the-feve/rocket-builder-web/README.md

# Rocket Builder Web

A website for designing a 3D-printable model rocket and downloading print-ready STLs. The plan is in `docs/web_platform_spec.md`.

The geometry is a Python port, on build123d (OpenCascade), of the Onshape FeatureScript generator in [OS_Rocket_Builder](https://github.com/the-feve/OS_Rocket_Builder) (`src/RocketGenerator.fs`). That generator stays the reference design.

| Folder | What |
|---|---|
| `geometry/` | `rocketgen`, the geometry engine: parameters in, one solid per part out, STL export. See `geometry/README.md` and `geometry/report.md`. |
| `server/` | The designer website: FastAPI + one page with a three.js preview. See `server/README.md`. |
| `docs/` | Platform spec and plan |

## Status

- **Phase 0 (spike):** done.
- **Phase 1 (feature parity with the FeatureScript):** done, apart from two cosmetic items listed in `geometry/report.md`.
- **Phase 2 (local web prototype):** done. Form → build → 3D preview (exploded, section) → ZIP of print-oriented STLs. Styled to match fevergeon.com / quiverdesignworks.net (same greys, accent and buttons); follows the system light/dark setting, with a header toggle to pin one. Works on iPhone and iPad: the preview fills and follows the screen through rotation, sits above the form on phones, renders only when the view changes, and uses 16 px touch-sized fields so iOS doesn't zoom.
- **Phase 3 (hosted beta):** in progress.
  - Done: stability check (Barrowman CP, CG from the parts + motor + recovery; under 1.0 cal the ZIP is withheld); standard fins auto-grow (span and sweep) until the heaviest motor of the size is stable; motor picker (flight sim of every motor in the bay, recommendation for a target altitude, per-motor stability); saved designs and share links (`/d/<id>`, SQLite, edit key per browser until sign-in exists), `Dockerfile`.
  - Ready to host: `/healthz`, per-address rate limits on new builds and saves, a 60 s wait limit for the build lock, error logging, three.js served from the app. CI (`.github/workflows/ci.yml`) runs both test suites and builds and smoke-tests the Docker image; `deploy.yml` deploys to Fly.io on every push to `main` once the `FLY_API_TOKEN` secret is set.
  - Live on Fly.io since 2026-10-09 at https://rocket-fevergeon.fly.dev.
  - Open: `rocket.quiverdesignworks.net` (after quiverdesignworks.net's DNS moves to Cloudflare; planned since 2026-10-11, formerly rocket.fevergeon.com); Cloudflare Access for the invite-only beta; checking a few designs against OpenRocket.

```
cd geometry && pip install -e ".[test]" && python -m pytest -q
python -m rocketgen.cli --fins swept --out out/m18_swept --png

cd ../server && pip install -r requirements.txt && uvicorn app:app --reload   # open http://127.0.0.1:8000
```

Or in Docker, from the repo root: `docker build -t rocket-builder . && docker run -p 8000:8000 -v rocket-data:/data rocket-builder`.

## Hosting

Fly.io, app `rocket-fevergeon` in Seattle (`fly.toml`): one 1 GB machine that sleeps when idle, and a 1 GB volume at `/data` for saved designs. Every push to `main` redeploys through GitHub Actions. Planned address `rocket.quiverdesignworks.net` (Quiver Design Works hosts everything paid; decided 2026-10-11), a CNAME in quiverdesignworks.net's Cloudflare DNS, with Cloudflare Access in front during the invite-only beta.
