the-feve/rocket-builder-web/HANDOFF.md

# Handoff

_Last updated 2026-10-18 (guide and tutorial changes; brand kit, curriculum, assembly guide and kit packaging in docs/)._ Read this first, then `TODO.md` (ordering, payment and data to-dos), `README.md` (Status) and `docs/web_platform_spec.md`._

## Where things stand

- **Owner links in the app (2026-10-18):** `/api/auth/me` carries `is_admin` (email in `ROCKETGEN_ADMIN_EMAILS`). Signed in as the owner, the account window shows *Owner: Order desk ↗* (quiverdesignworks.net/admin/orders) and *Printed-rocket orders* (`/admin`); *My orders* in the ⋯ menu and its dialog link the order desk too. Customers never see them.
- **Motor cap lip 2.5 mm (2026-10-18):** `params.CAP_LIP`; the nozzle hole is the motor diameter less 5 mm. Kit test prints regenerated (reprint the caps, E).
- **Secondary pages in the brand (2026-10-18, branch `claude/admiring-maxwell-c5difl`):** `/sources`, `/ordersupplies` (both builders), `/terms` and `/admin` now use the app's look: shared `server/static/brand.css` (tokens, self-hosted fonts, light/dark with the saved `theme`, `.rb-header`, `.rb-tag`, `.rb-step`, `.rb-tip`, `.rb-chips`, `.rb-footer`) and `server/brand.py` (`HEAD` links and `header(page, nav)` with the mark) for the server-rendered pages. The `/terms` HTML moved from `app.py` into `terms.page()`. The static pages copy the header markup by hand. Reuse `brand.css` for new pages.
- **Lug bore and kit test prints (2026-10-18, branch `claude/admiring-maxwell-c5difl`):** launch lug bore is now 4.0 mm on a 1/8 in rod (`lugs.LUG_BORE_CLEARANCE` = 0.4125 mm per side, was 0.3: the owner's lugs were a little too snug); rod standoff clip unchanged. `docs/kits/test-prints/` has print-ready STLs, `design.json`, the app ZIP, a README and a preview per kit (Starter M18 300 mm, Big M24 360 mm, Mini M13 190 mm), from `tools/make_test_prints.py` (rerun after geometry changes). All three built stable as designed; no adjustments.
- **Session of 2026-10-18 (PR #39, merged and deployed 2026-10-18):** plan in `docs/expansion_spec_2026-10.md`.
  - App (`server/static/index.html`): the quick start opens with *How it works* only; the stability explainer and a new motor letters / sizes / field table are in a collapsed *More on rocket sizing and rating systems*. Altitude ranges come from `flight.simulate` at typical printed masses and the fields from `FIELD_M`. Full guide: new *Sizing a rocket* section. Added a *Restart tutorial* button by the mode switch, an (i) help pop-up on every Advanced section, more dimming in the tutorial (inactive steps show only their heading) and shorter Beginner text. Step 3 now says body pieces *slide* together (only the motor cap is threaded). `gear.json`: the motor pack note no longer says "start with an A" (A8 fails for most printed 18 mm rockets).
  - `docs/brand/`: brand kit ("fins are fletching"), `tokens.css` using the app's token names, logos, patterns, `brand-sheet.png`. **Not applied to the app yet**: owner to decide (suggestions at the end of `brand.md`).
  - `docs/curriculum/`: a 10-day (or 5-day) home-school unit for grades 5–8, with printable `worksheets.html` (`tools/gen_ws.py`).
    - **On the site at `/learn/`** (overview for parents, `/learn/day-01` … `day-10`, `/learn/safety`, `/learn/worksheets` and `/learn/worksheets.pdf`): static pages in `server/static/learn/`, generated by `docs/curriculum/tools/build_site.py` (rebuild after editing a lesson; see the curriculum README's Files table). `learn.css` is hand-written with the brand tokens. Routes in `app.py` whitelist the page names. Linked from the app header (Free lessons), the quick start and quiverdesignworks.net.
  - `docs/assembly/`: a 7-page printable assembly guide (`assembly-guide.pdf`) with renders from rocketgen (`tools/README.md` regenerates them). **Owner questions** in its section of `TODO.md`.
  - **Second round (same day):** the brand is applied to the app (tokens, fonts, header mark, favicon in `server/static/brand/`, a ⋯ menu for less-used design actions, segmented view options, a ▾ download menu and folding sections in Advanced). `launch.html` is redrawn in the kit-art style (the launch API now returns `shape`). **Shock-cord clearances are sized for elastic** (`params.py → SHOCK_CORDS`, 3.6 mm per cord pass; M13/M18 noses got a deeper tie-bar recess; see `geometry/report.md`). The assembly guide is re-rendered from the new geometry, with medium CA glue (adult only) and elastic cord. Owner decisions: kits and motor flights are **12+**; the curriculum's under-12 track is paper rockets only; no Kevlar.
  - **Third round (2026-10-18, branch `claude/admiring-maxwell-c5difl` again):** unsafe designs now launch in the simulator, with a red *Watch it launch* / *Launch anyway* and a "Not safe to fly" panel. `flight.launch_profile` takes the motor's `margin_cal` and the rocket's length: under 1 cal a pitch model (`PITCH_K`, `PITCH_DAMP`, `TIP_OFF`) makes it wobble, under 0 it tumbles with side-on drag; `flight_dangers()` lists the reasons in plain words. Path points carry the attitude. The launch API flies the closest motor when none passes. The simulator can fly up to 3 other rockets alongside as see-through ghosts (this visit's builds and saved designs, via `sessionStorage.rbCompare`, written by the designer) with a comparison table. The quick start is laid out like the printed guides (kicker, big heading, short steps, one main button, links), and the fonts are self-hosted in `server/static/fonts/` (OFL), no Google request.
  - `docs/kits/`: kit lineup (Starter M18 $29.99, Big M24 $39.99, Mini M13 $16.99, classroom 6-pack $99), BOM and costs, packaging dielines and artwork, compliance notes, AI design tool research, and draft `products.json` entries for quiverdesignworks-site (not applied).
- Everything is on `main` and deployed (latest: PR #29, personal-use file license, 2026-10-15). No open PRs. Also live at https://rocket.quiverdesignworks.net.
- **Session of 2026-10-14/15 (PRs #23–#29), newest entries below:** heights snap to ones that build (printer step before height), build retry after a restart, big order buttons, score advice outside 1–2 cal, order names with motor + customer code, parachute size, report divider, compare two rockets, launch field size, paid print orders through Stripe (**not switched on yet: Next steps 7**), personal-use file license. Parallel sessions had duplicated work (PR #21 closed unmerged; PR #22 kept); check open PRs and `git branch -r` before starting.
- **Start here next session:** owner switches on paid orders (Next steps 7: restricted Stripe key, webhook, `ROCKETGEN_PUBLIC_URL` on Fly) and sets real prices / shipping in `server/shop.json`; one real order + refund from a normal browser. Then the open items in `TODO.md` (lawyer look at `server/terms.py`; beta print-and-fly checks).
- **Live since 2026-10-09: https://rocket-fevergeon.fly.dev** (Fly app `rocket-fevergeon`, region `sjc`, volume `rocket_data` mounted at `/data`). PR #1 is merged; pushes to `main` deploy automatically. Checked after the first deploy: `/healthz`, an M24 build (24.7 s cold, stable 1.13 cal, recommends C11), preview GLB, the STL ZIP, saving a design and its `/d/<id>` share link (test design `WNePTzVr`). The machine auto-suspends after about 7 idle minutes; a cold boot takes about 17 s before uvicorn answers.

- **Ordering switch (2026-10-15, owner: "not ready to start selling"):** printed-rocket ordering is **closed to the public by default**. Customers see a grey *Printed rockets: coming soon* panel instead of the order button, and `POST /api/orders` answers 403. Admin accounts (`ROCKETGEN_ADMIN_EMAILS`) still get the button and can place coupon or paid orders, so the whole flow (Stripe, webhook, `/admin`, PC sync, the QDW order desk) can be tested. **To open it:** `fly secrets set ROCKETGEN_ORDERING=open -a rocket-fevergeon` (unset it to close again). `/api/options` has `ordering_open`; users carry `can_order`.
- **Builder switcher (2026-10-15):** the header (and `/ordersupplies`) has a *Rocket Builder | Trebuchet Builder* control (`nav.apps`), the same one Trebuchet Builder shows.
- **Advanced additions (2026-10-17, owner's requests; branch `claude/inspiring-mayer-m1ipwo`, PR):** (1) a **Fits and joints** fieldset: joint clearance (radial; default `fit_slip` 0.02), body and nose joint lengths, thread clearance (0.25), pitch (2.5 / 3) and turns (3). Blank = the computed value, shown as the placeholder; `DesignParams.joint_clearance / shoulder_len / nose_shoulder_len / thread_clearance / thread_pitch / thread_turns` (None = as before) feed `compute_derived` and `thread_geometry`. Beginner mode sends nulls. Test: `test_critical_fit_overrides`. (2) **Download STEP (ZIP)**: `/api/builds/<id>/rocket_step.zip`, one STEP per part in print orientation, licence as a `/* */` comment after the first line, same notes / LICENSE / design.json. (3) **Generate test fit parts** link under the downloads (Advanced only) to `https://fit.quiverdesignworks.net/?motor=..&wall=..&offset=..#rocket`, which opens Fit Test Builder's Rocket tab with this rocket's inputs (owner asked for this link; the fit site is otherwise still unlisted).
- **Fit Test Builder hosted here (2026-10-17, PR #37; live and unlisted at https://fit.quiverdesignworks.net, CNAME DNS-only to `rocket-fevergeon.fly.dev`, Fly cert issued):** `server/fit_mount.py` loads the-feve/3D_print_test_fitter's `server/app.py` from `fittest/` (`FIT_DIR` overrides) and mounts it at `/fit/`; `HostRouter` now takes a host → prefix map and sends `fit.*` hosts there. Unlisted (owner, 2026-10-16): every response carries `X-Robots-Tag: noindex` and nothing links to it until the owner says; `ROCKETGEN_FIT=admin` makes it admin-only (404 to others). It shares this app's build lock. `deploy.yml` checks out that repo's `main` with `FIT_REPO_TOKEN`, or `TREBUCHET_REPO_TOKEN` if that token also lists the repo, and checks `/fit/` answers; also redeploys on a `fit-updated` dispatch. Tests: `server/tests/test_fit_mount.py` (the integration tests skip without the checkout; run locally with `FIT_DIR=../3D_print_test_fitter`). **Owner steps:** that repo's `HANDOFF.md` → Hosting setup (step 1, the `FIT_REPO_TOKEN` secret, comes first). Claude has no Fly or Cloudflare tokens (owner's choice).
- **Trebuchet Builder shares this Fly app (2026-10-15, owner's choice: no second app to pay for):** `server/trebuchet_mount.py` loads the-feve/trebuchet_builder from `trebuchet/` (repo root; `/app/trebuchet` in the image; `TREBUCHET_DIR` overrides) and mounts it at `/trebuchet/`; `HostRouter` sends `trebuchet.*` hosts there too, so trebuchet.quiverdesignworks.net/ is its page once DNS is set up. No checkout = the rocket app runs alone and `/trebuchet/` is a 404. `deploy.yml` checks out its `main` with `TREBUCHET_REPO_TOKEN` (skipped with a warning if the token or branch is missing), also runs on a `repository_dispatch` `trebuchet-updated` from that repo, and checks `/trebuchet/` answers. CI's Docker job builds with an empty `trebuchet/`. Tests: `server/tests/test_trebuchet_mount.py` (the integration test skips without the checkout; run locally with `TREBUCHET_DIR=../trebuchet_builder`). **Owner setup: Next steps 8.**

### What the designer does now (`server/`, FastAPI + one page with a three.js preview)
- Form → build → 3D preview (exploded, section) → ZIP of print-oriented STLs + `build_notes.txt` + `design.json`.
- Dark theme by default, light toggle (remembered in localStorage).
- **Stability check** (`geometry/rocketgen/stability.py`): Barrowman CP, CG from part centroids + loaded motor + recovery allowance. CG (blue) and CP (red) balls on the model. Under 1.0 cal with the chosen motor the ZIP is withheld (409).
- **Auto-sized fins** (`build_stable`): standard fins grow in span and sweep (not root: a longer root moves the CP forward) until the heaviest motor of the size is stable. M24 1.48x, M24L 1.52x, M29 1.91x; M18/M13 unchanged. Rectangular on M29 hits the 2.5x cap at 0.76 cal and is reported unstable. Custom fins are left as typed.
- **Motor picker** (`geometry/rocketgen/flight.py`, ported from OS_Rocket_Builder `tools/motor-picker.html`; data `geometry/rocketgen/data/web_motors.csv`): every Estes motor for the bay flown in a 1-D sim; checks 5x thrust-to-weight, 15 m/s off the rod, 30 m apogee, and stability with that motor's mass. Recommends the closest safe motor to the target altitude, with its delay. Clicking a row re-checks stability with that motor.
- **Saved designs + share links** (`server/designs.py`): SQLite at `ROCKETGEN_DB`; `/d/<id>` links; an edit key per browser stands in for sign-in. "My rockets" list in localStorage.
- **Site look and iOS/iPad (2026-10-14):** the designer uses fevergeon.com / quiverdesignworks.net's palette (their shared stylesheet: neutral greys, `#0a58ca`/`#6ea8fe` accent, ink-on-paper primary button), follows the system light/dark setting (header toggle pins one) and links back to both sites. iOS: the canvas is absolutely positioned and sized from `#view` (it used to prop the layout open, so the preview didn't follow rotation), `dvh` heights, safe-area insets, pixel ratio capped at 2, render on demand, 16 px fields (no focus zoom), decimal keypad. Phones (≤ 800 px) show the preview above the form with a pinned Build bar and the guide as a full-screen sheet; iPad portrait gets a 320 px form column.
- **Advanced: wall thickness and Body OD offset (2026-10-09):** *Wall thickness* (0.8-3 mm, default 1.5 from the settings CSV) sets the body tubes, nose cone and motor mount (`DesignParams.wall`); the stock tube is the motor bay + 2 walls. *Body OD offset* replaces the absolute Body OD: radial mm over the stock tube (5 = +10 mm diameter), shown live as "Body OD … (stock … + 2 × …)" under the field. The server turns it into `body_od_override`; designs saved with the old override still build and open as the matching offset.
- **Nose insert and cord strap (2026-10-09, after the owner's first prints/preview):** nose shoulder 30% shorter than body joints; the anchor strap is now a straight bar across the bore (wall to wall) with the cord gap behind it and a 45-degree pointed arch underneath (prints without supports). Details in `geometry/report.md` (Deliberate differences).
- **Printer first, tutorial buttons, save names (2026-10-14):** Beginner step 3 is now the printer height and step 4 the rocket height (the report's "try" hints point at the right steps). Saved names (and downloaded design files) get `_<motor>_<fin>_<height>`, e.g. `Zoomer_M18_Trapezoid_340`; the name box shows only the name, and the suffix is stripped and rebuilt on each save. Height snapping and the step-7 buttons: next entry. PR #21 (`claude/height-steps`) was a parallel attempt at the same snapping, superseded by this one.
- **Print orders (2026-10-14):** *Order a printed rocket* under the stability score (stable designs only; must be signed in, so a grown-up account). Form: quantity 1–5, colour, US shipping address, notes, coupon code. `POST /api/orders` rebuilds (or reuses the cached build), then `server/orders.py` saves the order (`orders` table) and its folder `ROCKETGEN_ORDERS_DIR/<batch>/<order id>/` (on Fly `/data/orders`): STLs, `ORDER.txt` batch sheet (customer, address, parts checklist, stability, motor), `order.json`, `design.json`, `build_notes.txt`. Ids `RB-YYYYMMDD-NNN`, batch `BYYYYMMDD` (UTC day). **No payment yet:** a valid coupon (`ROCKETGEN_COUPON_CODES`, comma-separated, case-insensitive) is required and the order is $0; otherwise 402. Limit `ROCKETGEN_ORDERS_PER_DAY` (10) per address. The owner is emailed through Resend (`server/notify.py`: `RESEND_API_KEY`, `ROCKETGEN_NOTIFY_TO`, `ROCKETGEN_MAIL_FROM`; skipped if unset). *My orders* shows the customer's orders and status. **Owner side:** `/admin` (signed in with an email in `ROCKETGEN_ADMIN_EMAILS`) lists orders, sets status (new / printing / shipped / cancelled) and downloads each order's files; `tools/sync_orders.py` (+ `.bat`, `tools/README.md`) copies new/changed order folders to `C:\RocketOrders\<batch>\<order>\` using `ROCKETGEN_SYNC_TOKEN` as a Bearer token. Not yet: payment (Stripe), customer confirmation emails (needs a verified sending domain in Resend), shipping cost, address validation, non-US addresses.
- **Order Rocket Supplies page (2026-10-14):** `/ordersupplies` on this app (rocket.quiverdesignworks.net), rendered by `server/supplies.py` from `server/gear.json` (moved here from fevergeon-site; fevergeon.com/cad/rocket-builder/gear/ now redirects here). 12 categories, 43 Amazon links with Store ID `quiverdesig09-20`, the disclosure "As an Amazon Associate, I earn from qualifying purchases." at the top and bottom, no prices. **Pictures:** each item shows a drawing of its category (`supplies.ICONS`), because Amazon only allows its product images when fetched live through its Creators API (which replaced PA-API; needs 10 qualifying sales in 30 days); an item can instead carry `"photo": "/static/gear/<file>.jpg"`, the owner's own photo. A **First launch starter kit** box sits at the top (`gear.json → starterKit`: five list items, each with a one-line reason). Motor items carry `"motors": ["B4-4", …]`; `/api/options → motor_links` maps each motor to its Amazon packs, and the report's recommended motor gets a *Get B4-4 motors on Amazon* button (single packs first, the variety pack as a second link; if only another delay is listed, it links that and says which delay suits the rocket), with the disclosure next to it. The app links to it as *Order Rocket Supplies* in the header, an *Order rocket supplies* button under the score, and a "Need to get your own supplies…? Order through my link here to support me!" note at the top of the welcome and the full guide. `ROCKETGEN_SUPPLIES_URL` overrides the address.
- **Accounts (2026-10-14, owner chose email + password):** `server/accounts.py`: `users` and `sessions` tables in the designs SQLite file; scrypt password hashes (stdlib); a 30-day session token in the `rb_session` cookie (HttpOnly, SameSite=Lax, Secure over https), stored as its SHA-256. Endpoints: `POST /api/auth/signup` (needs `age_ok`: 13+ or a parent/guardian, because the site is used by children; COPPA), `/api/auth/login`, `/api/auth/logout`, `GET /api/auth/me`, `GET /api/my/designs`, `POST /api/my/claim` (moves this browser's designs, proved by edit keys, into the account; runs on every sign-in). Designs saved signed in get `owner`; the owner can edit from any browser (`_owned` accepts owner or edit key). Page: *Sign in* in the header (two clicks to sign out), a sign-in / create-account dialog, *My rockets* lists the account's designs when signed in. Sign-up/sign-in share a rate limit (`ROCKETGEN_AUTH_PER_10_MIN`, 20). Not yet: password reset (needs the email service), deleting an account, a privacy policy page (needed now that emails are stored).
- **Printer before height, heights that build (2026-10-14):** Beginner step 3 is now the printer max height and step 4 the rocket height (the printer decides which heights work). `GET /api/heights?motor&print_max_height&fin_shape&nose_shape` returns the overall heights that build as `[first, last]` ranges plus `printer_min`, the lowest printer height that builds any rocket of that motor size (`rocketgen.build.height_ranges` / `min_printer_height`, built on `plan_rocket`, which runs all of `build_rocket`'s checks without solids; a 5 mm scan refined to 1 mm at each edge, under 1 s, `lru_cache`d). A height counts only if it works with plain fins **and** fins auto-sized to the 2.5x limit: grown fins trail further below the tail, so the body is shorter for the same height; checking only plain fins let an M29 at 276 mm through, whose corrective rebuild failed and came out 311 mm. The page snaps the height to the closest one that builds (in the direction it was moved) and a too-short printer up to `printer_min`, with a note under the height field and the allowed range. Sweeps found no gaps in the middle: real builds at every segment-count transition (5 motors × printers 150/200/250) all succeed; what fails is a height too short for the motor bay and fins in the aft segment (Beginner minimums at a 200 mm printer: M13 148–174 mm, M18 201–236, M24 235–281, M24L 260–306, M29 309–364, by fin shape) or a printer too short (M24 < 101 mm, M29 < 133). `_build_to_length` now repeats the corrective rebuild (up to 4 rounds) until the height is within 0.5 mm: a shorter body needs bigger fins, which trail further, so one round left M18 swept at 236 mm coming out 242.7 mm (pre-existing). Checked exact at the new minimums, 16–20 s each. If a corrective rebuild fails (a height typed below the range), it keeps the last build instead of erroring. The step-7 Build bar is no longer sticky during the tutorial, so Back / Finish without building sit in their own row under it (Finish styled as the secondary button).
- **Build retry on a server hiccup (2026-10-14):** a build that was running while a deploy replaced the machine got an empty reply, and the page showed "JSON.parse: unexpected end of data". `postBuild` in `index.html` now retries once after 4 s on an empty, non-JSON or failed reply, then says the server didn't answer (it may have restarted for an update) and to press Build again, instead of telling the user to change their settings.
- **Launch in the 3D view, printer picker, sources, combined supplies (2026-10-15, owner's requests):** (1) *▶ Watch it launch* (`#launchbtn`, styled like Trebuchet Builder's *▶ Throw*) sits in the 3D view's bar once a build has a safe motor; it opens `#launchpane` over the canvas with `launch?build=<id>&embed=1` in an iframe (embed hides the simulator's header/intro and puts the flight first), and becomes *◀ Back to 3D model* (Esc too). The scene and report are untouched, so no rebuild; the report's launch links (`a[data-launch]`) open the same panel; a new build or the guide closes it. (2) *Your printer* select above *Printer max height* (both modes): Bambu A1 mini 180, A1/P1S/X1C 256, Prusa MINI+ 180, MK4S 220, CORE One 270, Ender-3 V3 SE/K1 250, Neptune 4 Pro 265 mm (makers' build heights, checked 2026-10-15); picking fills the height (snap rules unchanged), typing another height shows *Other*. (3) `/sources` (`static/sources.html`): where each calculation comes from (Barrowman report, NASA Glenn beginner's guide pages, ThrustCurve.org, NAR Safety Code field table and 20 mph, OpenRocket), with our own assumptions tagged *Our choice*; linked from the guide, the full report's build notes and the launch simulator. Keep it in step when a constant in `flight.py`/`stability.py`/`params.py` changes. (4) `/ordersupplies` is now *Order supplies* with a Rocket Builder section and, when Trebuchet Builder is mounted, a Trebuchet Builder section read from its `treb_supplies` (ids `t-…`), with jump buttons. **No prices or cost tiers:** Amazon's Associates policy (Participation Requirements §2(b)) only allows prices from its API, and a $/$$/$$$ tier is still a price claim.
- **Launch simulator (2026-10-15, owner's request):** `/launch?build=<id>` (`server/static/launch.html`, linked as *▶ Watch it launch* in the Beginner field card and *Launch simulator* in the full report's build notes). Side view animates the flight (real time going up, 4× under the chute): rod, boost with flame, coast, chute opens at burnout + delay, drift, landing spot; then stat tiles and a top-down field (NAR square dashed, pad, landing). Wind slider 0–25 mph (warns over 20), motor and delay pickers. Server: `GET /api/builds/{id}/launch?wind_mph&motor&delay` → `flight.launch_profile` (2-D point mass, wind along +x; off the rod the thrust points along the airflow, so the rocket weathercocks upwind; drag of body + flat chute, opening over 0.5 s, on the air-relative speed; lands with the empty casing) and `flight.launch_field` (length = upwind margin (¼ NAR side, or 1.25 × upwind travel) + 1.25 × downwind drift, at least the NAR side; width = NAR side). Default B6-4 at 10 mph: 131 m up, lands 81 m downwind, 170 × 60 m field. The report's existing *How big a launch field?* card (fixed 10 mph, drift from apogee) is unchanged. Builds live in memory, so after a restart the page says to build again.
- **File license: personal use only (2026-10-15, owner's request):** `server/terms.py` holds the wording (Quiver Design Works LLC copyright; print, fly and modify for yourself; no sharing, uploading or remixing on MakerWorld, Printables, Thingiverse, Thangs, Cults3D, MyMiniFactory, file links, Discord or social media; no selling files or prints without permission; as-is, safety and liability lines). Used in `LICENSE.txt` in every ZIP and order folder, the top of `build_notes.txt`, `design.json → license`, each STL's 80-byte header (`(c)2026 QDW. Personal use only. No sharing. rocket.quiverdesignworks.net/terms`; the STLs still load), the `/terms` page, a note under the download button, step 1 of the Beginner "What's next?", the order dialog and a *Your files* section in the full guide. Not reviewed by a lawyer: worth a look before paid launch.
- **Paid print orders (2026-10-15, owner chose: own Stripe checkout, base + per gram, weight-and-box shipping):** `server/shop.py` + `server/shop.json`. Price per rocket = `baseCents` + `perGramCents` × printed grams, rounded up to 50¢ (now $12 + 15¢/g: the default 45 g rocket is $19). Shipping: the parts are packed lying down into the smallest box in `shop.json` that fits the longest part, the widest (aft with fins) and 1.3× their bounding volume; packed weight = parts × quantity + box + padding; USPS Ground Advantage estimate from the `rates` table (dimensional weight over 1728 in³); US only. `GET /api/orders/quote?build_id&quantity` feeds a price table in the order dialog. Without a coupon, `POST /api/orders` saves the order as `awaiting_payment` and returns a Stripe Checkout URL (hosted page on the shared account, `metadata.store = rocket-builder` on the session and PaymentIntent, automatic WA tax, Stripe collects the US address, statement `* ROCKET`, expires after an hour). `POST /api/stripe-webhook` (signature checked with `STRIPE_WEBHOOK_SECRET`; other stores' events ignored) marks it paid (`new`, Stripe's address, amounts) and emails the owner, or `expired`. Waiting/expired orders stay off `/admin` and the PC sync. A coupon still makes a free order with the address typed in the form. Paid orders ship through the store's Pirate Ship CSV (quiverdesignworks-site `store.json → alsoShip`). Checked: a real sandbox Checkout Session (2 rockets: $38.00 + $7.25 shipping, tax on, tag set), expired straight away. **Owner setup before it takes money:** see Next steps 7.
- **Compare rockets, launch field (2026-10-15):** *Compare with another rocket* (button in both reports) opens `#cmpdlg`: the rocket on screen vs one built earlier this visit (kept in memory, newest 10: instant) or one from My rockets (built on request through `/api/build`). A table (motor, height, body width, fins, nose, score, best motor, altitude, liftoff weight, plastic, parts, parachute, field) ticks the better value per row (closer to 1–2 cal, higher, less plastic, fewer parts, smaller field), then "How they differ" in words (what changed, which is closer to the sweet spot, flies higher, uses less plastic, has fewer parts) and each rocket's summary with its first improvement tip. All client-side. **Launch field** (`flight.field_size`): the NAR minimum side for the recommended motor's class, or longer when the rocket drifts further than that under its suggested parachute from apogee in a 10 mph breeze (drift = apogee / descent rate × 4.5 m/s); a "How big a launch field?" card (m, ft, football fields, where to put the pad), a line in the full report and `build_notes.txt`. Replaces the old "Launch site" line.
- **Order names, parachute, report divider (2026-10-14):** orders get a name `RB-20261014-001_M18_C7KQ2MX` (motor size + a customer code: `orders.customer_code`, C + 6 base32 characters of a hash of the account id, the same on every order from one account, no email in file names); it names the order folder, the admin page heading, the files ZIP and the PC sync's folder (older orders keep their id). Every build suggests a parachute (`flight.parachute`): the smallest standard size (12/15/18/24/30/36 in) that lands the rocket after burnout (printed + recovery + empty motor casing of the recommended motor) at ≤ 4.5 m/s, flat chute Cd 0.75; a streamer is mentioned under 40 g; linked to the supplies list's chute of that size (`supplies.parachute_links`, sizes read from the item names); a "Which parachute?" card in the Beginner report, a line in the full report and `build_notes.txt`. A drag handle between the 3D view and the report (`#vsplit`) sets the report's height (remembered in `localStorage.reportHeight`; arrow keys nudge, double-click resets; hidden on phones and before the first build).
- **Power and launch-speed bars (2026-10-15, owner: "why doesn't it fly safely?"):** the Beginner *How high will it go?* card shows two meters styled like the stability one (`barHtml` / `powerHtml` in `index.html`): **power** = thrust ÷ liftoff weight on a 0–15× scale (red under 5×, the `MIN_THRUST_TO_WEIGHT` limit) and **speed off the rod** on 0–30 m/s (red under 15, `MIN_ROD_SPEED`), for the recommended motor. When no motor passes (`noMotorHtml`) it shows the closest motor's bars (fewest problems, then most power), the liftoff weight that would give 5× with it (thrust is fixed, so `liftoff_g × T/W ÷ 5`), each failing reason in plain words with the motors it hits (`WHY_NOT`, keyed on the problem strings from `flight.simulate`; keep them in step), and what to try. Front end only; no API change.
- **Score advice (2026-10-14):** outside the 1–2 cal sweet spot, the build response carries `stability.advice` (`rocketgen.stability.advice`): an intro and the changes that help, best first, each with a predicted score where it can be worked out without rebuilding: rocket height (`Balance.predict_length`: the `Seg_*` middle of the body grows or shrinks at its measured g/mm, the anchor section, nose and parachute slide with the top; within about 0.1 cal of real rebuilds for 150–600 mm changes), fin shape / count / custom size (`Balance.predict`, fin blades swapped as in the auto-size), a lighter or heavier motor of the same size, nose weight in grams (unstable only), and a skinnier body (Advanced, body OD offset). Beginner advice uses step numbers and only Beginner levers. Shown as a "How to make it stable" / "How to get into the 1–2 sweet spot" box in the Beginner score card and under the margin in the full report.
- **Order buttons after a build (2026-10-14):** *Order it printed for you* (blue) and *Order rocket supplies* (amber) are big side-by-side cards with an icon and a one-line subtitle (`.orderrow` in `index.html`), in the Beginner and full reports; they stack on phones.
- **Opening and tutorial, v2 (2026-10-14):** the form opens locked (greyed, `inert`) with the welcome guide showing and a bar on top (*Start the tutorial* / *Skip tutorial* / *Go to Advanced*); share links and accounts with the *skip tutorial* setting open unlocked. The tutorial now has 7 steps: step 1 is *Make an account* (grown-ups; optional, shows "Signed in as…" once done). Account settings: the header button (signed in) opens an account panel with *Skip the tutorial when I sign in* (`users.prefs`, `POST /api/my/prefs`; also a checkbox on the welcome screen), *My orders* and *Sign out*. The design panel is resizable: drag the handle between it and the 3D view (260 px to 60% of the window, remembered in `localStorage.formWidth`; arrow keys nudge; double-click resets); hidden on phones.
- **Guided tutorial (2026-10-14):** every launch starts in Beginner (the mode is no longer remembered; a saved Advanced design still opens in Advanced). The quick start's *Start designing* runs a tutorial: one step at a time (elements tagged `data-tstep="1".."6"`), everything else greyed out and `inert` (save bar and mode switch too), Back/Next under the step, a sticky progress bar with *Skip tutorial* and *Go to Advanced*. Building on step 6 (or *Finish without building*) ends it and unlocks the whole form; `localStorage.tutorialDone` remembers it, and the quick start then offers *Replay it*. The quick start also has *Skip tutorial* and *Go to Advanced*.
- **Kid-friendly Beginner mode (2026-10-14, owner: aimed at grades 3–7):** Beginner is numbered steps (now: account, motor size, printer height, height, fins, nose, build) with a plain-language "what this does" under each and "More about…" links into the full guide (`#guide-motors`, `#guide-stab`, `#guide-parts`). Motor text lists the real motors for the size from `flight_motors`; height has a slider (150–900 mm) plus the box, with cm / inches / 12-inch-ruler conversions; fins and nose are picture buttons (SVGs drawn in JS; the hidden selects, class `advshow`, are still sent). First visit shows a quick start (`#kidguide`: 4-step process, the cal score explained with a diagram, safety-code note, *Read the full guide*); the Guide button opens it in Beginner and the full guide in Advanced. The Beginner report is a stability-score meter (0–4 cal zones matching `stability.py`: <1 unstable, 1–3 stable, >3 over-stable) with what it means and what to try, the recommended motor with height in m/ft and as a building, its delay and field size, and next steps; the full report is under *Grown-up details*. On phones the report sits right under the 3D view. Save as new / Download file / Open file are Advanced-only. Server unchanged.
- **Beginner / Advanced modes (2026-10-09):** Beginner is the default (remembered in localStorage). It shows motor size, printer max height, **overall height** (nose tip to fin tips / motor cap), nose shape (no fineness) and three fin shapes (swept, delta, trapezoid; default trapezoid; no custom fins). Every other field is sent as the default. The server turns `overall_length` into `body_length` with `rocketgen.build.body_length_for` (exact, using `overall_length()`, which matches `Balance.length`); if auto-sized fins change how far they trail below the tail, `_build_to_length` rebuilds once. Switching modes carries the design over (body length ↔ overall height from the last build); Beginner resets the advanced fields. A saved design with `overall_length` opens in Beginner, any other in Advanced.
- **Build prompts (2026-10-09):** any change shows "Settings changed. Press Build…" above Build (and greys out the ZIP until rebuilt); a progress bar on the 3D view eases toward 95% while building (builds report no progress) with elapsed seconds.
- **User guide (2026-10-10):** before the first build the 3D view shows a guide (`#guide` in `index.html`): how to use the app, Beginner vs Advanced, each report section (stability margin, motor picker columns and pass criteria, parts, build notes, key dimensions), and what OpenRocket is and what to check in it. A **Key terms** glossary (2026-10-10, owner wants it educational) explains stability (CG, CP, calibers, margin, with a diagram, Barrowman), motors (size, the C6-5 code, thrust/impulse, thrust-to-weight), flight (rod speed, apogee, ejection delay, Cd, field size) and recovery/parts. It hides after a build; the **Guide** button reopens it, and the report's "OpenRocket" link jumps to that section. Keep it in step when the UI, the pass criteria (`flight.py`, `stability.py`) or the report change.
- **Design files (2026-10-09):** *Download file* saves `<name>.rocket.json` (`format`, `schemaVersion`, `name`, `mode`, `params`); *Open file* loads it, or the `design.json` from an STL ZIP, as an unsaved design and builds it.
- **Save flow (2026-10-09):** *New rocket* resets to defaults, asks for a name and saves. *Save* overwrites your own design silently. On an unsaved design, a shared one, or *Save as new*, it asks for a name first (copies suggest "<name> (copy)"). A status label shows *Not saved yet* / *Saved · yours to edit* / *Shared design*, and save messages are coloured, with errors caught. The owner found the old flow unclear: saving kept the shared design's name and showed only a small grey line.
- **Hosting guards:** `/healthz`; per-address limits (30 new builds / 10 min, 60 saves / hour); 60 s max wait for the build lock (then 503); failed builds logged with parameters; three.js r160 vendored in `server/static/vendor/` (no CDN).
- **Deploy plumbing:** `Dockerfile` (python:3.12-slim-bookworm), `fly.toml` (app `rocket-fevergeon`, region `sjc` (Fly no longer offers `sea`), shared-cpu-1x 1 GB, suspends when idle, volume `rocket_data` at `/data`), `.github/workflows/ci.yml`, `.github/workflows/deploy.yml` (deploys on push to `main`; skips with a notice until `FLY_API_TOKEN` is set).

## Next steps (in order)

0. ~~Pending merge: the Key terms glossary~~: merged to `main` (PR #6).
1. **Owner: Fly.io setup** (Windows PowerShell):
   1. Sign up at https://fly.io/app/sign-up and add a card under Billing.
   2. Install: `powershell -Command "iwr https://fly.io/install.ps1 -useb | iex"`, reopen PowerShell, `fly auth login`.
   3. `fly apps create rocket-fevergeon` (if the name is taken, pick another and change `app` in `fly.toml`).
   4. `fly volumes create rocket_data --region sjc --size 1 -a rocket-fevergeon` (answer `y` to the single-volume warning). `sea` returned "region sea not found"; use `fly platform regions` for the current list. The app's `primary_region` in `fly.toml` must match the volume's region.
   Steps 1–4 done 2026-10-09 (Google sign-in; no Fly password needed: `fly auth login` uses the browser).
   5. `fly tokens create deploy -a rocket-fevergeon -x 999999h`; copy the whole output including `FlyV1 `. Don't paste it in chat.
   6. GitHub → repo Settings → Secrets and variables → Actions → New repository secret: `FLY_API_TOKEN` = that token.
2. ~~Merge PR #1~~ and ~~check the first deploy~~: done 2026-10-09. The first deploy run skipped itself (green, 8 s) because `FLY_API_TOKEN` had been added to the fevergeon-site repo by mistake; once it was on this repo, a manual run of `deploy.yml` deployed.
3. **Still to confirm:** a saved design surviving a full restart (`fly apps restart rocket-fevergeon`, then open `/d/WNePTzVr`). Suspend/resume doesn't prove it; the volume mount in the boot log is good evidence.
4. **After quiverdesignworks.net's DNS moves to Cloudflare** (fevergeon-site `docs/squarespace-cutover.md`, nameserver switch due 2026-10-13 evening; quiverdesignworks-site `TODO.md` P2): `fly certs add rocket.quiverdesignworks.net -a rocket-fevergeon`, a CNAME `rocket` → `rocket-fevergeon.fly.dev` in Cloudflare, then Cloudflare Access (Zero Trust, free ≤ 50 users, email one-time PIN) in front for the invite-only beta. Note: with the Cloudflare proxy on, Fly's certificate check may need the record DNS-only until the cert issues.
5. **Beta checks:** print and fly one or two rockets; compare 2–3 designs against OpenRocket (stability and apogee). Results go in `geometry/report.md`.
6. **Phase 4:** paid downloads via the shared Stripe account, every Checkout Session tagged `metadata.store = "rocket-builder"` (rules in the-feve/quiverdesignworks-site `docs/stripe-shared-account.md`); check Washington sales tax on digital goods.
7. **Owner: switch on paid print orders** (code merged 2026-10-15; until then orders still need a coupon). Ordering stays closed to customers until `ROCKETGEN_ORDERING=open` (see *Ordering switch*), so these steps can be done and tested first:
   1. Stripe (live mode) → Developers → API keys → *Create restricted key* "Rocket Builder": Checkout Sessions **Write** (everything else None). In PowerShell: `fly secrets set STRIPE_SECRET_KEY=rk_live_… -a rocket-fevergeon` (don't paste it in chat).
   2. Stripe → Developers → Webhooks → *Add endpoint*: `https://rocket.quiverdesignworks.net/api/stripe-webhook`, events `checkout.session.completed`, `checkout.session.async_payment_succeeded`, `checkout.session.async_payment_failed`, `checkout.session.expired`. Copy its signing secret: `fly secrets set STRIPE_WEBHOOK_SECRET=whsec_… -a rocket-fevergeon`.
   3. `fly secrets set ROCKETGEN_PUBLIC_URL=https://rocket.quiverdesignworks.net -a rocket-fevergeon` (so Stripe sends customers back to the right address).
   4. Check the prices and shipping table in `server/shop.json` (a commit there redeploys). Then place one real order from a normal browser (never inside a Claude cloud session), check it on `/admin` and in quiverdesignworks.net/admin/orders, and refund it in Stripe.

8. ~~**Owner: switch on Trebuchet Builder hosting**~~ Done 2026-10-15 (PR #31 merged; live at https://trebuchet.quiverdesignworks.net, A/AAAA DNS-only `66.241.125.123` / `2a09:8280:1::1ae:4f69:0`, Fly cert issued). The steps, for reference:
   1. the-feve/trebuchet_builder needs a `main` branch: its only branch is `claude/vigilant-ramanujan-2e94u8`; rename it to `main` (GitHub → that repo → Settings → Branches / the branch list → rename), or create `main` from it.
   2. Read token: github.com/settings/personal-access-tokens → *Generate new token* (fine-grained), *Only select repositories* = trebuchet_builder, Repository permissions → Contents: **Read-only**. Save it in **rocket-builder-web** → Settings → Secrets and variables → Actions as `TREBUCHET_REPO_TOKEN`. Don't paste it in chat.
   3. Optional, redeploy when the trebuchet repo changes: a second fine-grained token for rocket-builder-web with Contents: **Read and write** (GitHub requires that for `repository_dispatch`), saved in **trebuchet_builder**'s secrets as `ROCKET_DEPLOY_TOKEN`. Without it, run this repo's *Deploy to Fly.io* workflow by hand after trebuchet changes.
   4. Merge the PR here; the deploy checks https://rocket-fevergeon.fly.dev/trebuchet/ answers. It is also at https://rocket.quiverdesignworks.net/trebuchet/.
   5. Own address: Cloudflare DNS → CNAME `trebuchet` → `rocket-fevergeon.fly.dev` (DNS only, grey cloud, until the certificate issues), then `fly certs add trebuchet.quiverdesignworks.net -a rocket-fevergeon`.

## Decisions log

- 2026-10-08: Phase 2 server moved here from OS_Rocket_Builder (`claude/phase2-web-prototype`). OS_Rocket_Builder's `web/` folder on that branch is redundant and can be deleted.
- 2026-10-08: Dark theme default.
- 2026-10-08: Unstable designs: option (c) chosen: keep the download block, and auto-size standard fins so every motor size's default design is stable. Keep the CG/CP preview and info.
- 2026-10-08: Motor picker built into the designer; motor masses come from its ThrustCurve table (`web_motors.csv`), replacing the earlier rough `web_motor_masses.csv`.
- 2026-10-09: Hosting: Fly.io for the app (persistent volume keeps SQLite simple), Cloudflare for DNS and Access. Cloudflare Containers rejected for now (no persistent disk; would need D1).
- 2026-10-09: Region `sjc` (San Jose): `sea` isn't available on Fly any more.
- 2026-10-09: The deploy workflow passes (green) when the token is missing; check that the run actually ran `flyctl deploy`, not just a green tick.
- 2026-10-09: Saving stays server-side (SQLite on the Fly volume) with per-browser edit keys until accounts arrive; a download/open design-file option is a possible extra (design.json is already in the ZIP).
- 2026-10-11: Address `rocket.quiverdesignworks.net` instead of `rocket.fevergeon.com`: Quiver Design Works hosts everything paid. The fevergeon-site repo was renamed `the-feve/quiverdesignworks-site`.
- 2026-10-15: Trebuchet Builder is hosted inside this Fly app (mounted ASGI app + host routing) rather than a second Fly app, to keep running costs at one machine. Its code stays in its own repo and is checked out at deploy time.
- 2026-10-14: Beginner mode is for young builders (about grades 3–7); the site look matches fevergeon.com / quiverdesignworks.net.
- 2026-10-09: Invite-only beta via Cloudflare Access rather than building sign-in; real accounts wait for public/paid launch.

## Open items / known limits

- Stability and flight numbers are estimates (Barrowman, 1-D sim, trapezoid fin planform, solid-PLA masses); not yet checked against OpenRocket.
- Motor masses are Estes ThrustCurve values; two are flagged (1/2A6 mass estimated; E9/E12 out of production).
- In-memory caches (last 40 geometries, builds, rate-limit counters) reset on every restart or Fly suspend; only saved designs persist.
- Saved designs have no owner yet (edit key in the browser). Sign-in replaces it when accounts arrive (`owner` column already exists).
- Two cosmetic geometry gaps from Phase 1 remain (leading-edge root fillet, some lug rounds); see `geometry/report.md`.

## Other repos

- **the-feve/fevergeon-site** (Astro on Cloudflare Pages, Quiver Design Works store with Stripe + Pirate Ship export). Live on a Cloudflare preview; DNS not moved; its `TODO.md` has the go-live list. Its Rocket Builder status lines were updated on 2026-10-09 to point at the live Fly app. Its default branch is still a `claude/…` branch; merging to `main` is on its P1 list.
- **the-feve/OS_Rocket_Builder**: the FeatureScript reference (`src/RocketGenerator.fs`, latest on `anchor-section`).

## How to run locally

```powershell
cd rocket-builder-web
python -m venv .venv; .venv\Scripts\Activate.ps1
cd server; pip install -r requirements.txt
uvicorn app:app --reload        # http://127.0.0.1:8000
```
Tests: `python -m pytest -q` in `geometry/` (~1.5 min) and in `server/` (~45 s).
