the-feve/rocket-builder-web/docs/curriculum/elementary/lesson-04.md

# Lesson 4: Fins and balance: why rockets fly straight

**Time:** about 45 minutes. **Worksheet:** E4 Swing test. **Rocket Builder:** on the projector. **Optional instructor demo:** a 3D-printed rocket (no motor).

## Standards

| Code | In plain words |
|---|---|
| **3-5-ETS1-3** | Run fair tests to find where a model fails and what to improve. |
| **3-PS2-1** | Test how balanced and unbalanced pushes change the way something moves. |

**Practice:** planning and carrying out investigations. **Crosscutting concept:** structure and function (the shape of the fins does a job).

## I can…

- I can find a rocket's balance point.
- I can test a rocket with no fins, with fins, and with weight in the nose, and say which flies straight.
- I can explain the rule: the balance point goes in front of the push point.

## Words to know

- **Fins**: the flat wings at the back of a rocket. They work like the feathers on an arrow.
- **Balance point**: where the rocket balances on your finger. Rocket Builder shows it as a **blue dot**.
- **Push point**: where the air pushes on the rocket. Rocket Builder shows it as a **red dot**.
- **Stable**: flies straight, nose first.

## Materials

For each group:

- A paper-towel tube, a cardstock cone for a nose, cardstock for 3 fins (about 6 cm × 5 cm), tape
- A walnut-sized lump of modeling clay
- About 1.5 m of string
- Worksheet E4

For the class: Rocket Builder on the projector. **Optional:** a printed Rocket Builder rocket (no motor) for the instructor to show.

## Steps

### 1. Hook (5 minutes)

Show an arrow, a dart or a badminton shuttle (or a picture). Ask: *Why does it fly point-first? What would happen without the feathers?*

### 2. Learn (10 minutes)

> **Fins are a rocket's feathers.** They keep the nose pointing forward.
>
> Every rocket has a **balance point**, where it balances on your finger. And it has a **push point**, where the air pushes on it. Here's the rule: **the balance point must be in front of the push point.** Then if the rocket tips, the air pushes the tail back in line, like a weathervane.
>
> Fins at the back move the push point back. Clay in the nose moves the balance point forward. Both help.

**On the projector:** build a rocket in Rocket Builder. Find the **blue dot** (balance point) and the **red dot** (push point). Change the fin shape and build again. Watch the red dot move. If the score is green, it's stable.

### 3. Do: the swing test (20 minutes)

Go outside or to a big open room. Nobody stands within 3 m of the swinger.

1. Build the rocket with **no fins**. Balance it on a finger to find the balance point. Tie the string there and tape it.
2. Swing it in a circle beside you. Does the nose lead? Tick **straight**, **wobbly** or **tumbles** on E4.
3. Tape on **3 fins**. Find the new balance point, move the string there, and swing again.
4. Press **clay inside the nose**. Find the balance point again and swing.
5. **Bonus:** move the clay to the **tail**. What happens?

### 4. Wrap up (10 minutes)

- Which version flew straight? Which one failed?
- Why did clay in the tail make it worse? (It pulled the balance point back, behind the push point.)

## Check for understanding

1. What do fins do for a rocket?
2. Which dot must be in front: the blue balance point or the red push point?
3. Your rocket tumbles. Name one thing you could change.

**Answer key**

1. They keep it flying straight, nose first (like the feathers on an arrow).
2. The blue balance point.
3. Add fins or make them bigger; add a little clay to the nose.

## Teacher notes

- **What to expect:** no fins usually tumbles; fins help; fins plus nose clay flies straight; tail clay wobbles or tumbles.
- **Grade 3:** test only "no fins" and "fins plus nose clay". **Grade 5:** measure the balance point from the nose tip each time and write it down.
- **Swing safety:** a short string (about 1 m), a clear space, one swinger at a time.
- **Optional instructor demo, a 3D-printed rocket:** show a printed Rocket Builder rocket with **no motor in it**. Balance it on one finger to find its balance point, point at the fins, and compare it with the blue and red dots on the screen. Students can hold and look at it. Motors are rated 12+ and only adults handle them, so the demo never includes a motor or igniter.
- **Further resources:** Apogee Components' free *Rocketry Reservoir* (apogeerockets.com/downloads/PDFs/Rocketry_Education_Pack.pdf) has printable pages on the parts of a rocket and on centre of gravity and centre of pressure that you can project or hand out.
