the-feve/rocket-builder-web/docs/brand/brand-sheet.pdf

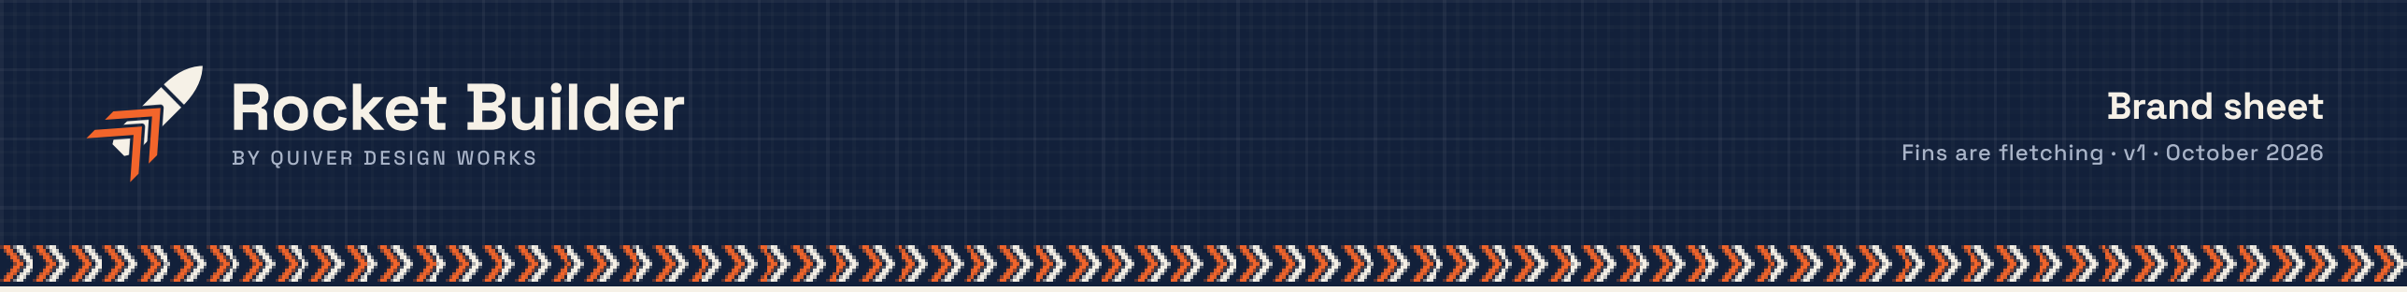
[picture p7: figure]
Brand sheet; Fins are fletching · v1 · October 2026

01 LOGO

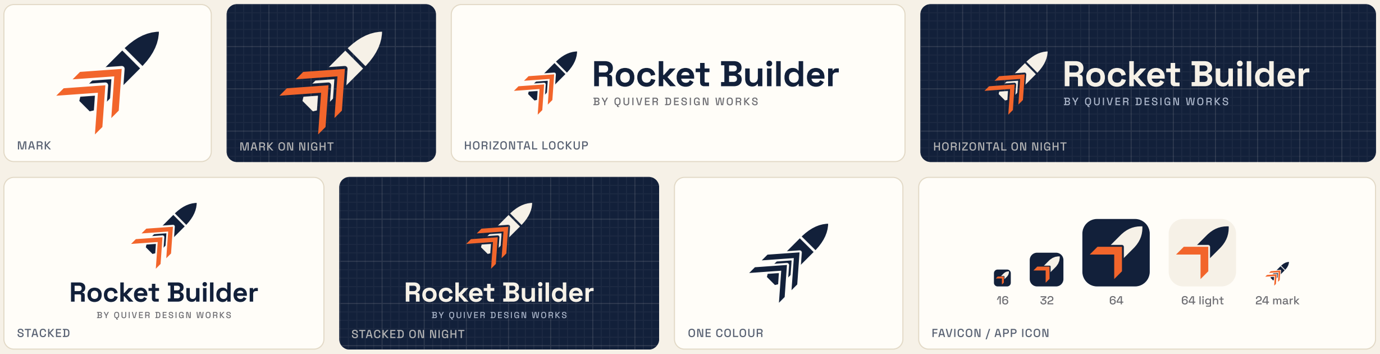
[picture p8: figure]
MARK; MARK ON NIGHT; HORIZONTAL LOCKUP; HORIZONTAL ON NIGHT; STACKED; STACKED ON NIGHT; ONE COLOUR; 64 light; 24 mark; FAVICON / APP ICON

02 COLOUR

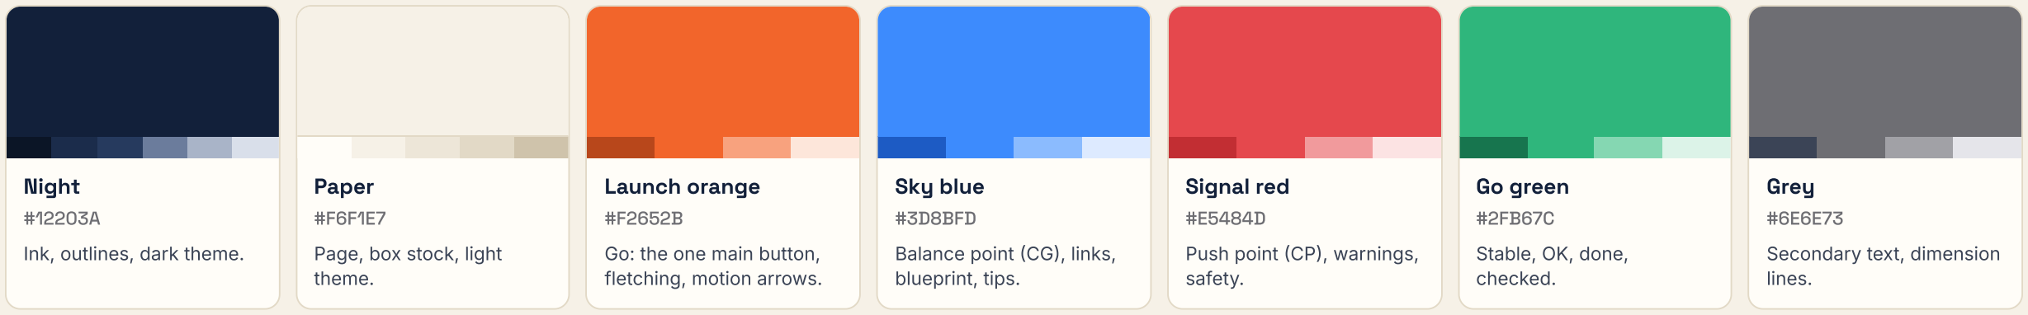
[picture p9: figure]
Night; Ink, outlines, dark theme.; Paper; Page, box stock, light theme.; Launch orange; Go: the one main button, fletching, motion arrows.; Sky blue; #3D8BFD; Balance point (CG), links, blueprint, tips.; Signal red; Push point (CP), warnings, safety.; Go green; Stable, OK, done, checked.; Grey; Secondary text, dimension lines.

03 TYPE
Fins are fletching.

SPACE GROTESK 700 · HEADINGS, LABELS, NUMBERS
39 / 3xl | Build it. Fly it.
25 / xl | Step 3 · Fin can
20 / lg | Where is the balance point?

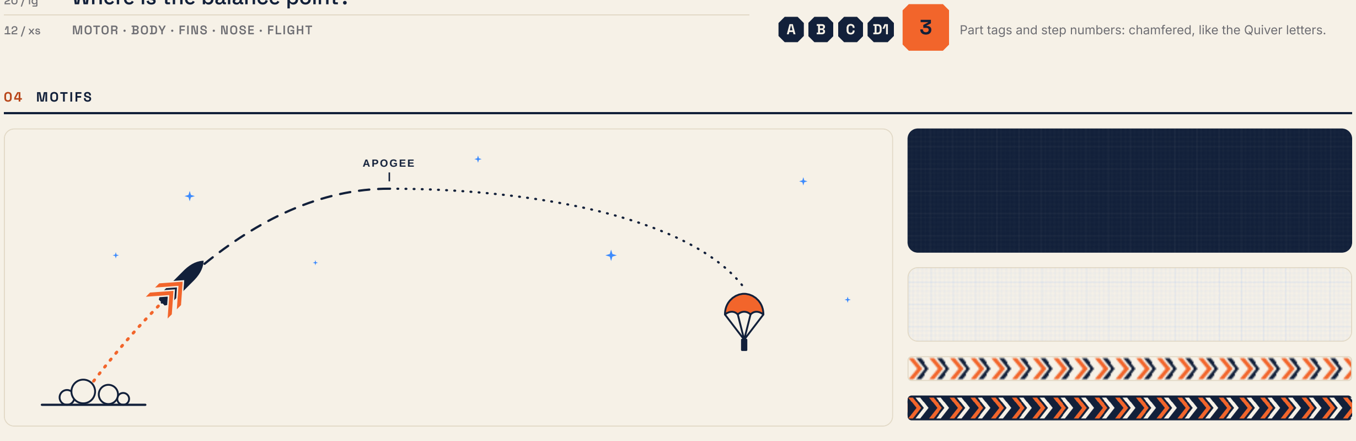
[picture p10: figure]
04 MOTIFS; APOGEE

12 / xs | MOTOR · BODY · FINS · NOSE · FLIGHT

INTER 400 / 600 · BODY TEXT
A rocket is stable when its balance point sits in front of its push point.

## The fins pull the push point back, the way feathers keep an arrow

straight.

14 px in the app, 11–12 pt in print. Short sentences. One idea per sentence.

TABULAR FIGURES · SPACE GROTESK

# C6-5 · 24 mm · 1.8 cal · 312 m

Part tags and step numbers: chamfered, like the Quiver letters.

05 IN THE APP (SAMPLE, LIGHT AND DARK)

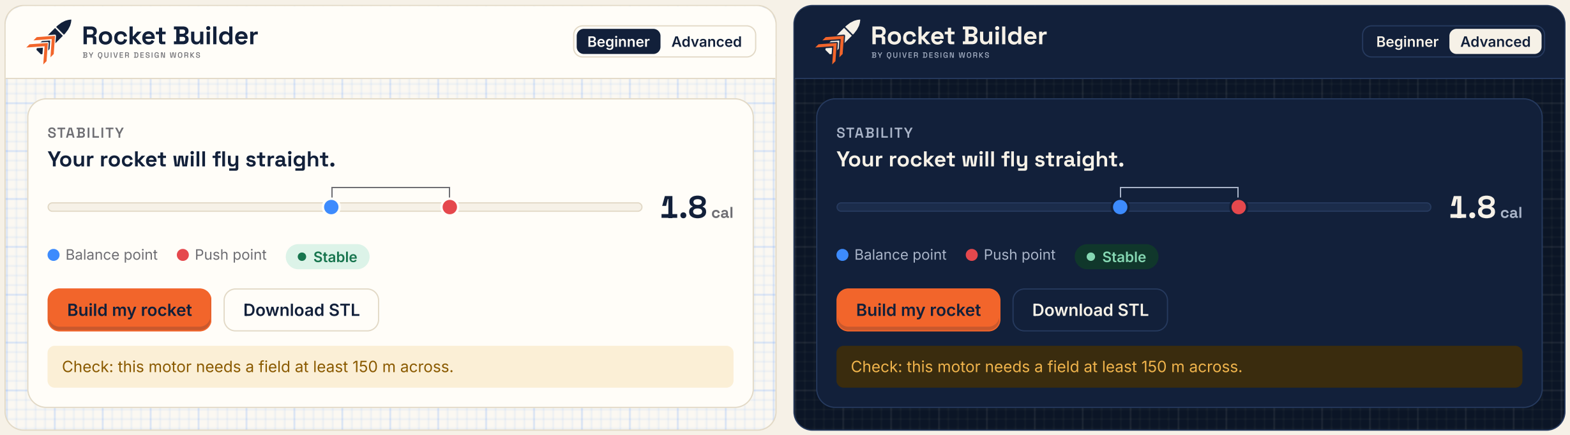
[picture p11: figure]
Beginner; Advanced; STABILITY Your rocket will fly straight.; 1.8cal; Balance point; Push point; Stable; Build my rocket; Download STL

Check: this motor needs a field at least 150 m across.

Check: this motor needs a field at least 150 m across.

06 GUIDE DRAWING STYLE

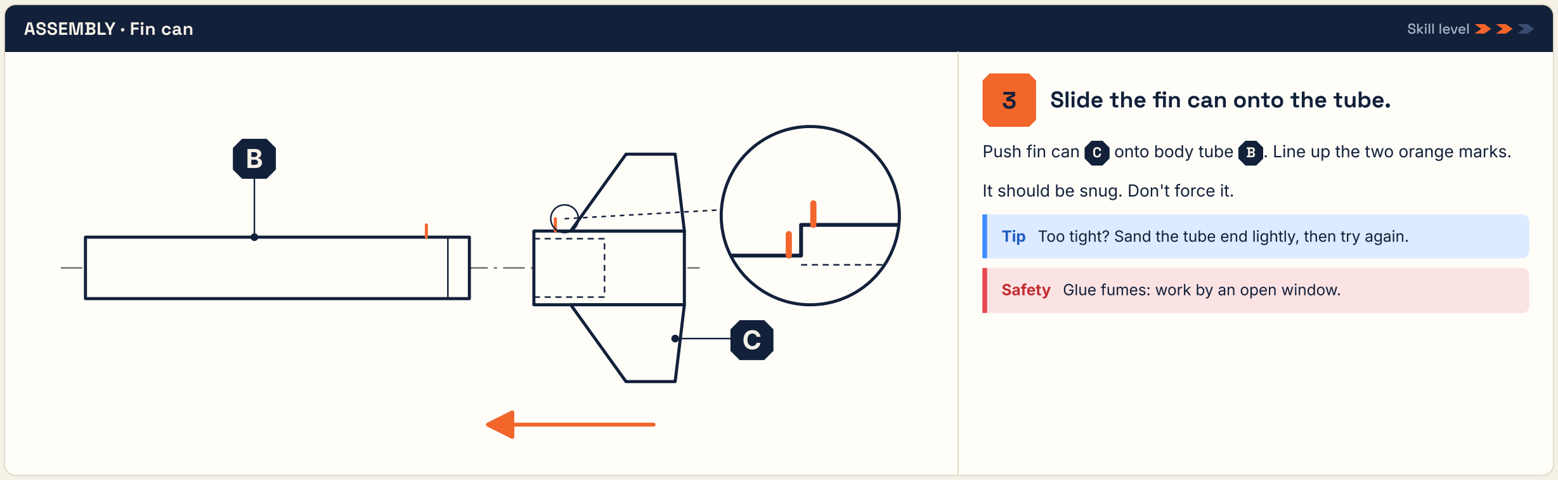
[picture p12: figure]
ASSEMBLY · Fin can; Skill level; Slide the fin can onto the tube.; It should be snug. Don't force it.

Push fin can | onto body tube | . Line up the two orange marks.

Tip Too tight? Sand the tube end lightly, then try again.

Safety Glue fumes: work by an open window.

07 VOICE

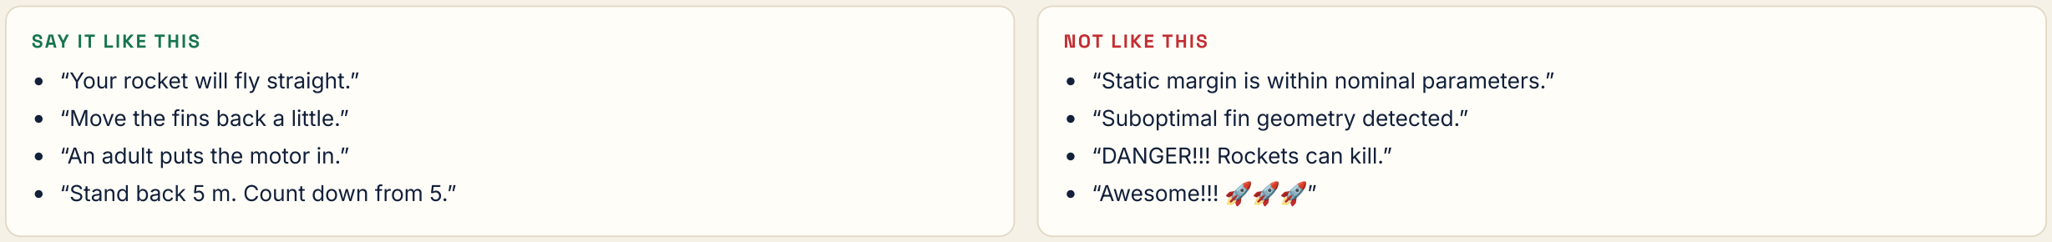
[picture p13: figure]
SAY IT LIKE THIS; “Your rocket will fly straight.”; “Move the fins back a little.”; “An adult puts the motor in.”; “Stand back 5 m. Count down from 5.”; NOT LIKE THIS; “Suboptimal fin geometry detected.”; “DANGER!!! Rockets can kill.”; “Awesome!!! 🚀🚀🚀”

“Static margin is within nominal parameters.”

Rocket Builder · by Quiver Design Works · rocket.quiverdesignworks.net | Tokens: docs/brand/tokens.css · Guide: docs/brand/brand.md
