the-feve/rocket-builder-web/docs/kits/packaging/header-card-dieline.pdf

Upper half: BACK, printed upside down. Lower half: FRONT. Fold on the dashed line.

## Rocket Builder Mini kit · fold-over header card 2-up)

Two cards per US Letter sheet, 6580 lb cover (ivory if you can). Cut, score and fold, punch the slot through both layers, staple over a 4 12 in bag. No bleed: the art stays 1/8 in inside the cut, so home printers and a hand trimmer are fine. Dashed grey marks: staple positions.

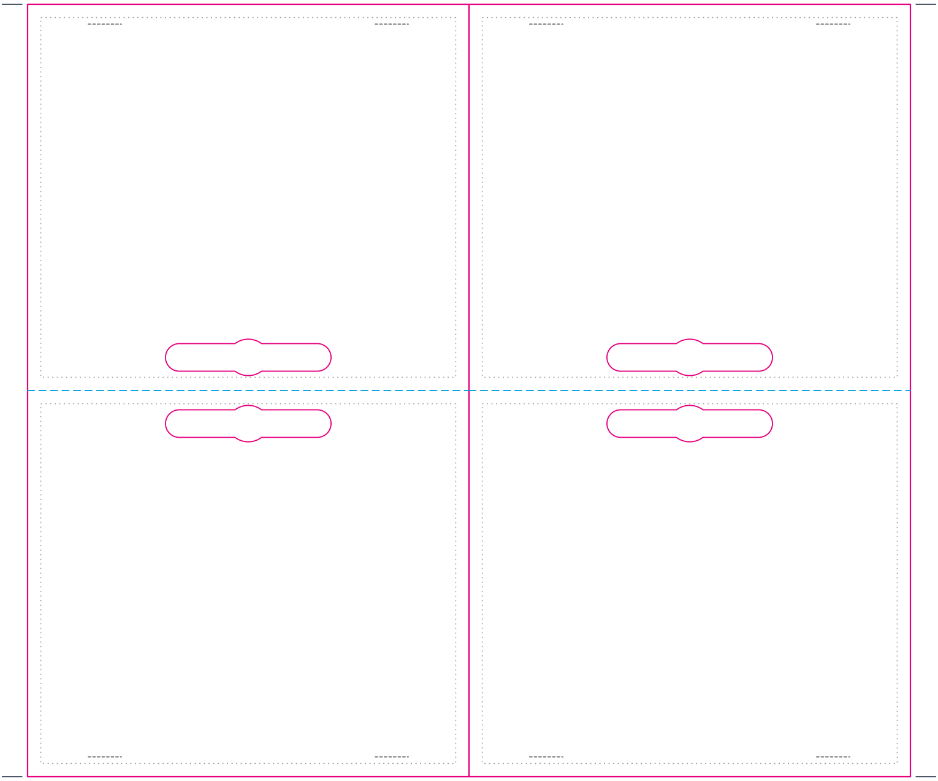
[picture p14: figure]

Cut | Fold | Bleed 1/8 in | Safe area
