the-feve/rocket-builder-web/docs/kits/packaging/header-card-back.png

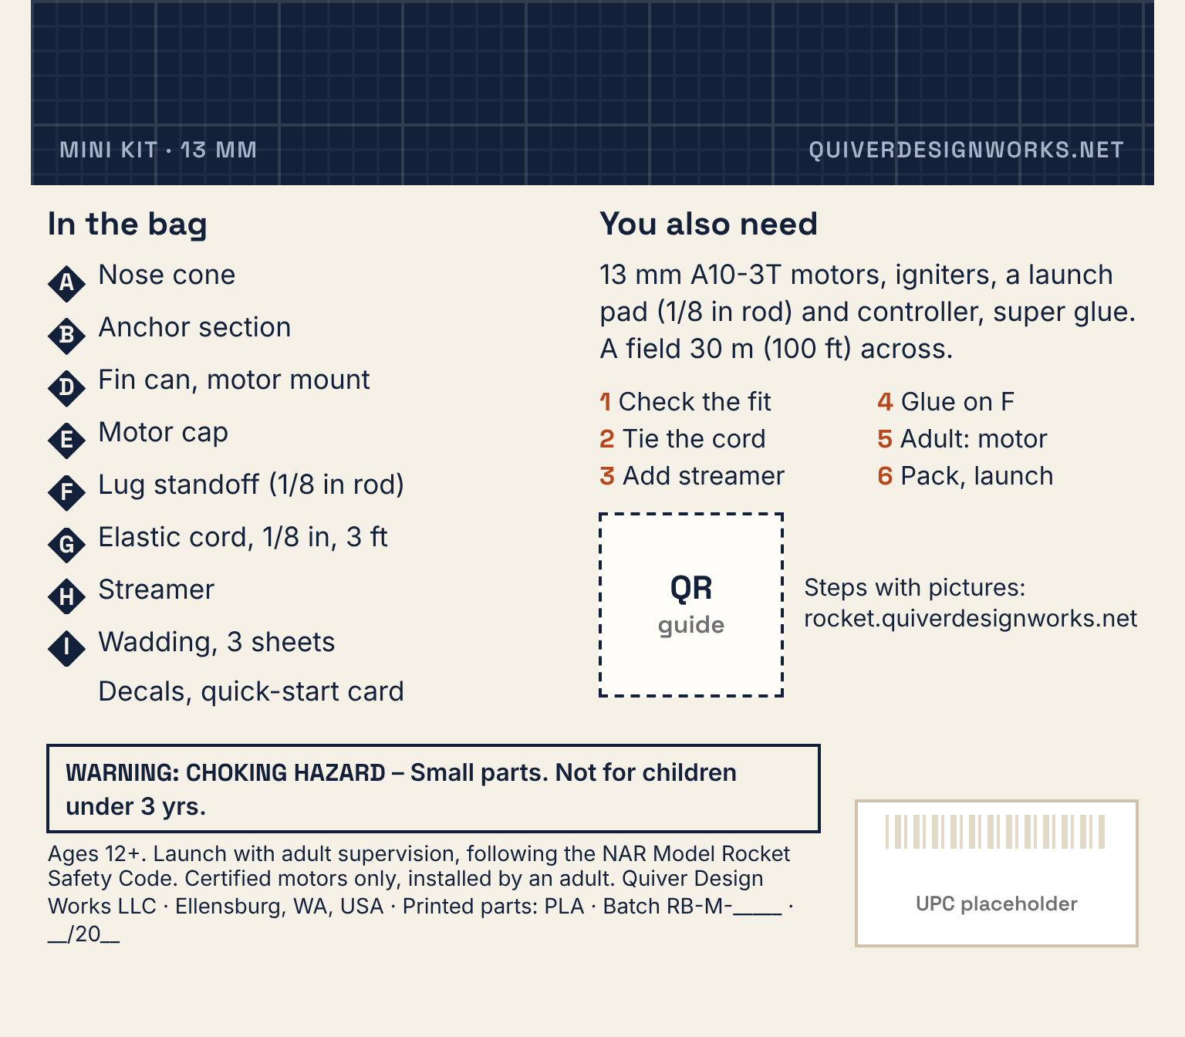
docs/kits/packaging/header-card-back.png
