the-feve/rocket-builder-web/docs/kits/packaging/header-card-sheet.png

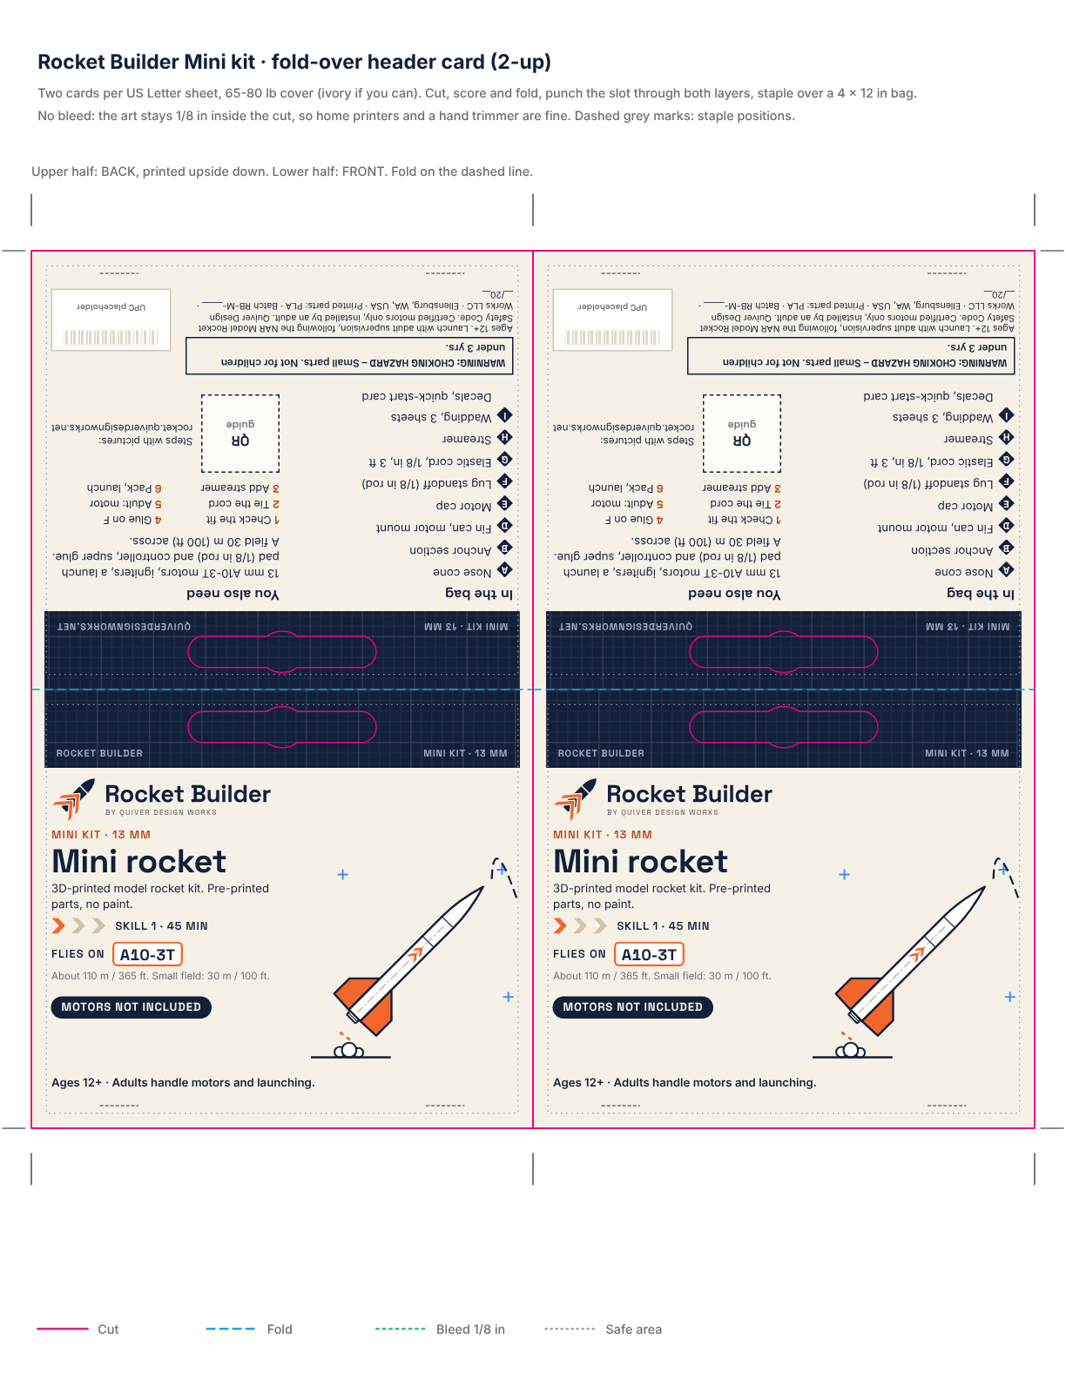
docs/kits/packaging/header-card-sheet.png
