the-feve/rocket-builder-web/docs/kits/packaging/tube-wrap-big-dieline.png

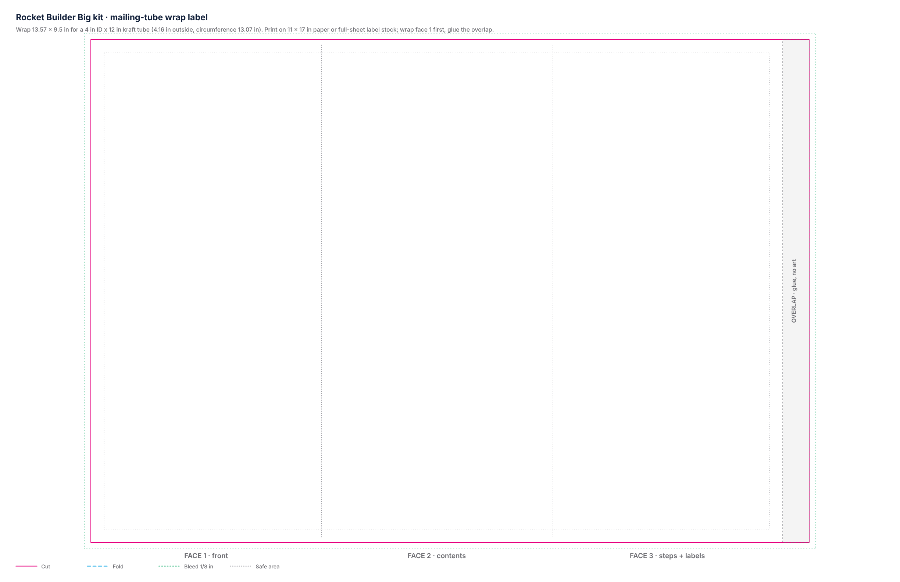
docs/kits/packaging/tube-wrap-big-dieline.png
