the-feve/rocket-builder-web/docs/kits/packaging/tube-wrap-big-front.png

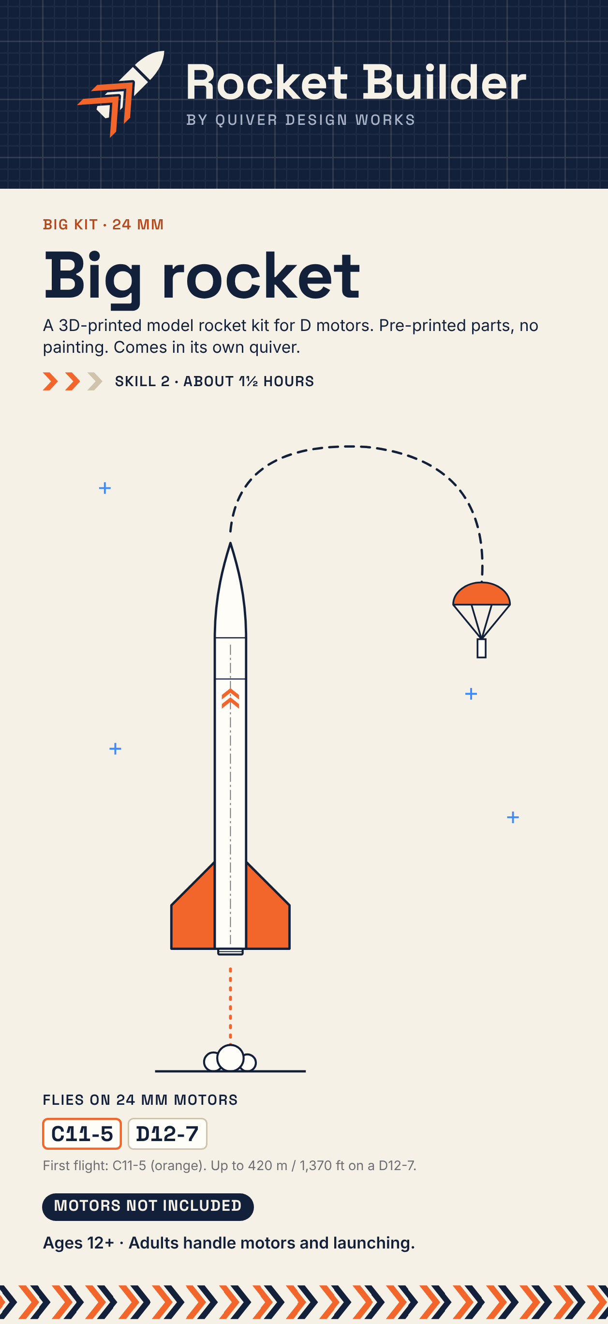
docs/kits/packaging/tube-wrap-big-front.png
