the-feve/rocket-builder-web/docs/kits/packaging/tuck-box-starter-back.png

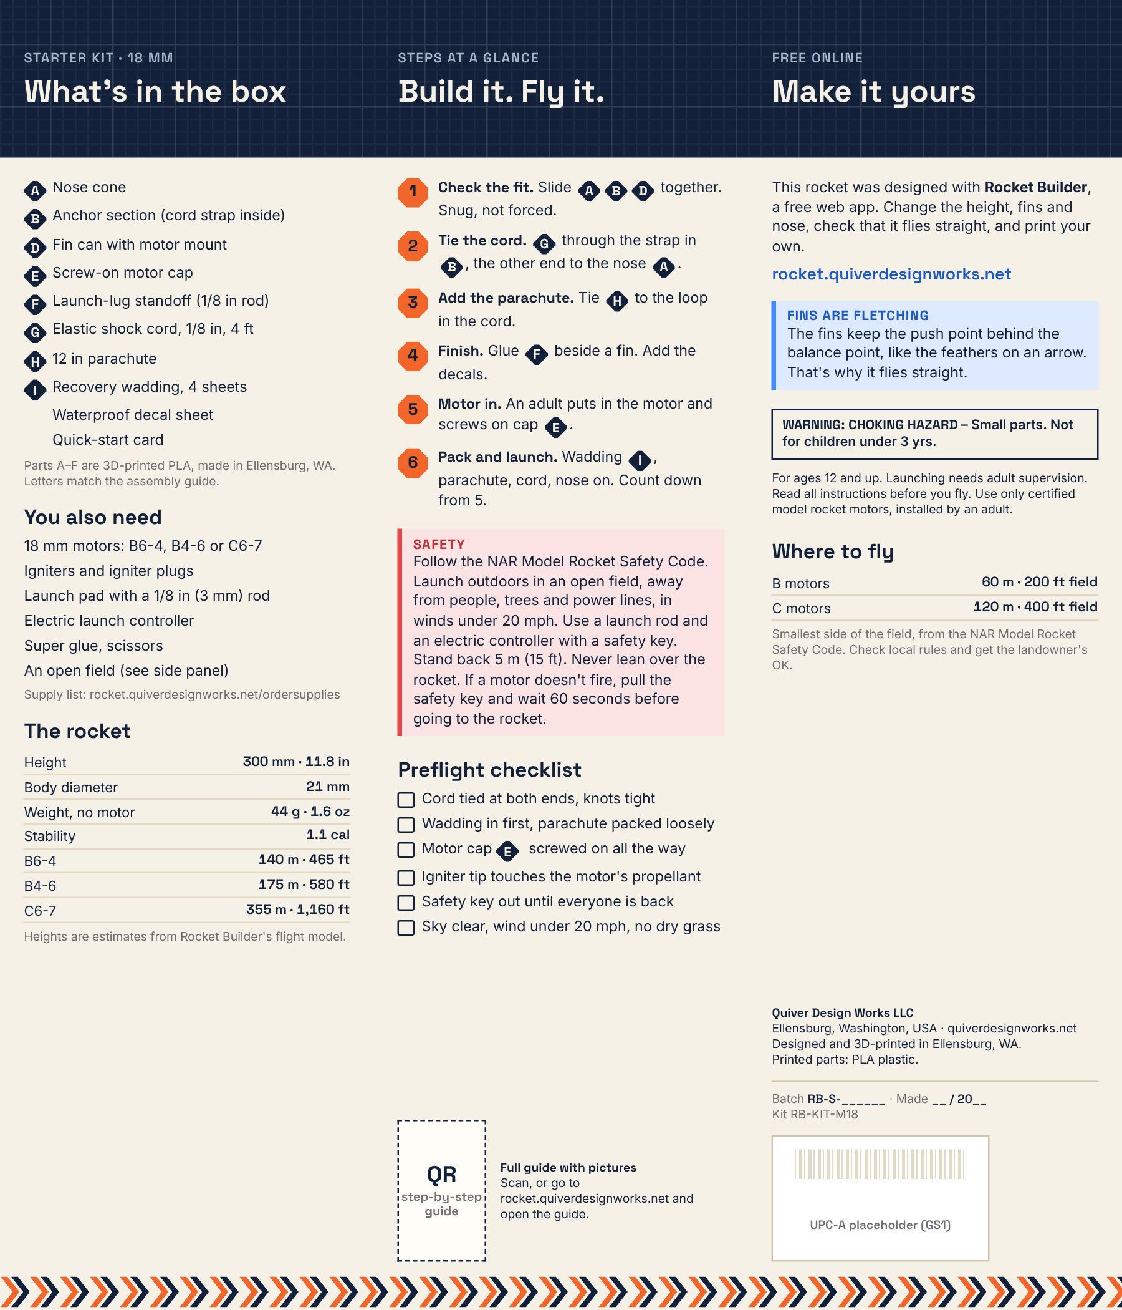
docs/kits/packaging/tuck-box-starter-back.png
