the-feve/rocket-builder-web/geometry/report/anchor.png

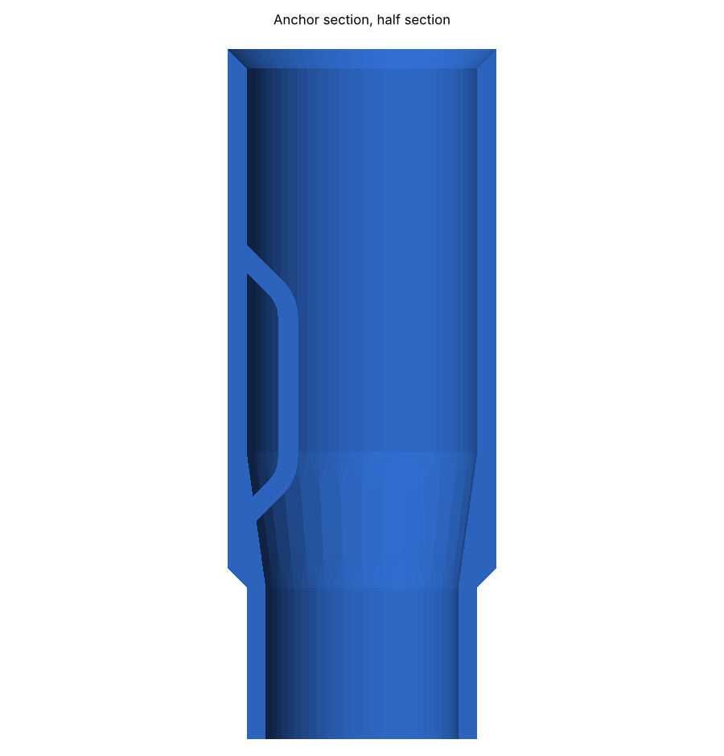
geometry/report/anchor.png
