the-feve/rocket-builder-web/geometry/report/lug_aft.png

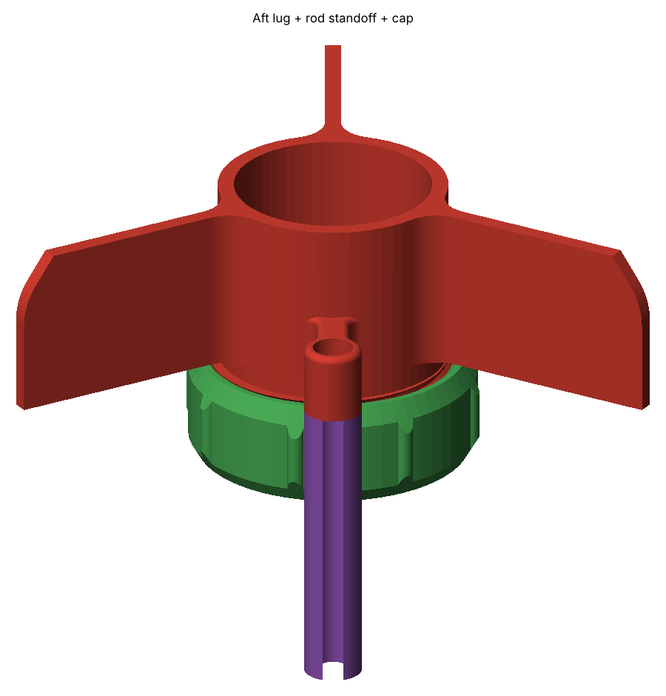
geometry/report/lug_aft.png
