the-feve/rocket-builder-web/geometry/report/lug_fwd.png

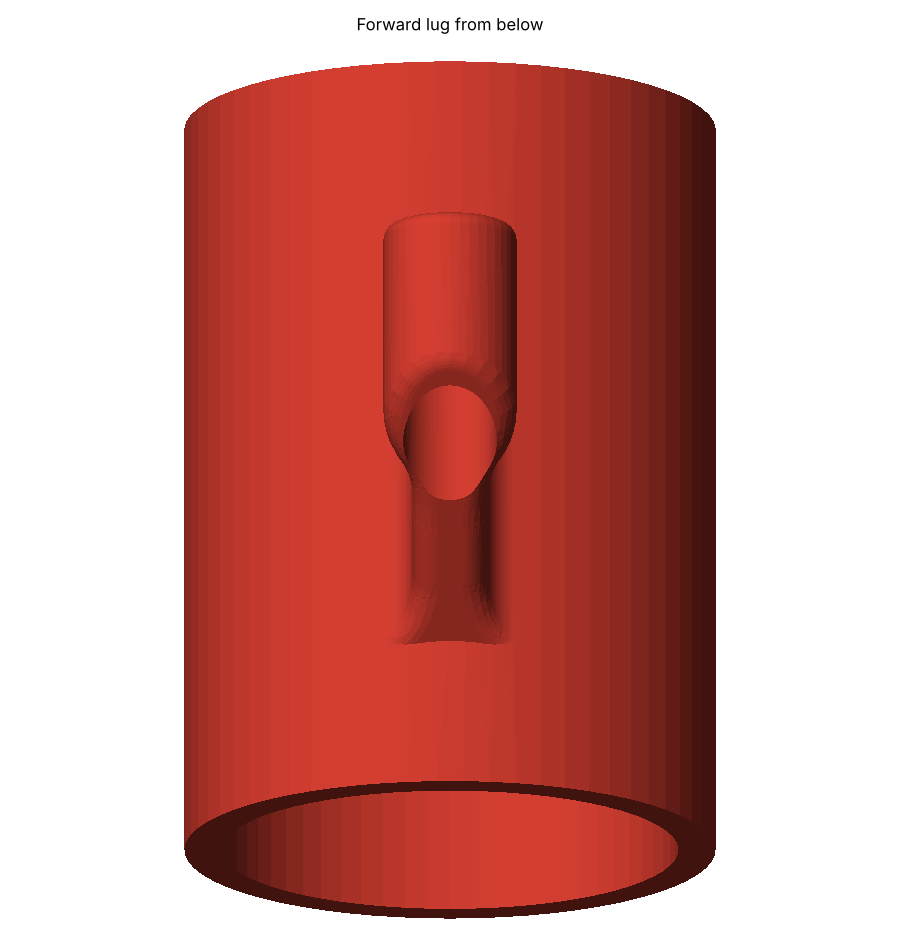
geometry/report/lug_fwd.png
