the-feve/rocket-builder-web/geometry/report/m18_clipped_delta/aft_closeup.png

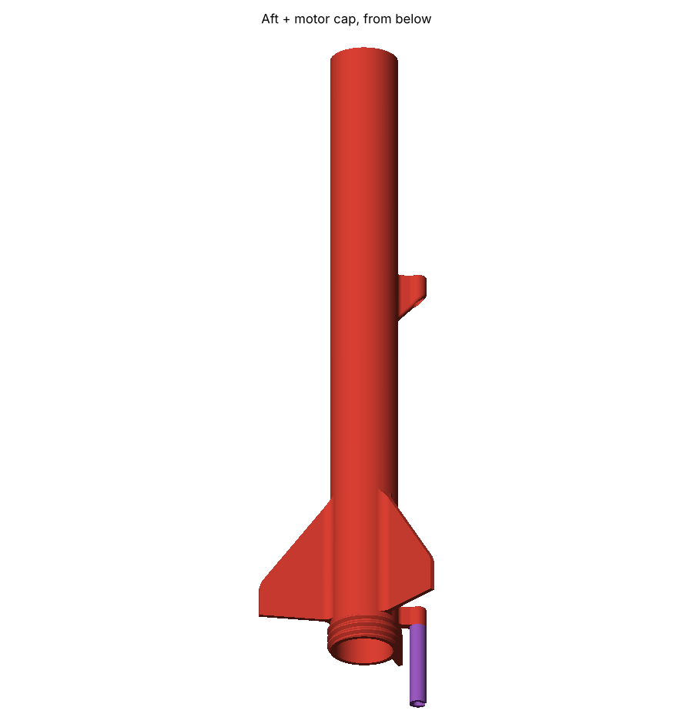
geometry/report/m18_clipped_delta/aft_closeup.png
