the-feve/rocket-builder-web/geometry/report/m18_swept/aft_section.png

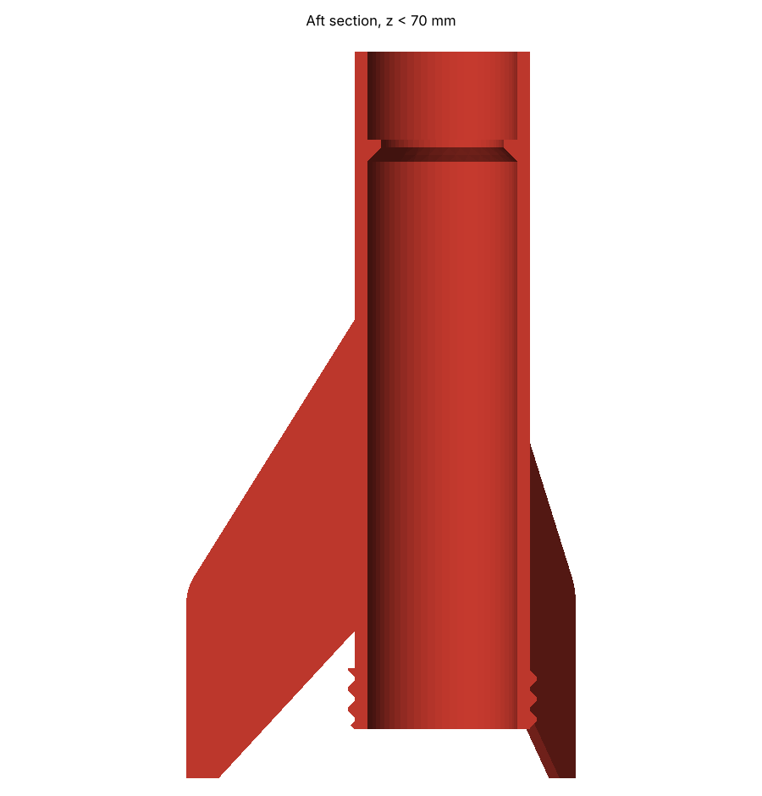
geometry/report/m18_swept/aft_section.png
