the-feve/rocket-builder-web/geometry/report/m18_swept/section.png

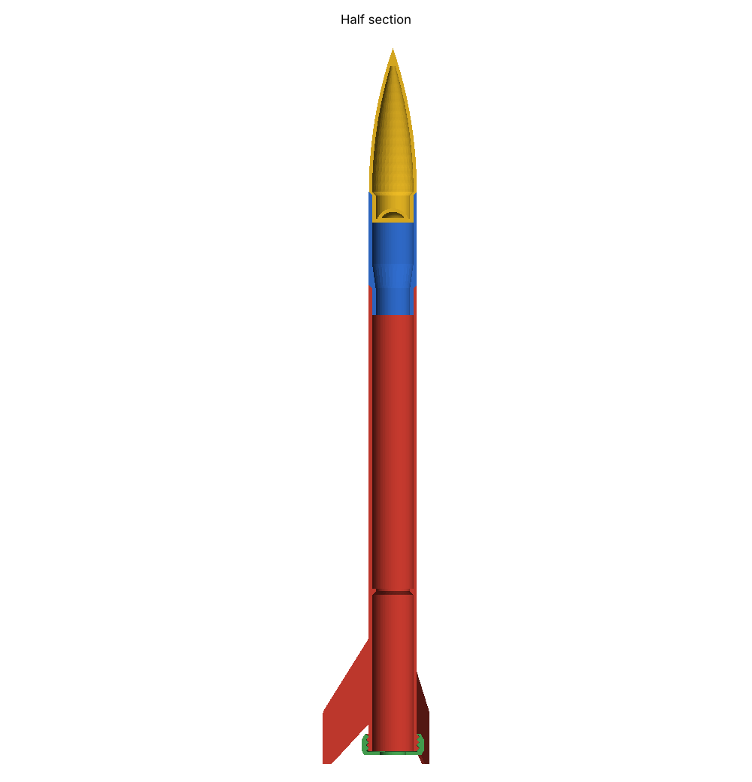
geometry/report/m18_swept/section.png
