the-feve/rocket-builder-web/geometry/report/m18_trapezoid_od33.7/aft_closeup.png

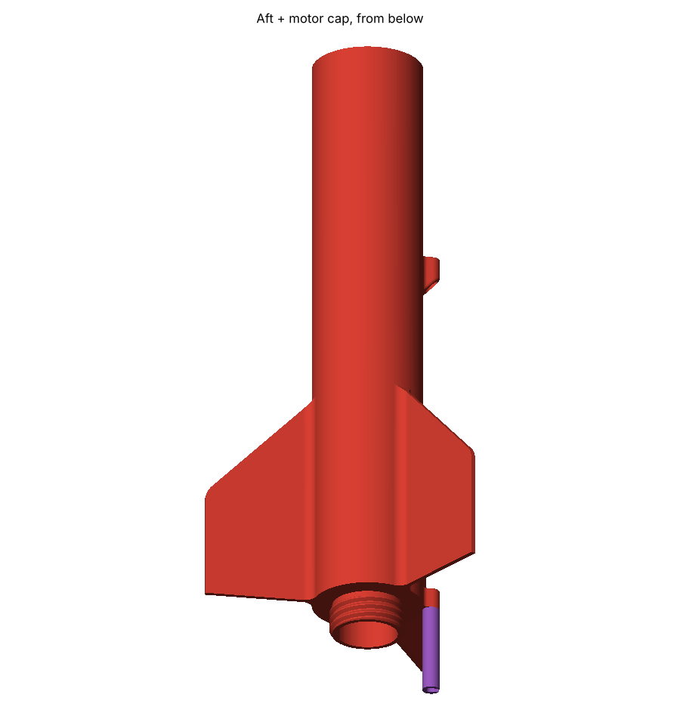
geometry/report/m18_trapezoid_od33.7/aft_closeup.png
