the-feve/rocket-builder-web/geometry/report/m18_trapezoid_od33.7/aft_section.png

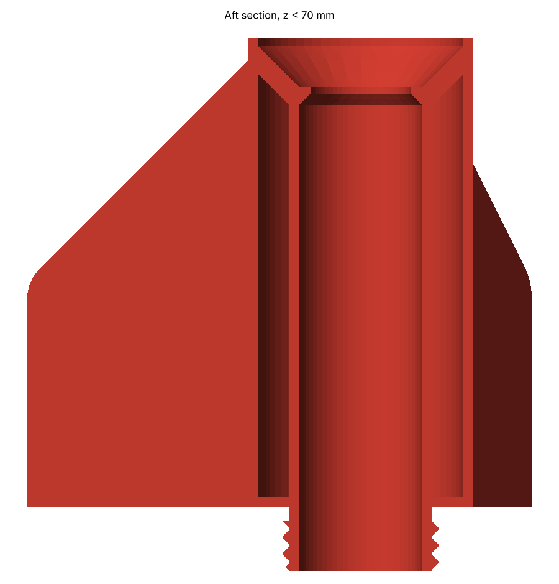
geometry/report/m18_trapezoid_od33.7/aft_section.png
