the-feve/rocket-builder-web/server/screenshots/designer_dark.png

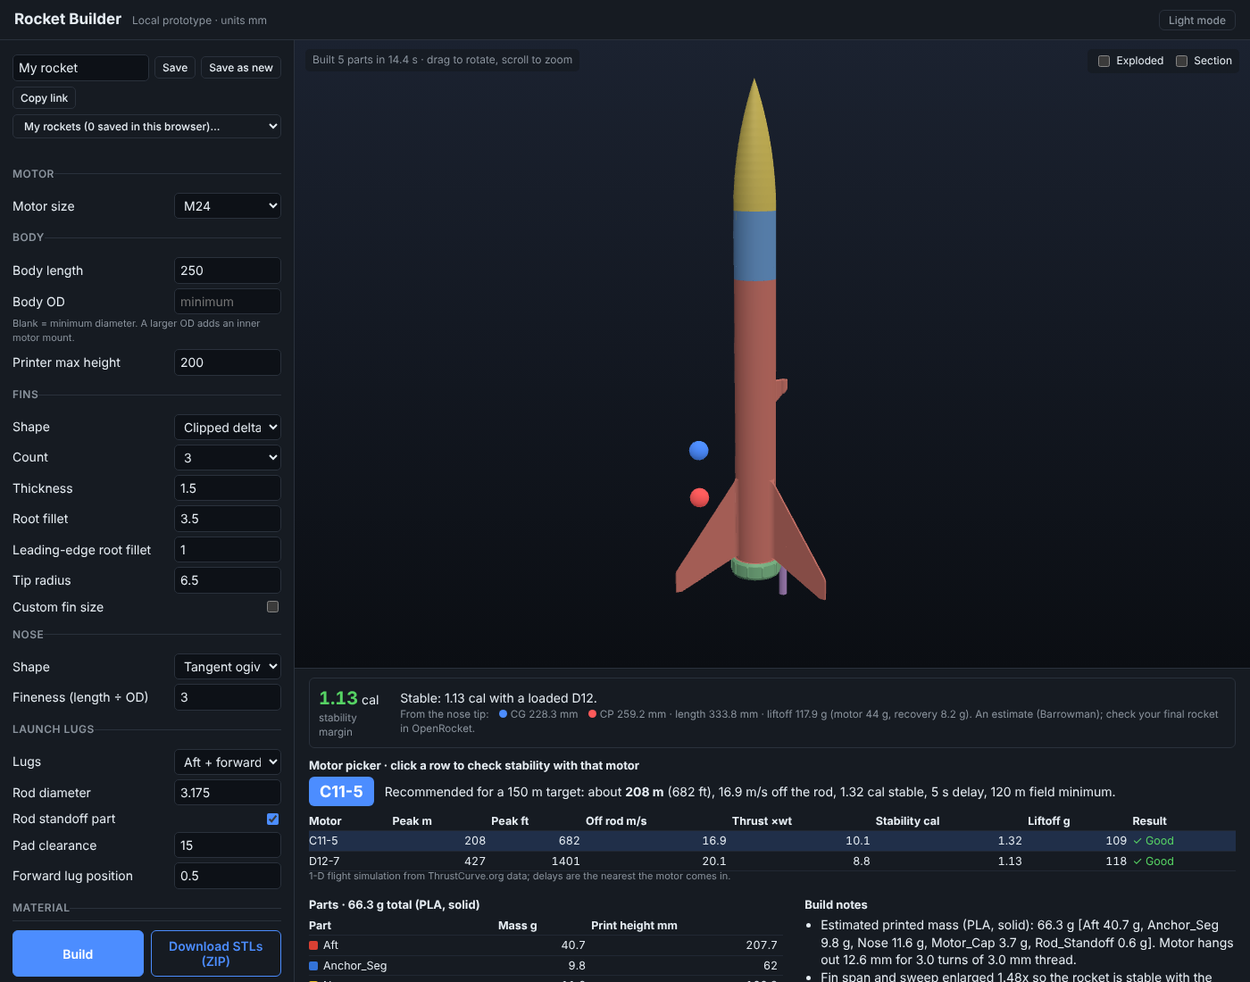
server/screenshots/designer_dark.png
