the-feve/rocket-builder-web/server/screenshots/designer_light.png

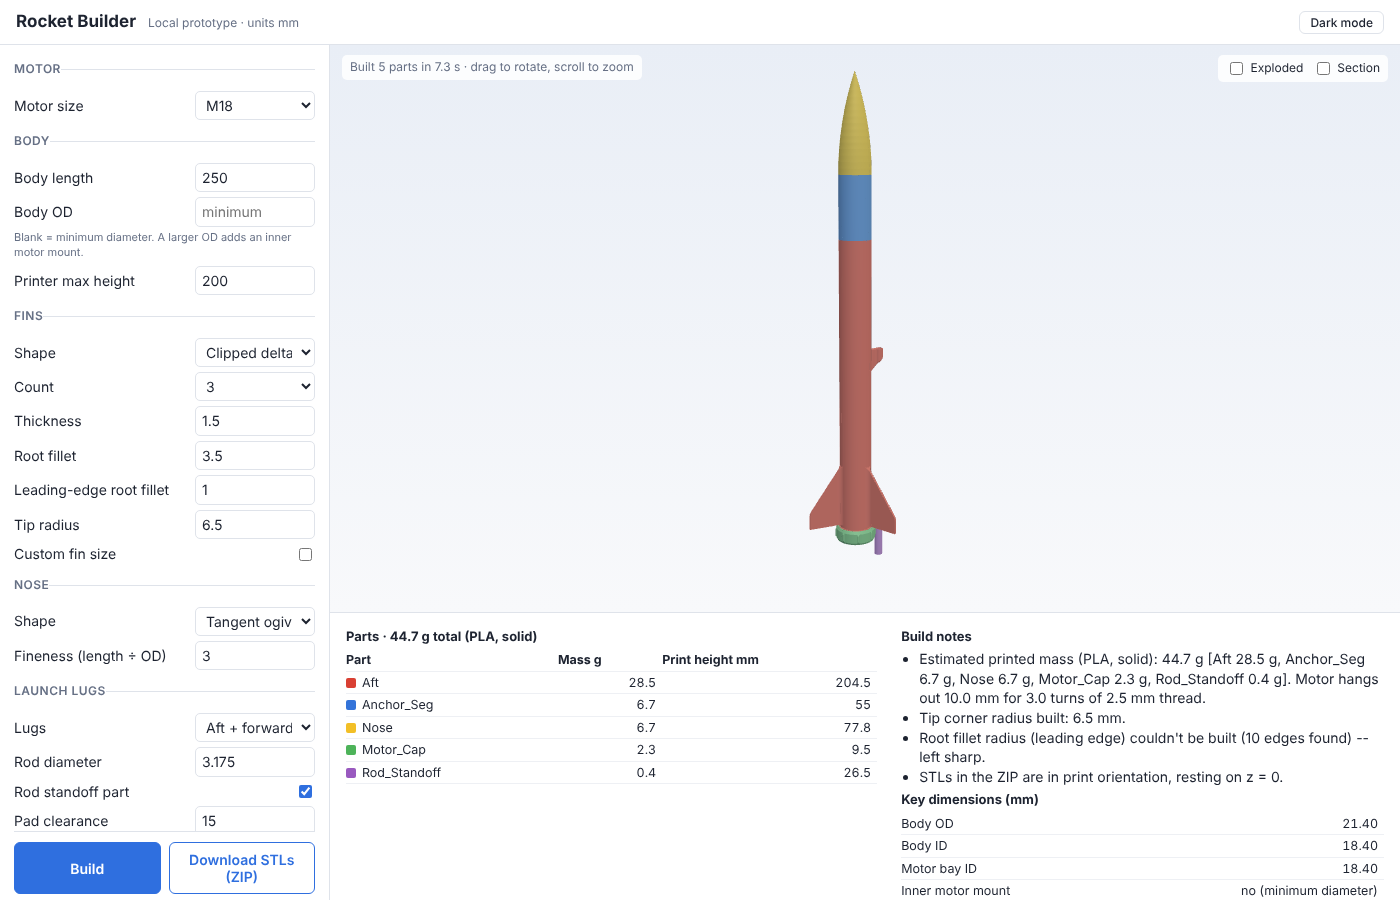
server/screenshots/designer_light.png
