the-feve/rocket-builder-web/geometry/examples/m18_clipped_delta/assembled.stl

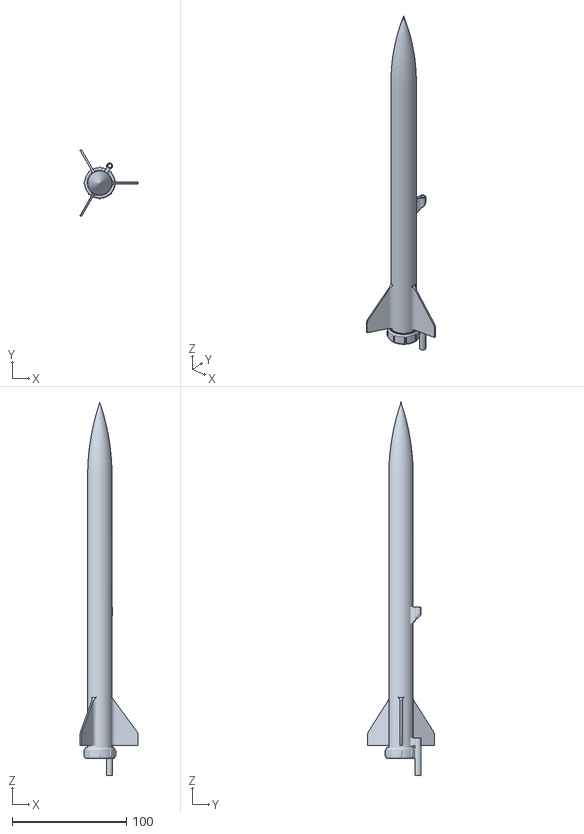
[picture p31: CAD file, 2026-10-08]
geometry/examples/m18_clipped_delta/assembled.stl
50.9 x 58.8 x 327.1
