the-feve/rocket-builder-web/docs/kits/test-prints/big-m24/E_motor_cap.stl

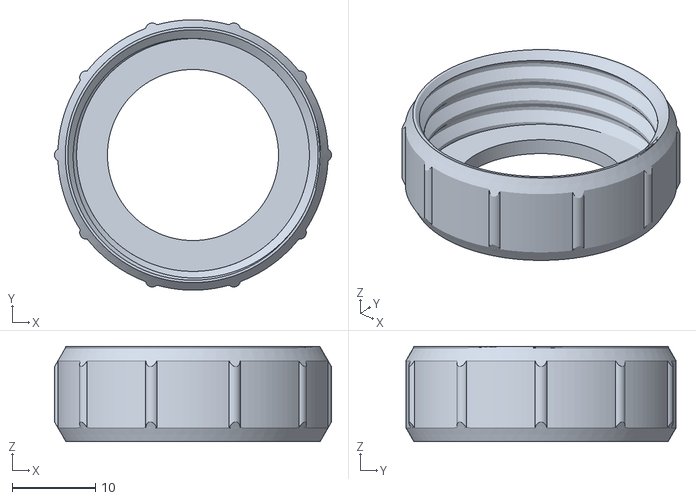
[picture p32: CAD file, 2026-10-19]
docs/kits/test-prints/big-m24/E_motor_cap.stl
33.2 x 32.4 x 11.4
