the-feve/rocket-builder-web/docs/kits/test-prints/mini-m13/E_motor_cap.stl

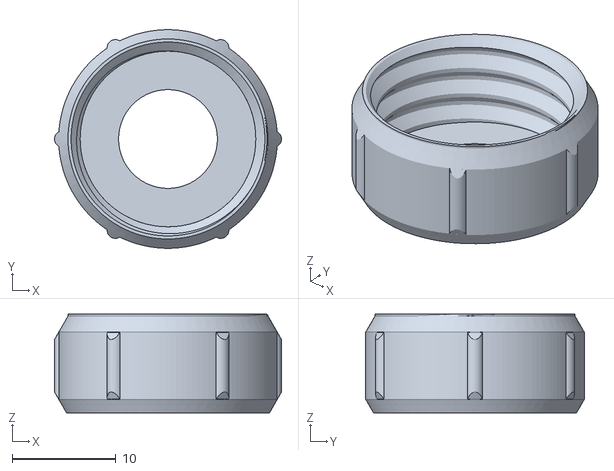
[picture p33: CAD file, 2026-10-19]
docs/kits/test-prints/mini-m13/E_motor_cap.stl
21.8 x 21.0 x 9.50
