the-feve/rocket-builder-web/docs/kits/test-prints/starter-m18/E_motor_cap.stl

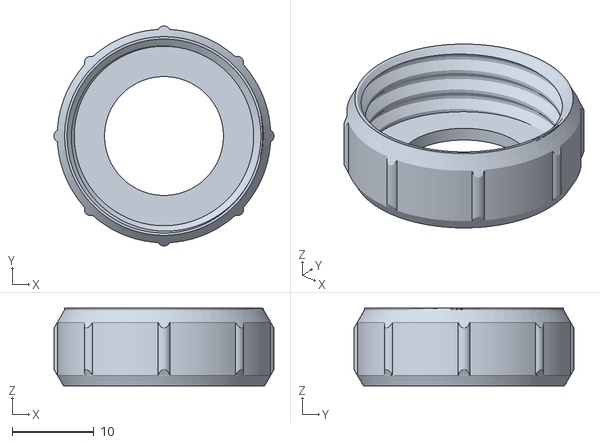
[picture p34: CAD file, 2026-10-19]
docs/kits/test-prints/starter-m18/E_motor_cap.stl
26.8 x 26.8 x 9.50
