the-feve/rocket-builder-web/geometry/examples/m18_clipped_delta/Aft.stl

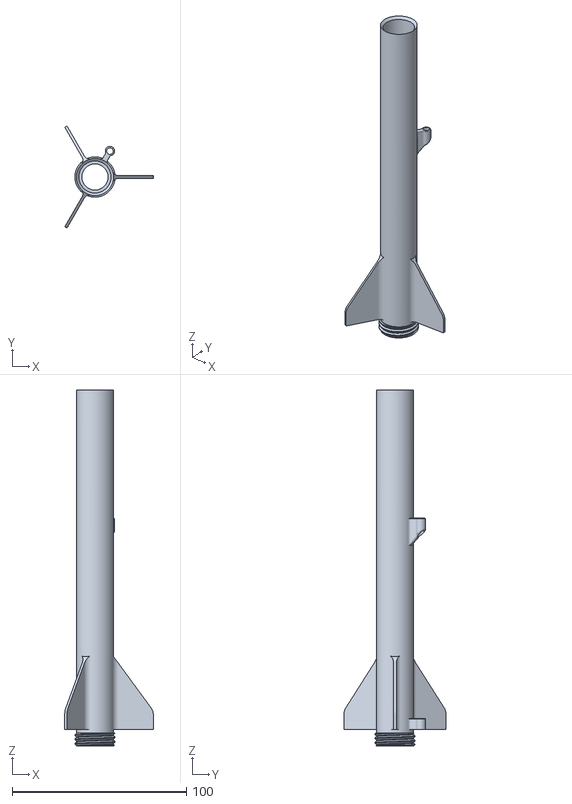
[picture p35: CAD file, 2026-10-08]
geometry/examples/m18_clipped_delta/Aft.stl
50.9 x 58.8 x 204.5
