the-feve/rocket-builder-web/docs/kits/test-prints/big-m24/D_fin_can.stl

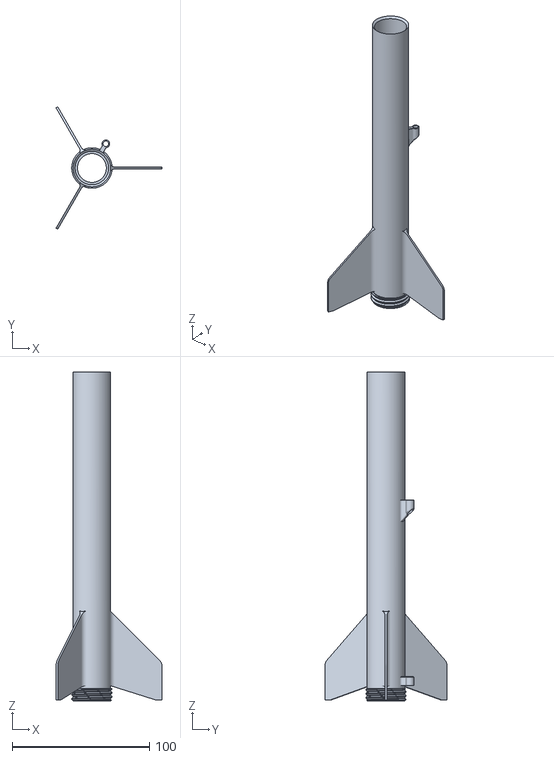
[picture p36: CAD file, 2026-10-19]
docs/kits/test-prints/big-m24/D_fin_can.stl
77.3 x 89.3 x 239.9
