the-feve/rocket-builder-web/docs/kits/test-prints/mini-m13/F_rod_standoff.stl

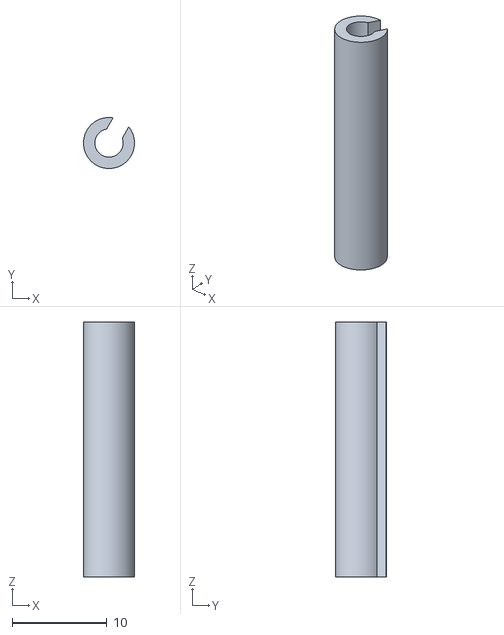
[picture p37: CAD file, 2026-10-19]
docs/kits/test-prints/mini-m13/F_rod_standoff.stl
5.37 x 5.37 x 26.9
