the-feve/rocket-builder-web/docs/kits/test-prints/starter-m18/D_fin_can.stl

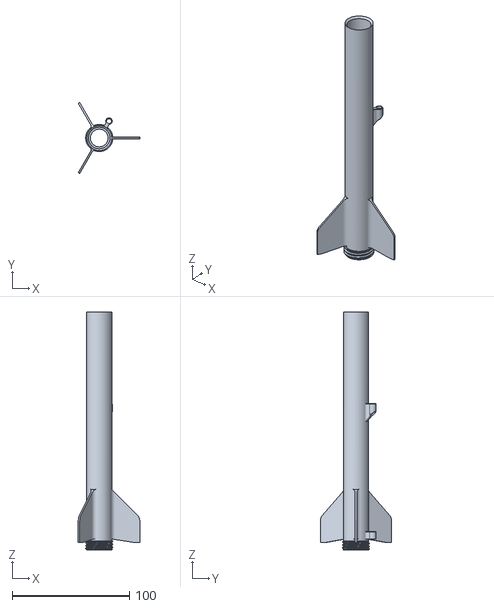
[picture p38: CAD file, 2026-10-19]
docs/kits/test-prints/starter-m18/D_fin_can.stl
52.5 x 60.6 x 202.9
