the-feve/rocket-builder-web/geometry/examples/m18_clipped_delta/Rod_Standoff.stl

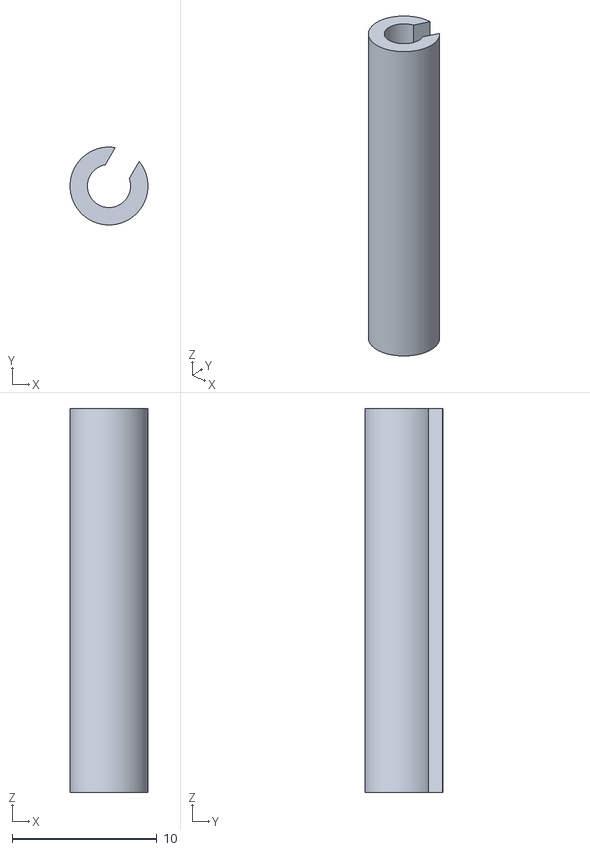
[picture p39: CAD file, 2026-10-08]
geometry/examples/m18_clipped_delta/Rod_Standoff.stl
5.37 x 5.37 x 26.5
