the-feve/rocket-builder-web/docs/kits/test-prints/big-m24/A_nose.stl

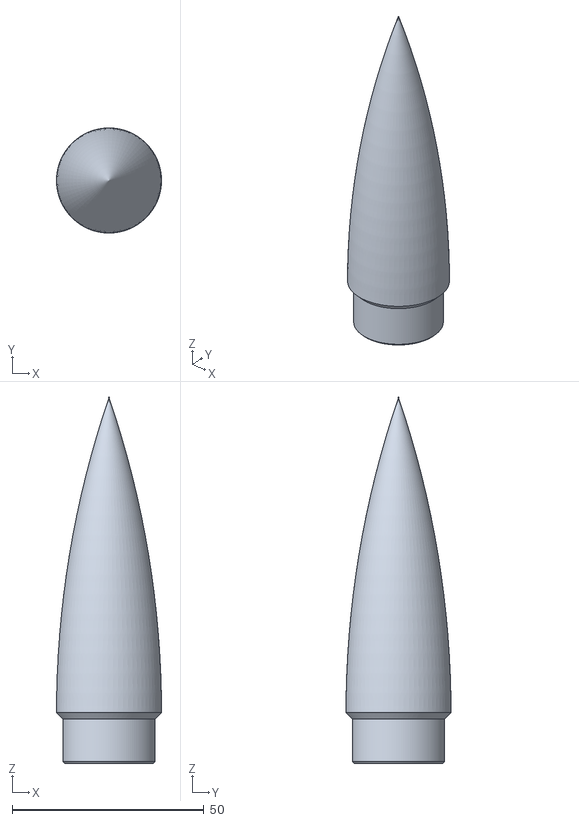
[picture p40: CAD file, 2026-10-19]
docs/kits/test-prints/big-m24/A_nose.stl
27.4 x 27.4 x 95.4
