the-feve/rocket-builder-web/docs/kits/test-prints/mini-m13/D_fin_can.stl

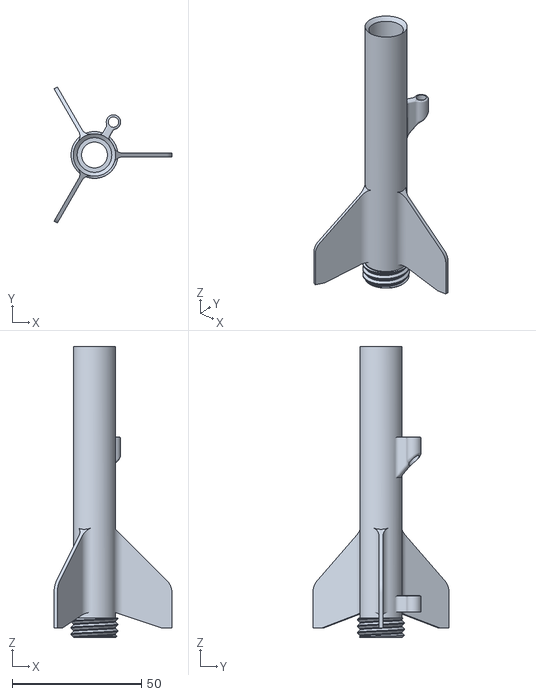
[picture p41: CAD file, 2026-10-18]
docs/kits/test-prints/mini-m13/D_fin_can.stl
45.7 x 52.7 x 112.7
