the-feve/rocket-builder-web/docs/kits/test-prints/starter-m18/B_anchor_section.stl

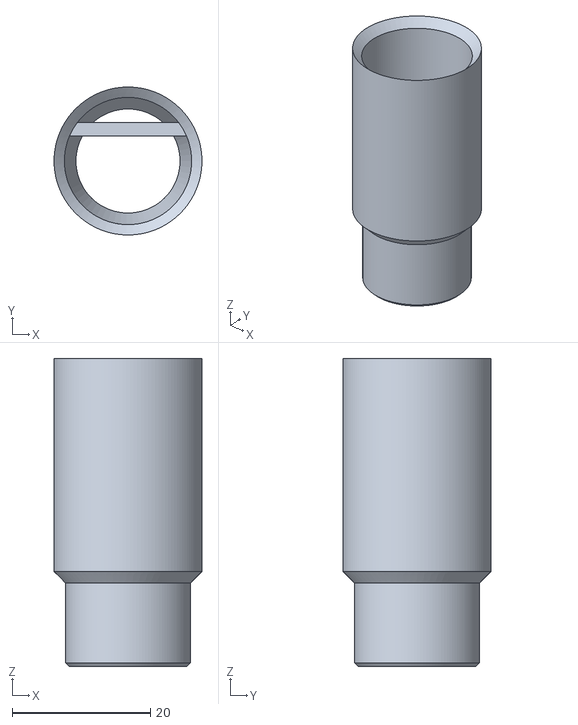
[picture p42: CAD file, 2026-10-19]
docs/kits/test-prints/starter-m18/B_anchor_section.stl
21.4 x 21.4 x 44.6
