the-feve/rocket-builder-web/docs/kits/test-prints/big-m24/F_rod_standoff.stl

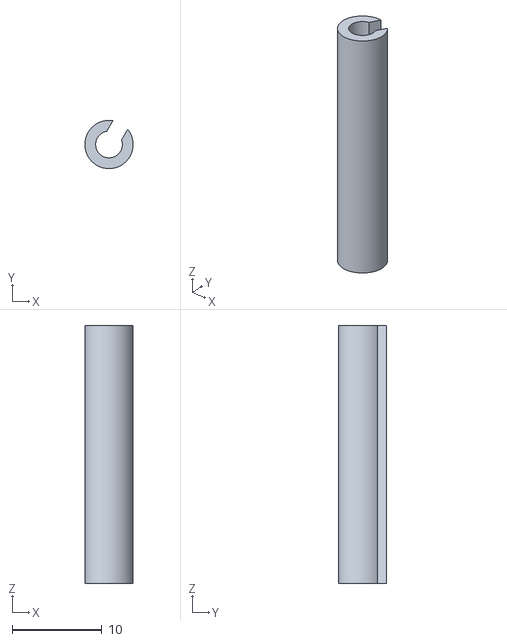
[picture p43: CAD file, 2026-10-18]
docs/kits/test-prints/big-m24/F_rod_standoff.stl
5.37 x 5.37 x 28.8
