the-feve/rocket-builder-web/docs/kits/test-prints/starter-m18/A_nose.stl

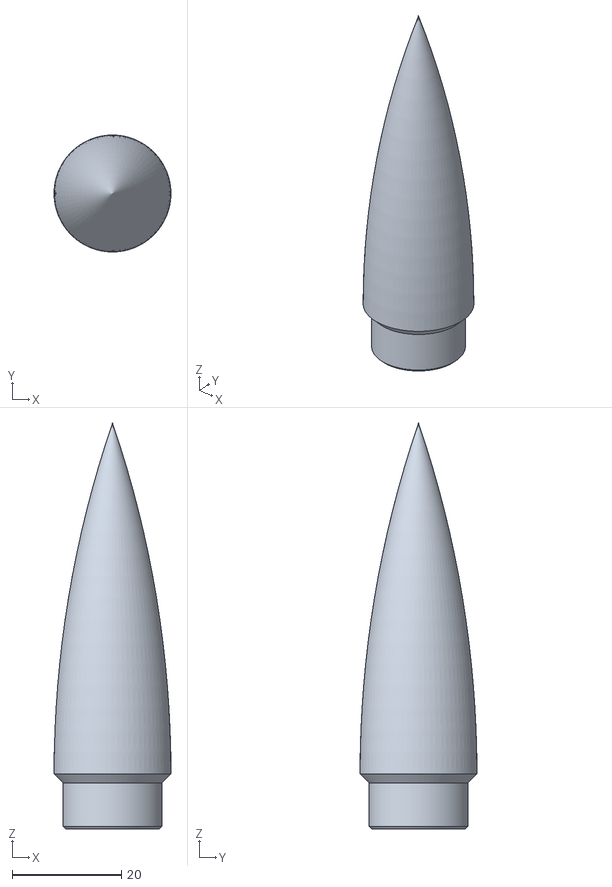
[picture p44: CAD file, 2026-10-19]
docs/kits/test-prints/starter-m18/A_nose.stl
21.4 x 21.4 x 74.3
