the-feve/rocket-builder-web/geometry/examples/m18_clipped_delta/Nose.stl

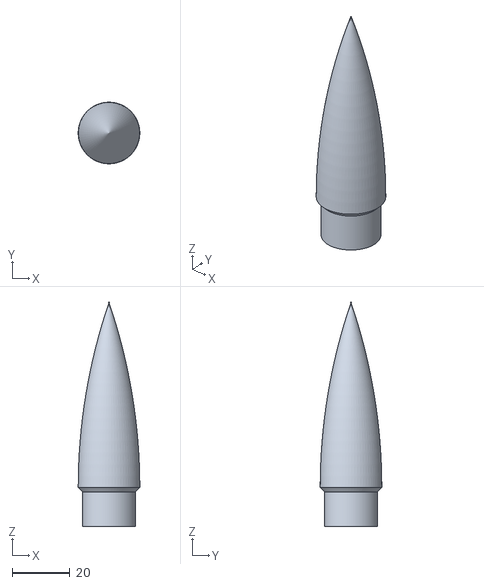
[picture p45: CAD file, 2026-10-08]
geometry/examples/m18_clipped_delta/Nose.stl
21.4 x 21.4 x 77.8
