the-feve/rocket-builder-web/docs/kits/test-prints/big-m24/B_anchor_section.stl

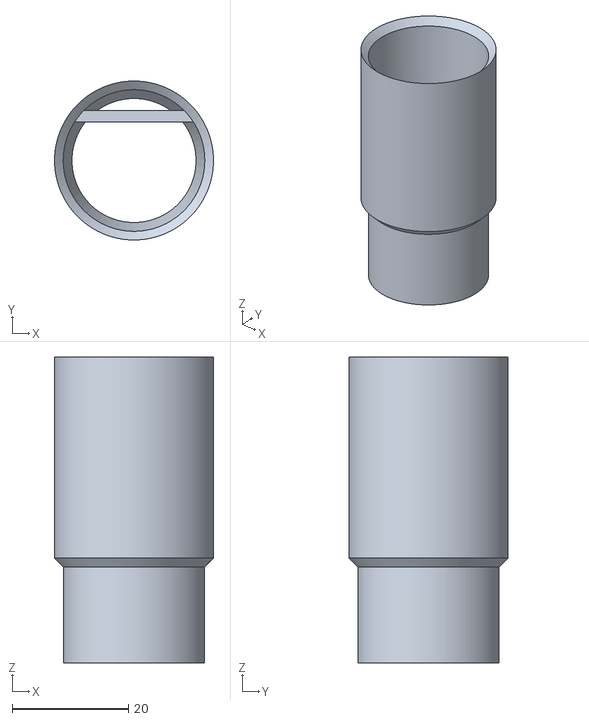
[picture p46: CAD file, 2026-10-18]
docs/kits/test-prints/big-m24/B_anchor_section.stl
27.4 x 27.4 x 52.7
