the-feve/rocket-builder-web/geometry/examples/m18_clipped_delta/Anchor_Seg.stl

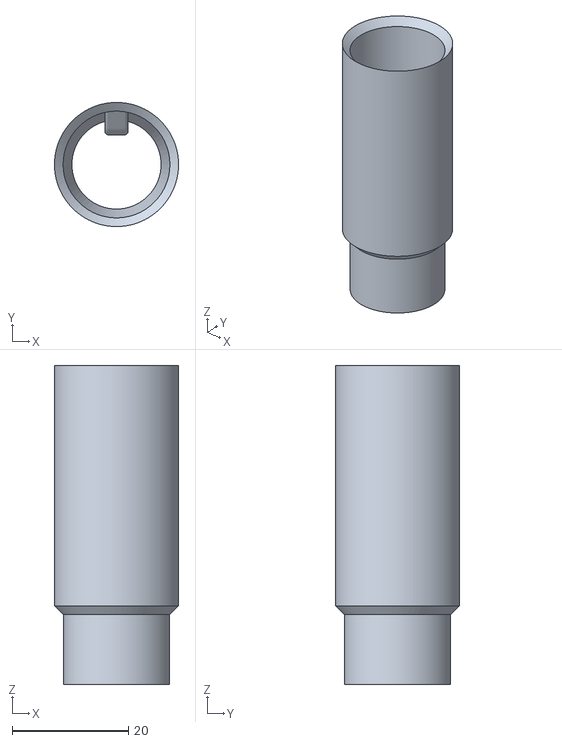
[picture p47: CAD file, 2026-10-08]
geometry/examples/m18_clipped_delta/Anchor_Seg.stl
21.4 x 21.4 x 55.0
