the-feve/rocket-builder-web/geometry/examples/m18_clipped_delta/Motor_Cap.stl

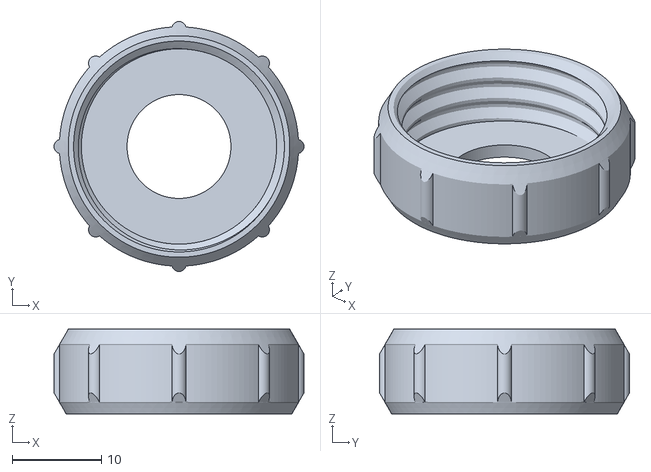
[picture p48: CAD file, 2026-10-08]
geometry/examples/m18_clipped_delta/Motor_Cap.stl
28.0 x 28.0 x 9.50
