the-feve/rocket-builder-web/(list of files, cad)

Other CAD files:
docs/kits/test-prints/starter-m18/F_rod_standoff.stl
