the-feve/rocket-builder-web/docs/kits/test-prints/mini-m13/README.md

# Mini kit (M13, 13 mm motors): test prints

> **2026-10-19:** reprint everything. Joints from the fit tests (body 0.16 mm, nose 0.14 mm per side, 0.5 mm chamfer on each shoulder's bed edge; they were the CAD 0.02 mm and wouldn't go in). Motor cap: 1.75 mm retention lip (nozzle hole = motor diameter - 3.5 mm) and the slimmer cap (1.2 mm wall, 0.4 mm ribs). Launch lugs 4.0 mm bore.

Generated by `tools/make_test_prints.py` through the app's own build path (Rocket Builder 0.2.0); the STLs are the ones in `mini-m13-rocket.zip`, which is what the app's Download gives. Open `design.json` with **Open file** in the app to see or change this design.

## Design

| Setting | Value |
|---|---|
| Mode | Beginner |
| Motor size | M13 |
| Overall height (asked / built) | 190 mm / 190.1 mm |
| Printer max height | 256 mm |
| Fins | 3 x trapezoid, auto-sized (span/sweep scale 1.346) |
| Nose | tangent ogive, fineness 3.0 |
| Body | OD 16.4 mm, wall 1.5 mm, length 141.0 mm |
| Launch lugs | two (aft + forward), 1/8 in rod, 4.0 mm bore; rod standoff on |
| Filament | PLA |

## Parts

Heights and masses are the generator's (solid plastic; a real print with infill is lighter, so weigh it). Every part must fit under the printer's 256 mm (the generator keeps 5 mm spare).

| Letter | File | Part | Print height | Solid mass |
|---|---|---|---|---|
| **A** | `A_nose.stl` | Nose cone. Its tie bar inside the shoulder takes the shock cord's top end. | 57.8 mm | 3.6 g |
| **B** | `B_anchor_section.stl` | Anchor section: the body tube's top piece, with the strap the shock cord ties to. | 39.1 mm | 3.7 g |
| **D** | `D_fin_can.stl` | Fin can: fins, motor bay, launch lugs and the threaded tail. | 111.5 mm | 13.7 g |
| **E** | `E_motor_cap.stl` | Motor cap: screws onto the tail and holds the motor in. | 9.5 mm | 1.4 g |
| **F** | `F_rod_standoff.stl` | Rod standoff: clips onto the launch rod under the aft lug, so the motor cap clears the blast deflector. | 26.6 mm | 0.4 g |
| | | **Total printed** | tallest 111.5 mm | **22.9 g** |

## Print settings

- **Material:** PLA (the masses and flight numbers assume PLA, 1.24 g/cm3). PETG works but is a little heavier.
- **Nozzle and layers:** 0.4 mm nozzle, 0.2 mm layers (0.16 mm for the motor cap if its thread binds).
- **Walls:** 4 perimeters (at least 1.6 mm), so the 1.5 mm tube walls and the fins print solid. Top/bottom 5 layers.
- **Infill:** 20 % gyroid (only the thick bits have any: the tail, the cap, the nose tip).
- **Orientation:** as exported (each STL already rests on z = 0 in its print orientation). Do not rotate.
- **Supports:** none. The overhangs (forward lug underside, anchor strap, nose tie bar recess) are 45 degrees or bridged by design.
- **Bed adhesion:** clean PEI or glue stick; brim only on the rod standoff (F).

| Part | Orientation note |
|---|---|
| A | Tip up, shoulder on the bed. The shoulder's bed edge can bulge: sand it before fitting. |
| B | Upright, as exported (strap prints without supports). Sand the bed edge of the shoulder. |
| D | Upright on the tail, as exported; the fins stand vertical and the forward lug's 45-degree underside needs no support. |
| E | Flat face on the bed, as exported. 0.16 mm layers give a smoother thread if it binds. |
| F | Upright, as exported. Tall and thin: add a 3-5 mm brim. |

## Flying it

- **Stability:** 1.15 calibers with the A3 (the heaviest M13 motor) and the default recovery allowance (4.9 g): stable. CG 122.1 mm and CP 140.9 mm from the nose tip; liftoff mass 35.9 g.
- **Recommended motor (app, target 150 m):** **A3-4**, predicted apogee **136 m (446 ft)**, 1.15 cal.
- **Motors that pass the app's checks:** A10-3 (115 m), A3-4 (136 m).

| Motor | Apogee | Margin | Verdict |
|---|---|---|---|
| 1/4A3-3 | 14 m | 1.34 cal | Slow off the rod, Too low for recovery |
| 1/2A3-2 | 45 m | 1.3 cal | Slow off the rod |
| A10-3 | 115 m | 1.26 cal | OK |
| A3-4 | 136 m | 1.15 cal | OK |

- **Recovery:** **12 in** parachute (at least 8.2 in): about 3.1 m/s down with 32.6 g; light enough for a streamer instead.
- **Shock cord:** flat 1/8 in (3 mm) braided elastic, 0.4-0.6 m long (2-3 x the rocket's 190 mm). Round 1/8 in elastic also fits.
- **Field:** at least 200 m on a side with the A3-4 (NAR minimum 30 m).
- Weigh the printed parts and re-run the design in the app (Advanced: mass overrides) before the first flight.

## Assembly order

Follow `docs/assembly/assembly-guide.html` (or the PDF). In short:

1. Check every part: sand the bed-edge lip off the shoulders and the start of the tail thread; no cracks.
2. Dry-fit the joints: B and D slide together, A's shoulder slides into B (only the motor cap E is threaded).
3. Tie the shock cord behind B's anchor strap, and its other end to A's tie bar; tie the parachute on near A.
4. Wadding, then fold in the parachute and cord; fit A.
5. Motor in (nozzle end last), screw on E.
6. At the pad: F clips onto the rod, and the rocket's lugs slide down onto it until the aft lug sits on F.
