the-feve/rocket-builder-web/docs/kits/test-prints/starter-m18/README.md

# Starter kit (M18, 18 mm motors): test prints

Generated by `tools/make_test_prints.py` through the app's own build path (Rocket Builder 0.1.0); the STLs are the ones in `starter-m18-rocket.zip`, which is what the app's Download gives. Open `design.json` with **Open file** in the app to see or change this design.

## Design

| Setting | Value |
|---|---|
| Mode | Beginner |
| Motor size | M18 |
| Overall height (asked / built) | 300 mm / 300.0 mm |
| Printer max height | 256 mm |
| Fins | 3 x trapezoid, auto-sized (span/sweep scale 1.164) |
| Nose | tangent ogive, fineness 3.0 |
| Body | OD 21.4 mm, wall 1.5 mm, length 237.9 mm |
| Launch lugs | two (aft + forward), 1/8 in rod, 4.0 mm bore; rod standoff on |
| Filament | PLA |

## Parts

Heights and masses are the generator's (solid plastic; a real print with infill is lighter, so weigh it). Every part must fit under the printer's 256 mm (the generator keeps 5 mm spare).

| Letter | File | Part | Print height | Solid mass |
|---|---|---|---|---|
| **A** | `A_nose.stl` | Nose cone. Its tie bar inside the shoulder takes the shock cord's top end. | 74.2 mm | 6.4 g |
| **B** | `B_anchor_section.stl` | Anchor section: the body tube's top piece, with the strap the shock cord ties to. | 43.3 mm | 5.4 g |
| **D** | `D_fin_can.stl` | Fin can: fins, motor bay, launch lugs and the threaded tail. | 204.1 mm | 29.4 g |
| **E** | `E_motor_cap.stl` | Motor cap: screws onto the tail and holds the motor in. | 9.5 mm | 2.3 g |
| **F** | `F_rod_standoff.stl` | Rod standoff: clips onto the launch rod under the aft lug, so the motor cap clears the blast deflector. | 26.5 mm | 0.4 g |
| | | **Total printed** | tallest 204.1 mm | **44.0 g** |

## Print settings

- **Material:** PLA (the masses and flight numbers assume PLA, 1.24 g/cm3). PETG works but is a little heavier.
- **Nozzle and layers:** 0.4 mm nozzle, 0.2 mm layers (0.16 mm for the motor cap if its thread binds).
- **Walls:** 4 perimeters (at least 1.6 mm), so the 1.5 mm tube walls and the fins print solid. Top/bottom 5 layers.
- **Infill:** 20 % gyroid (only the thick bits have any: the tail, the cap, the nose tip).
- **Orientation:** as exported (each STL already rests on z = 0 in its print orientation). Do not rotate.
- **Supports:** none. The overhangs (forward lug underside, anchor strap, nose tie bar recess) are 45 degrees or bridged by design.
- **Bed adhesion:** clean PEI or glue stick; brim only on the rod standoff (F).

| Part | Orientation note |
|---|---|
| A | Tip up, shoulder on the bed. The shoulder's bed edge can bulge: sand it before fitting. |
| B | Upright, as exported (strap prints without supports). Sand the bed edge of the shoulder. |
| D | Upright on the tail, as exported; the fins stand vertical and the forward lug's 45-degree underside needs no support. |
| E | Flat face on the bed, as exported. 0.16 mm layers give a smoother thread if it binds. |
| F | Upright, as exported. Tall and thin: add a 3-5 mm brim. |

## Flying it

- **Stability:** 1.15 calibers with the C5 (the heaviest M18 motor) and the default recovery allowance (6.4 g): stable. CG 197.8 mm and CP 222.4 mm from the nose tip; liftoff mass 74.8 g.
- **Recommended motor (app, target 150 m):** **B6-4**, predicted apogee **143 m (469 ft)**, 1.4 cal.
- **Motors that pass the app's checks:** B6-4 (143 m), B4-6 (178 m), C5-3 (309 m), C6-7 (356 m).

| Motor | Apogee | Margin | Verdict |
|---|---|---|---|
| 1/2A6-2 | 13 m | 1.59 cal | Slow off the rod, Too low for recovery |
| A8-3 | 58 m | 1.54 cal | Too heavy for this motor, Slow off the rod |
| B6-4 | 143 m | 1.4 cal | OK |
| B4-6 | 178 m | 1.41 cal | OK |
| C5-3 | 309 m | 1.15 cal | OK |
| C6-7 | 356 m | 1.18 cal | OK |

- **Recovery:** **12 in** parachute (at least 11.5 in): about 4.3 m/s down with 63.5 g.
- **Shock cord:** flat 1/8 in (3 mm) braided elastic, 0.6-0.9 m long (2-3 x the rocket's 300 mm). Round 1/8 in elastic also fits.
- **Field:** at least 150 m on a side with the B6-4 (NAR minimum 60 m).
- Weigh the printed parts and re-run the design in the app (Advanced: mass overrides) before the first flight.

## Assembly order

Follow `docs/assembly/assembly-guide.html` (or the PDF). In short:

1. Check every part: sand the bed-edge lip off the shoulders and the start of the tail thread; no cracks.
2. Dry-fit the joints: B and D slide together, A's shoulder slides into B (only the motor cap E is threaded).
3. Tie the shock cord behind B's anchor strap, and its other end to A's tie bar; tie the parachute on near A.
4. Wadding, then fold in the parachute and cord; fit A.
5. Motor in (nozzle end last), screw on E.
6. At the pad: F clips onto the rod, and the rocket's lugs slide down onto it until the aft lug sits on F.
