the-feve/rocket-builder-web/docs/assembly/assembly-guide.pdf

KEEP THESE INSTRUCTIONS FOR FUTURE REFERENCE

## You printed a rocket. Now let's fly it!

This guide is for rockets made with Rocket Builder (rocket.quiverdesignworks.net). It shows what to do after the parts come off the printer: put them together, tie on the parachute, add a motor and launch.
Read each step all the way through before you start it. Work with a grown-up. Steps marked ADULT STEP are for the grown-up only.

The drawings show two sizes of rocket: an 18 mm (M18) rocket with one body piece, and a taller 24 mm (M24) one with two. Yours may have more or fewer body pieces. Drawings are not to scale.

WHAT YOU NEED | NOT IN THE BOX: MOTOR, IGNITER, LAUNCH PAD AND CONTROLLER

Fine
sandpaper
220–400 grit

Hobby knife
adults only

Medium
super glue
CA, like
Starbond
Medium

Ruler
in mm

Pencil
to mark the
balance point

Scissors
cord, wadding

Masking
tape
fit fixes

Stiff wire
to push the
cord through

Rubbing
alcohol
cleans joints
before gluing

WHAT HAPPENS IN A FLIGHT

1. The igniter lights the motor. The rocket slides up the launch rod.
2. The motor burns out. The rocket coasts up to the top of its flight.
3. The motor's ejection charge puffs gas up the body. It pushes the wadding, the parachute and the nose out of the top.
4. The nose stays tied to the body by the shock cord. The parachute opens. Everything floats down together.

HOW THE PARTS HOLD TOGETHER

Fins are printed on the aft section. No fin gluing! Body pieces slide together on short shoulders. You glue these joints so they stay shut.
The nose slides in too, but is never glued. It must pop off.
The motor pushes against a ring at the top of its tube. The motor cap screws onto the tail and holds it in.

SAFETY FIRST
Model rocket motors and igniters are handled by an adult. Fly only in a big open field, with a launch pad and an electric launch controller, and follow the National Association of Rocketry (NAR) Model Rocket Safety Code (summary on page 8).

STEPS AT A GLANCE

Build p. 3
Clean up, test-fit and glue the body.

Recovery p. 4–5
Tie on the cord and parachute, fold, pack.

Motor and pad p. 6–7
Adult steps: motor, cap, igniter, launch.
MY ROCKET | FILL THIS IN

NAME

BUILDER

MOTOR SIZE

BEST MOTOR

PARACHUTE

BALANCE POINT
Copy these from your rocket's report in Rocket Builder or from build_notes.txt in your download. The balance
point is the CG, in mm from the nose tip.
1–3 | 4–8 | 9–12
Rocket Builder by Quiver Design Works · Assembly guide | rocket.quiverdesignworks.net | 1

## Parts layout

Lay out your parts and check them off. Each part has a letter. The steps use the same letters.

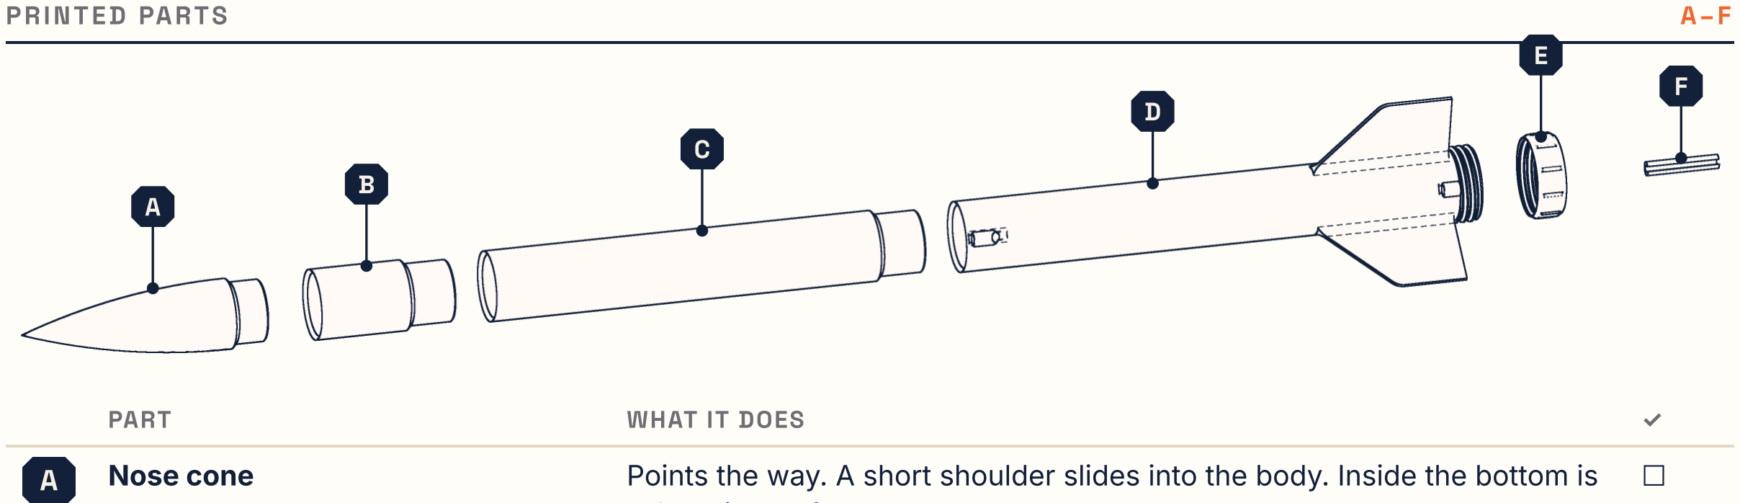
[picture p49: figure]
PRINTED PARTS; PART; WHAT IT DOES

Nose cone | Points the way. A short shoulder slides into the body. Inside the bottom is a little tie bar for the shock cord.
Anchor section | The short body piece under the nose. A strap (a bar across the inside) holds the shock cord.

☐

Body section (C1, C2… or none) Tall rockets are split into pieces that fit your printer. Short rockets have no C: B fits straight onto D.

☐

Aft section | The tail, with the fins, the launch lug(s) and the motor tube. The thread at the bottom is for the cap.

☐

Motor cap | Screws onto the tail and holds the motor in. The hole lets the motor's flame out.

☐

Rod standoff | A clip for the launch rod. It stays on the pad and holds the rocket up off the blast plate.

☐

YOU ADD | G–L

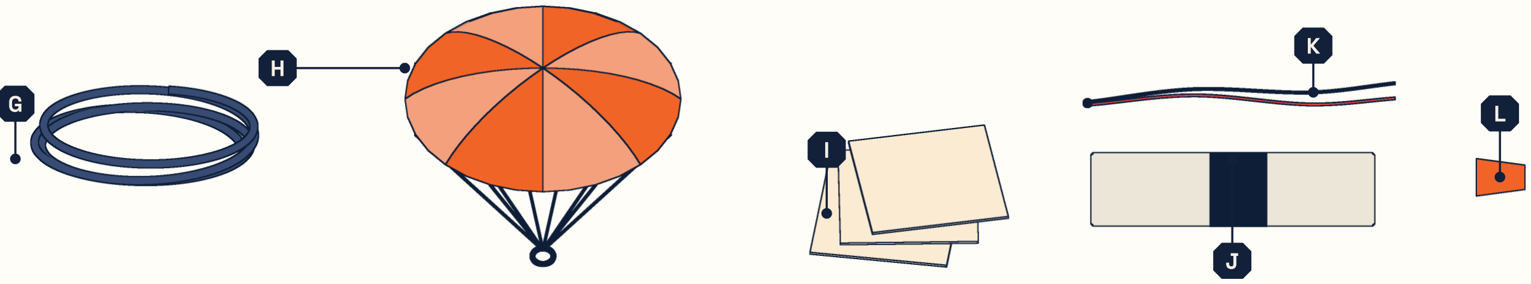
[picture p50: figure]

Shock cord | Braided elastic, at least 3 times as long as the rocket, and never shorter than 36 in (90 cm). Flat 1/8 in (3 mm) wide for 13 and 18 mm motors, flat 1/4 in (6 mm) for 24 and 29 mm. Round 1/8 in elastic fits too. The strap and nose are made for these.
Parachute (or streamer) | Use the size your Rocket Builder report suggests (“Which parachute?”). Very light rockets can use a streamer. Optional: a small snap swivel (size 14 for parachutes up to 12 in) tied to its lines.
Recovery wadding | Flame-resistant tissue. It keeps the hot ejection gas off the parachute. Use new wadding every flight.
Motor ADULT | A certified model rocket motor of your rocket's size (M13, M18, M24 or M29) and length. Use the motor your report recommends.
Igniter and plug ADULT | Come with the motors. The plug holds the igniter in the nozzle.

TIP
Not sure which motor or parachute? Your rocket's report in Rocket Builder shows the best motor, the parachute size and the launch field it needs.

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
K | L
Rocket Builder by Quiver Design Works · Assembly guide | rocket.quiverdesignworks.net | 2

## Build the rocket

### Clean up the prints

Pull off any brim, strings and blobs.
The edge that sat on the print bed can bulge out a little. Sand that lip off the shoulders (the narrow ends) and the start of the tail thread.
Look for cracks, gaps between layers or thin spots, especially where the fins meet the tube. Don't fly a cracked part. Print it again.

### Test-fit every joint (no glue yet)

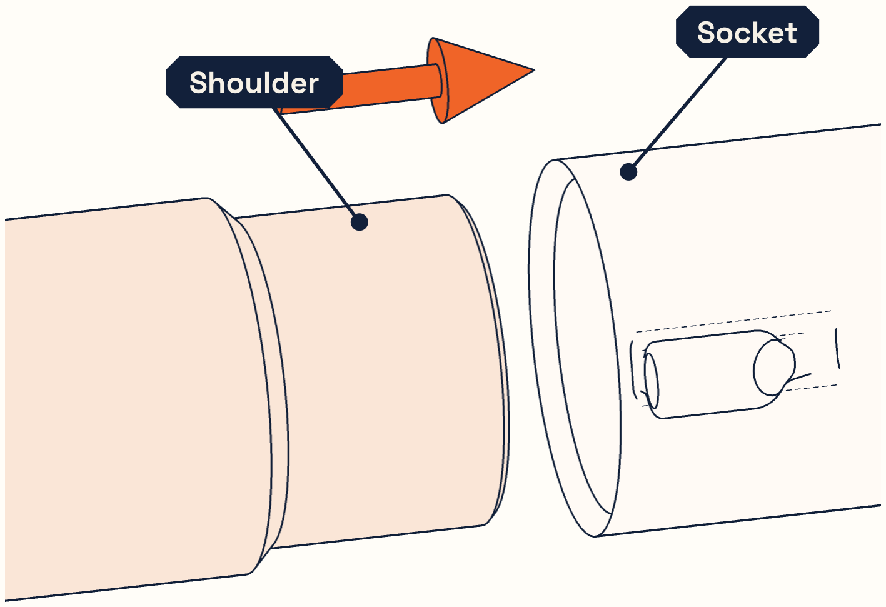
[picture p51: figure]
Shoulder; Socket

Push each shoulder into the next part with a little twist. It should go all the way in, snug, with no gap at the seam. Too tight? Sand the shoulder lightly and try again.

### Glue the body joints, with the launch lugs in line

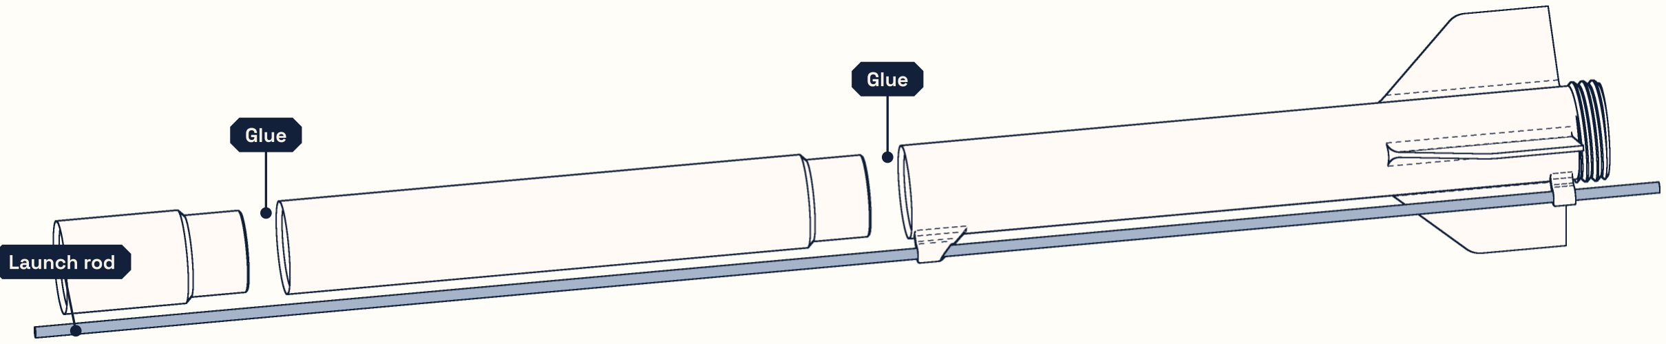
[picture p52: figure]
Glue; Launch rod

1. Sand the shoulder of C lightly, so it isn't shiny. Wipe it with rubbing alcohol. Let it dry.
2. Grown-up: put a thin ring of medium super glue round the shoulder, near its step.
3. Push it into D in one smooth push, all the way. Hold it 30 seconds. Don't stop halfway: the glue grabs in about 10 seconds.
4. Slide a launch rod through the lugs while the glue sets, so they line up. Glue B onto C (or onto D if you have no
C) the same way.

DO NOT GLUE
the nose (A) or the motor cap (E). Keep glue out of the slot behind the strap in B. The fins are part of D: they need no glue.

TIP
Very tight joint? Push it together dry, then run a few drops of thin super glue round the seam: it soaks in. Printed in PETG? Super glue holds less well on PETG, so sand and clean it well.

SUPER GLUE SAFETY
A grown-up opens the glue and does the gluing, with a window open and safety glasses on. It sticks skin in seconds. Stuck fingers? Don't pull. Soak them in warm soapy water and roll them apart gently. Glue near an eye: don't force it open; cover it with a wet pad and see a doctor. Activator spray is for grown-ups only, outdoors: it's flammable. Never spray it inside a joint before pushing it together.
1 | 2

3

Rocket Builder by Quiver Design Works · Assembly guide | rocket.quiverdesignworks.net | 3

## Rig the recovery system

The recovery system is the shock cord, the parachute and the wadding. It brings your rocket down gently, all in one piece.

### Tie the cord to the strap

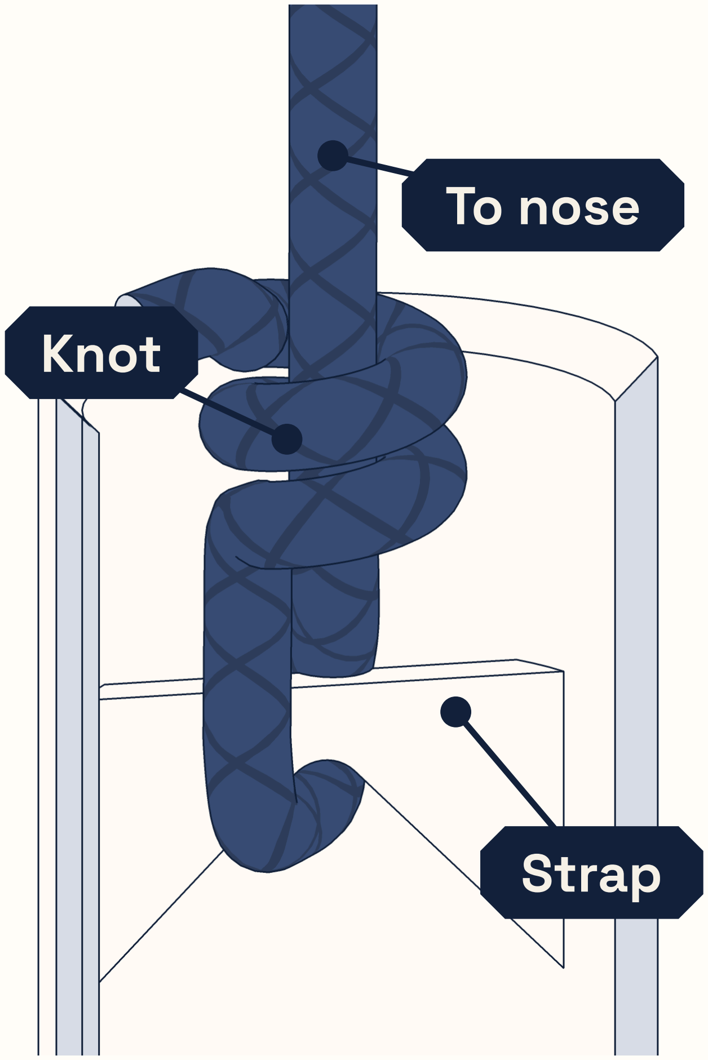
[picture p53: figure]
Strap; Knot; To nose
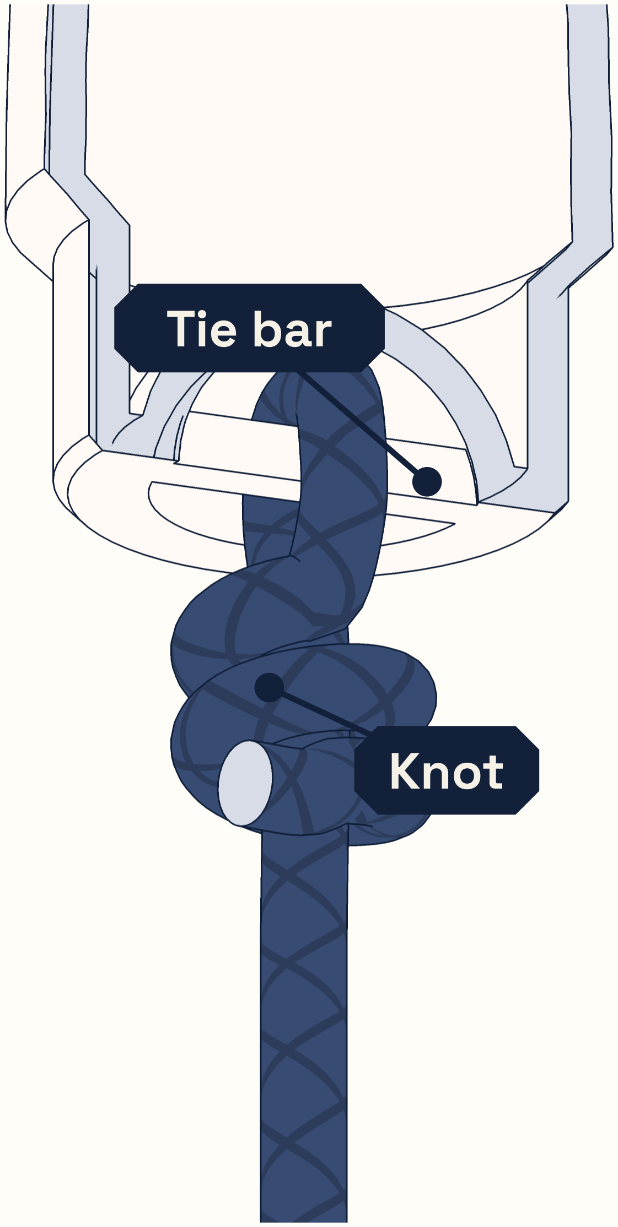
[picture p54: figure]
Tie bar; Knot

1. Look into the top of B. The strap is a flat bar across one side, with a slot behind it.
2. Push one end of the elastic down the slot behind the bar. Pinch the end flat, or push it with a stiff wire. Pull it out under the bar.
3. Bring it up in front of the bar. Tie it round the long part with two overhand knots, close to the bar. Leave a tail as long as your thumb.
4. Don't glue the knots: glue makes elastic brittle.

Easier before B is glued on. The drawing has the front of B cut

### Tie the other end to the nose

1. Turn the nose (A) over. A small tie bar crosses the dome in the bottom of its shoulder.
2. Push the cord's end up one side of the bar, over it and down the other side.
3. Tie it round the long part with two overhand knots, close to the nose. No glue.
4. Tug hard on the nose and the body. Nothing should slip.

### Tie the parachute on at the nose

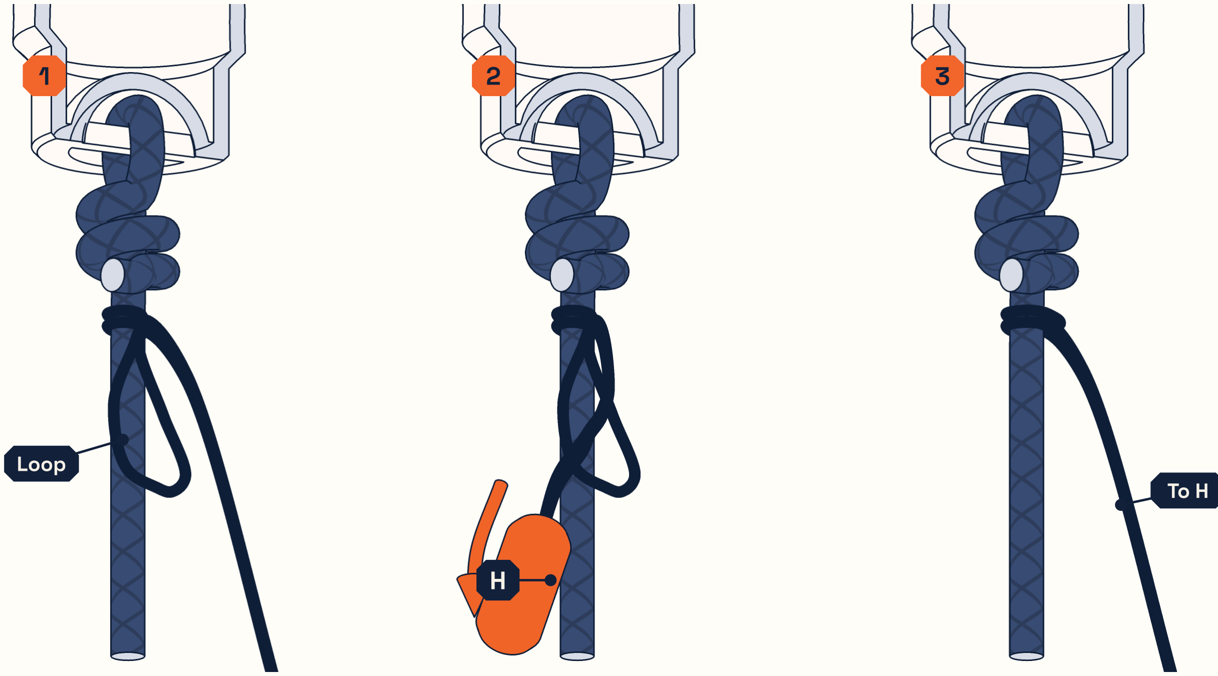
[picture p55: figure]
Loop

1. Hold the parachute's lines together by their ends so they make one loop. Pass the loop round the cord, just below the nose knot.
2. Push the whole parachute through the loop.
3. Pull snug against the knot (a lark's head). The knot stops it sliding. To swap parachutes, loosen the loop and undo steps 2 and 1.
On 24 mm and bigger rockets there's room to put the loop round the nose's tie bar itself, beside the cord. On 13 and 18 mm rockets the bar only has room for the cord, so use the cord, as drawn. Optional: tie a snap swivel to the lines' loop and clip it to the tie bar. It keeps the lines from twisting.

4

5

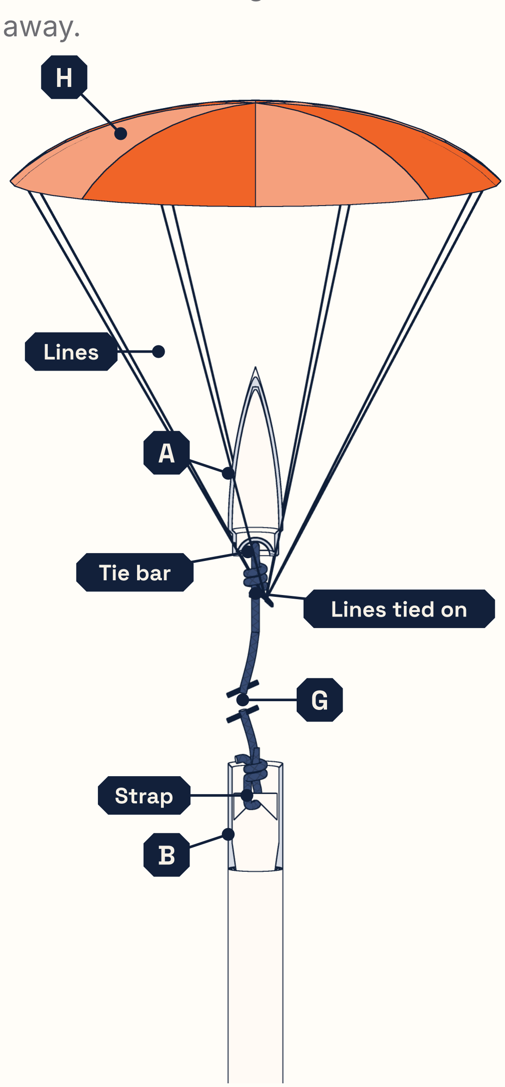
[picture p56: figure]
away.; Lines; Tie bar; Lines tied on; Strap

How it hangs together in the air. Not to scale: the cord is really at least 3 times the rocket's length (the break mark). The nose and B are drawn cut open.

6

Rocket Builder by Quiver Design Works · Assembly guide | rocket.quiverdesignworks.net | 4

## Fold and pack the parachute

### Fold and roll the parachute

1. Lay it flat. Pull the lines straight and even. Fold it in half along the dashed line.
2. Fold it in half along the dashed line, then in half once more. Now it's a thin wedge and the lines meet in one bundle.
3. Lay the lines back along the middle of the wedge. Fold both sides over them along the dashed lines.
4. Roll it up loosely from the point. Wrap the lines once round it, loosely. It should slide in and out of the body easily (drawn next to B, real size).

TIP
Fold it fresh before every flight and store it unfolded. A pinch of talc keeps a plastic parachute from sticking on cold days.

### Pack it: wadding, parachute, cord, nose

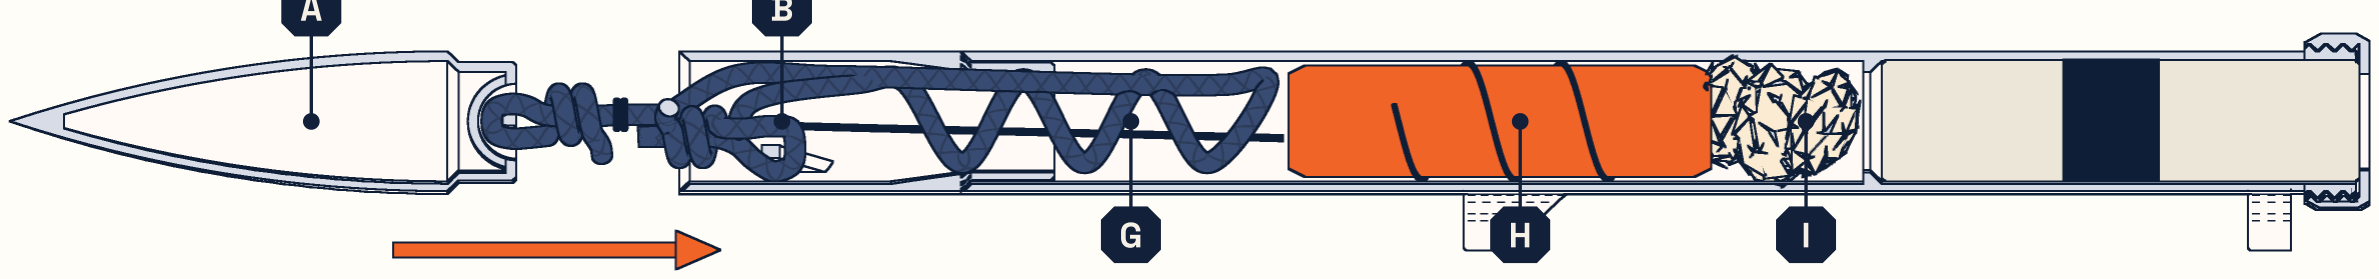
[picture p57: figure]

1. Loosely crumple wadding to fill about 1–2 body widths of the tube. Push it down until it sits on the ring at the top of the motor tube. Don't pack it hard.
2. Slide in the rolled parachute. Fold the cord in a zig-zag on top.
3. Push the nose on. Don't trap the cord or lines in the joint.
4. Slide-out check (first time): take the nose off and tip the rocket nose-down. The parachute and cord should slide out past the strap. If they stick, fold the parachute smaller or use a streamer.

CHECK THE NOSE FIT
Hold the rocket nose-down and shake gently: the nose should stay on. A gentle pull should take it off. Too loose? One wrap of masking tape on the nose's shoulder. Too tight? Sand the shoulder.

7

1
2

3

4
B

8

A | B
Rocket Builder by Quiver Design Works · Assembly guide | rocket.quiverdesignworks.net | 5

## Motor, cap and igniter

ADULT STEPS 9–12
A grown-up handles the motor and igniter. Use only certified model rocket motors, as they come. Never cut, drill, heat or change a motor. Keep motors and igniters away from heat and sparks until launch time.

### Slide the motor into the tail ADULT STEP

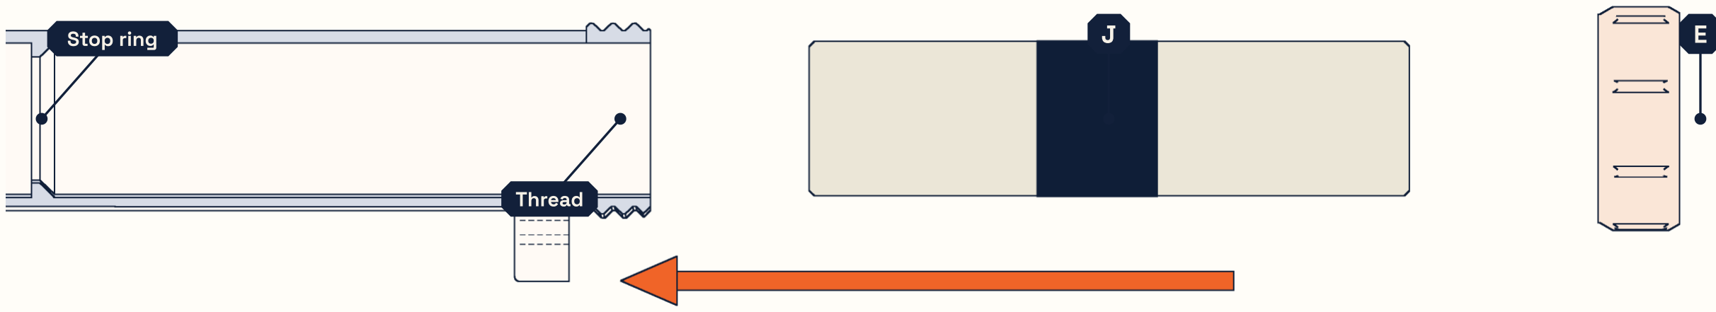
[picture p58: figure]
Stop ring; Thread

Check the size: an 18 mm motor for an M18 rocket, and so on.
Slide it in nozzle end last, so the nozzle points out of the tail.
Push it all the way, until it stops against the ring at the top of the motor tube. That ring takes the motor's push.

TOO TIGHT?
Never force a motor. Look for print strings inside the tube and sand them off. A full-length motor sticks out past the tail by about the height of the thread.

### Screw on the motor cap ADULT STEP

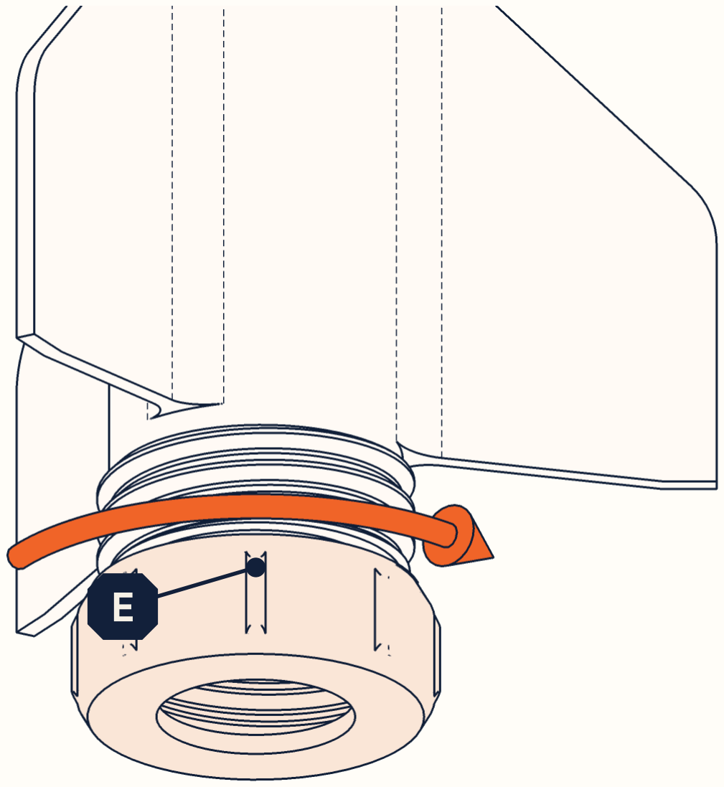
[picture p59: figure]

Turn the cap onto the thread, clockwise as you look at the tail. Start it straight so it doesn't cross-thread. Finger tight is enough. The cap's floor rests on the end of the motor, so the motor can't be pushed out of the back when the ejection charge fires.
Never glue or tape the cap on.

### Put in the igniter ADULT STEP

1. Do this at the pad, with the safety key out of the controller.
2. Push the igniter (K) through the cap's hole into the nozzle, all the way, until it touches the fuel.
3. Hold it there and push in the plug (L).
4. Bend the two leads apart so they can't touch.

9

10

11

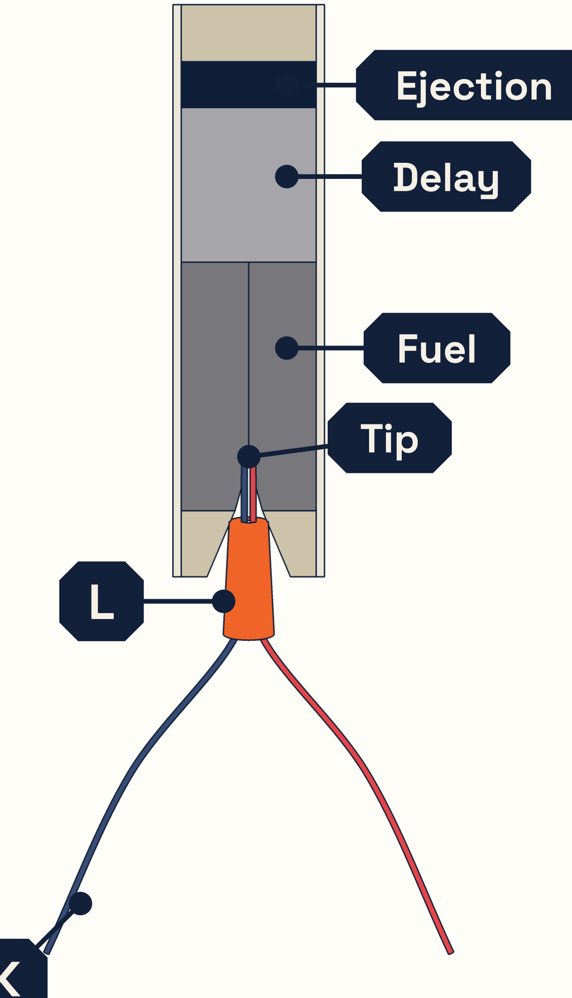
[picture p60: figure]
Ejection; Delay; Fuel; Tip

K

Rocket Builder by Quiver Design Works · Assembly guide | rocket.quiverdesignworks.net | 6

## Launch pad and preflight

### Set up on the pad

1. Snap the rod standoff (F) onto the rod, opening away from the rocket. Slide it down to the blast plate.
2. Slide the rocket down the rod by its lugs until the bottom lug rests on the standoff. The tail is now clear of the plate, with room for the clips.
3. Clip one controller clip to each igniter lead. Clips must not touch each other, the rod or the plate.
4. The rod points straight up (within 30°). Everyone steps back. Key in. Count down: 5, 4, 3, 2, 1, launch!

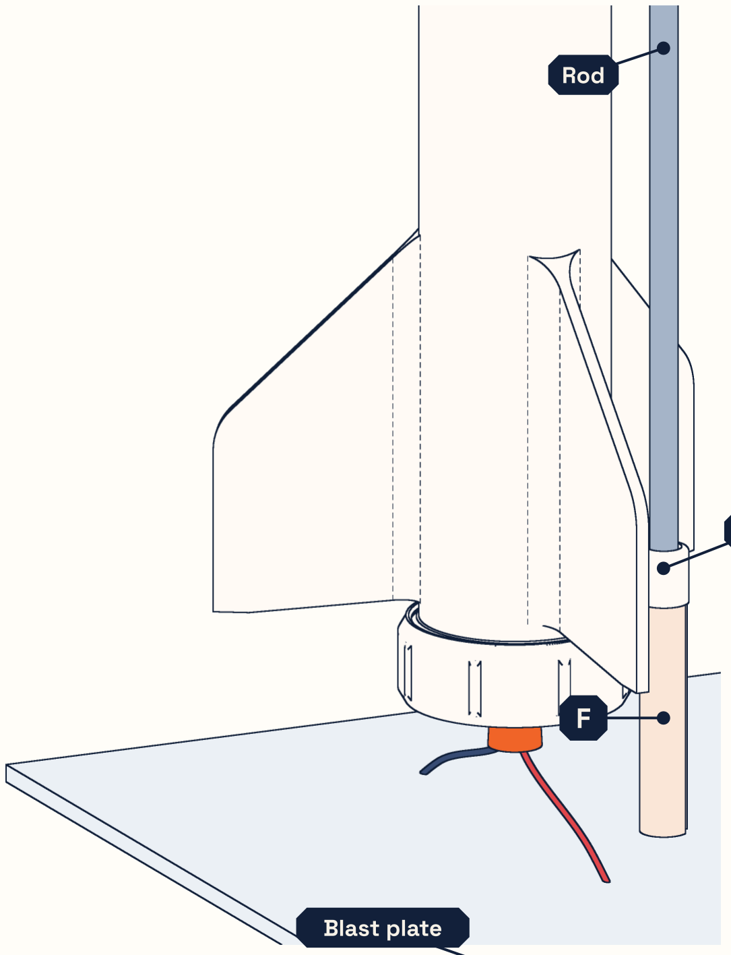
[picture p61: figure]
Rod; Blast plate

PREFLIGHT CHECKLIST | EVERY FLIGHT

No cracks. Fins solid. Body joints glued all the way
round.
Cord tied tight at the strap and the nose. Tug both ends;
replace a fuzzy, singed or stiff cord. Parachute hitched on at the nose.
New wadding, then the rolled parachute, then the cord. Nose snug, but it comes off.
Right motor, pushed all the way in. Cap on, finger tight. Balance test: with the motor in, the rocket balances on your finger at the balance point from your report, or nearer the nose. Mark that point with pencil. If it balances behind the mark (nearer the tail), don't fly.

The field is big enough (page 8). Wind under 20 mph. No low clouds or aircraft.
Launch rod 1/8 in (3.2 mm) unless you changed it in Advanced. Blast plate on. Standoff on the rod.
Dry grass and anything that burns cleared from around the pad.
The adult in charge keeps the safety key. Everyone at least 15 ft back (30 ft for motors bigger than D). Everyone watching. Count down out loud.

IF IT DOESN'T LAUNCH (MISFIRE)
Take out the safety key. Wait 60 seconds before anyone walks to the rocket. Then check the igniter, or put in a new one.

12

Lug

Rocket Builder by Quiver Design Works · Assembly guide | rocket.quiverdesignworks.net | 7

## Fly safely

SAFETY CODE, IN SHORT | NAR

Grown-ups handle motors and igniters. Only certified, factory-made motors, used as the maker says.
Electric launch only: a launch controller with a safety key and a switch that springs back to off.
Misfire? Key out, then wait 60 seconds before anyone goes to the rocket.
Launch pad: a rod or rail with a blast plate, within 30° of straight up. Cap the rod's tip when you're not launching.
Size limits: at most 1500 g at liftoff and 320 N·s of total motor impulse.
Where: outdoors, in an open field, away from buildings, power lines, roads and dry brush. Never launch at targets, into clouds, near aircraft, or with anything that burns as a payload. Recovery: always a parachute or streamer, with flame-resistant wadding. Never climb trees or power poles to get a rocket back.
This is a summary. Read the full code at nar.org/ModelRocketSafetyCode.
LAUNCH FIELD SIZE | NAR MINIMUM, EACH SIDE
MOTOR CLASS | FEET | METRES
1/4A, 1/2A | 50 | 15
A | 100 | 30
B | 200 | 60
C | 400 | 120
D | 500 | 150
E, F | 1000 | 300

On a breezy day a rocket can drift further than this. Your Rocket Builder report gives the size your rocket needs (“How big a launch field?”). Put the pad near the upwind edge.

AFTER THE FLIGHT

Let the motor cool. Unscrew the cap. Push the used motor out from the front with a dowel.
Shake out the burnt wadding. Wipe soot off the cap and thread.
Check the cord, knots, parachute and joints. Reprint a cracked cap or part.

TROUBLESHOOTING

PROBLEM | TRY THIS
A shoulder or the nose is too tight | Sand off the bulge at its bottom edge (it printed on the bed), then sand lightly all round.
Test often.
The nose falls off too easily | One wrap of masking tape round the nose's shoulder. Add more only if needed.
The cord won't go behind the strap | Pinch the end flat, or push it with a stiff wire. Clear print strings out of the slot. The slot fits
1/8 in round elastic or flat elastic folded double; thicker cord won't go.
The motor won't go in | Is it the right size? Clear strings from the motor tube. Never force it.
The cap won't screw on | Is the motor all the way in? Clean the first turn of the thread. Start the cap straight.
The motor didn't light | Key out, wait 60 s. Check the igniter tip touches the fuel and the clips are clean. Try a new
igniter.

The parachute didn't open, or melted More wadding. Roll the parachute looser. Check the motor's delay (the last number) matches your report.

The rocket wobbled or looped | Do the balance test. Check the score and motor in Rocket Builder. Don't fly again until it's
fixed.
The body came apart at a joint | That joint wasn't glued all the way round. Clean it and glue it again.

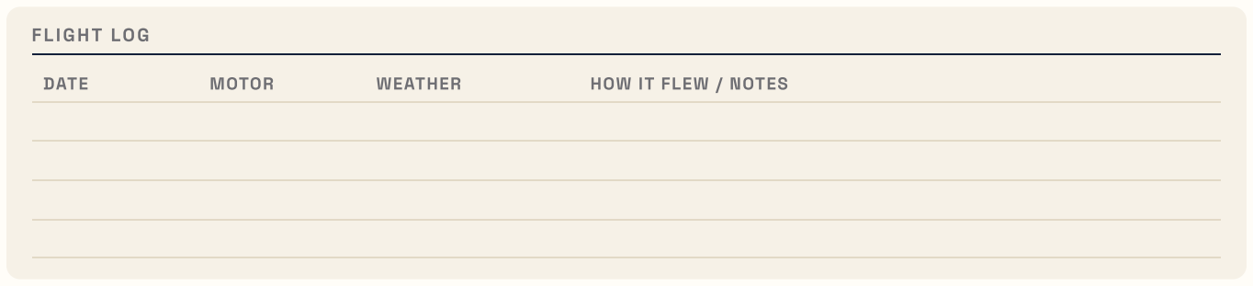
[picture p62: figure]
FLIGHT LOG; DATE; MOTOR; WEATHER; HOW IT FLEW / NOTES

Rocket Builder by Quiver Design Works · Assembly guide | rocket.quiverdesignworks.net | 8
