the-feve/rocket-builder-web/docs/assembly/images/anchor_cord.png

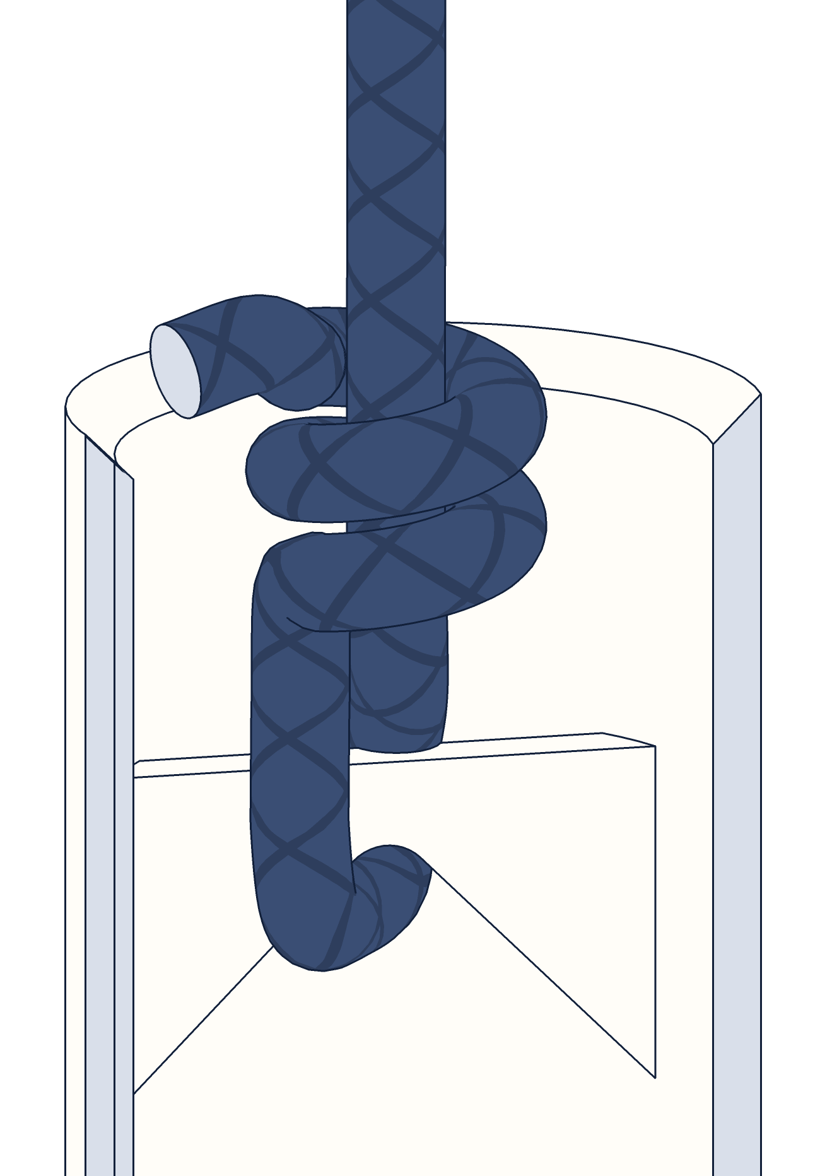
docs/assembly/images/anchor_cord.png
