the-feve/rocket-builder-web/docs/assembly/images/cap_on.png

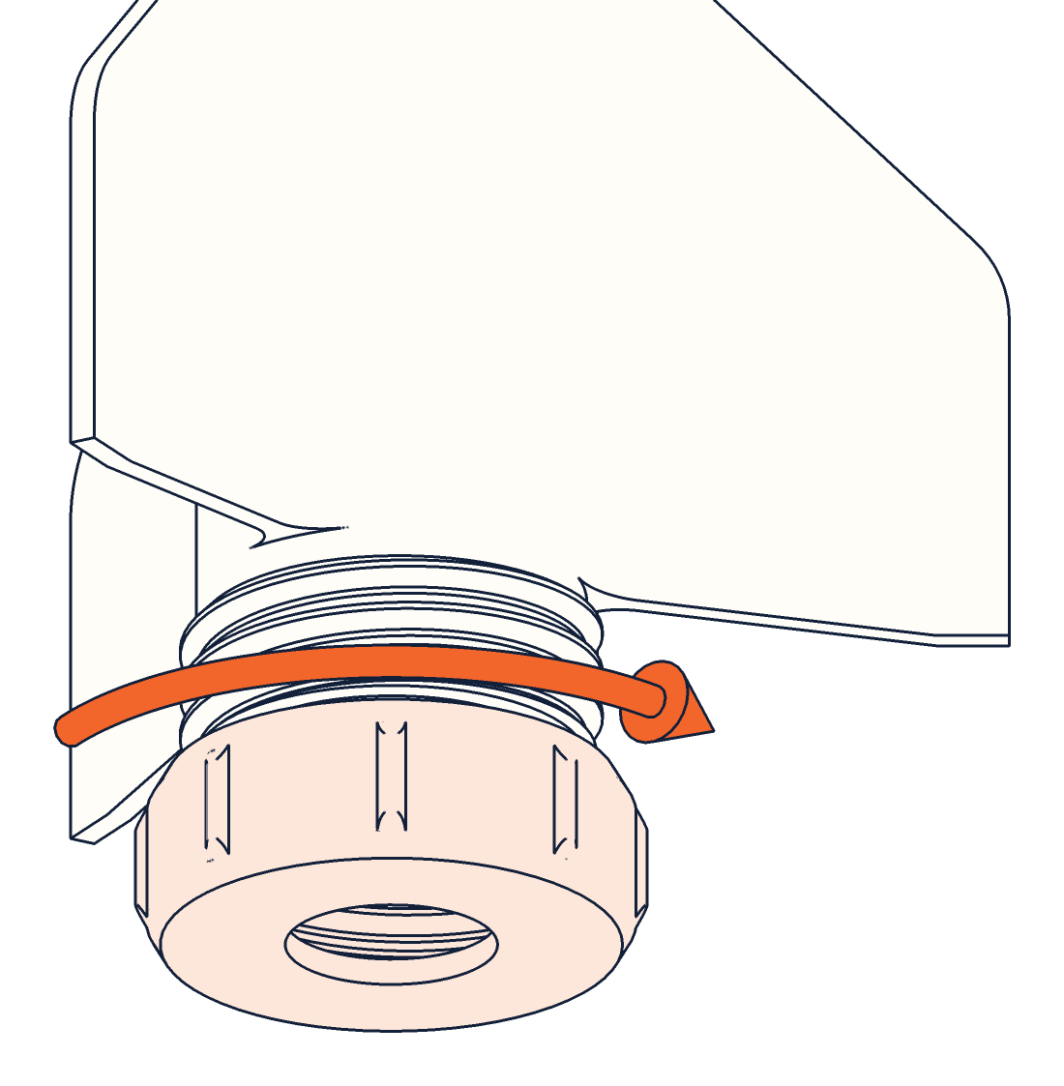
docs/assembly/images/cap_on.png
