the-feve/rocket-builder-web/docs/assembly/images/chute_fold.png

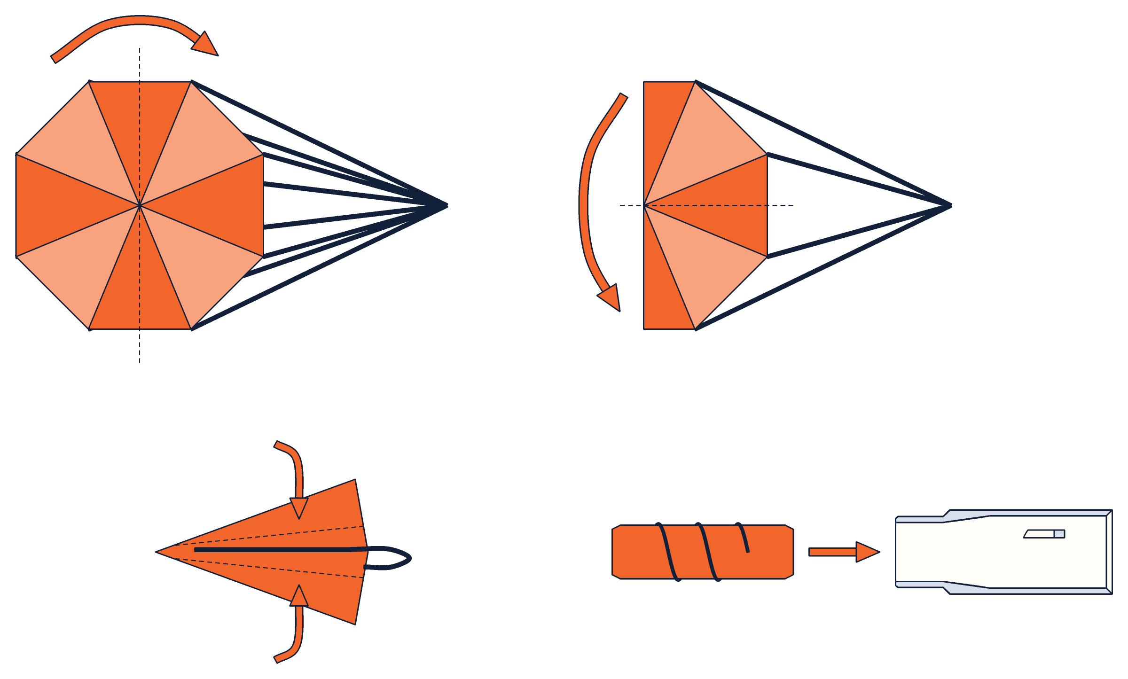
docs/assembly/images/chute_fold.png
