the-feve/rocket-builder-web/docs/assembly/images/hero.png

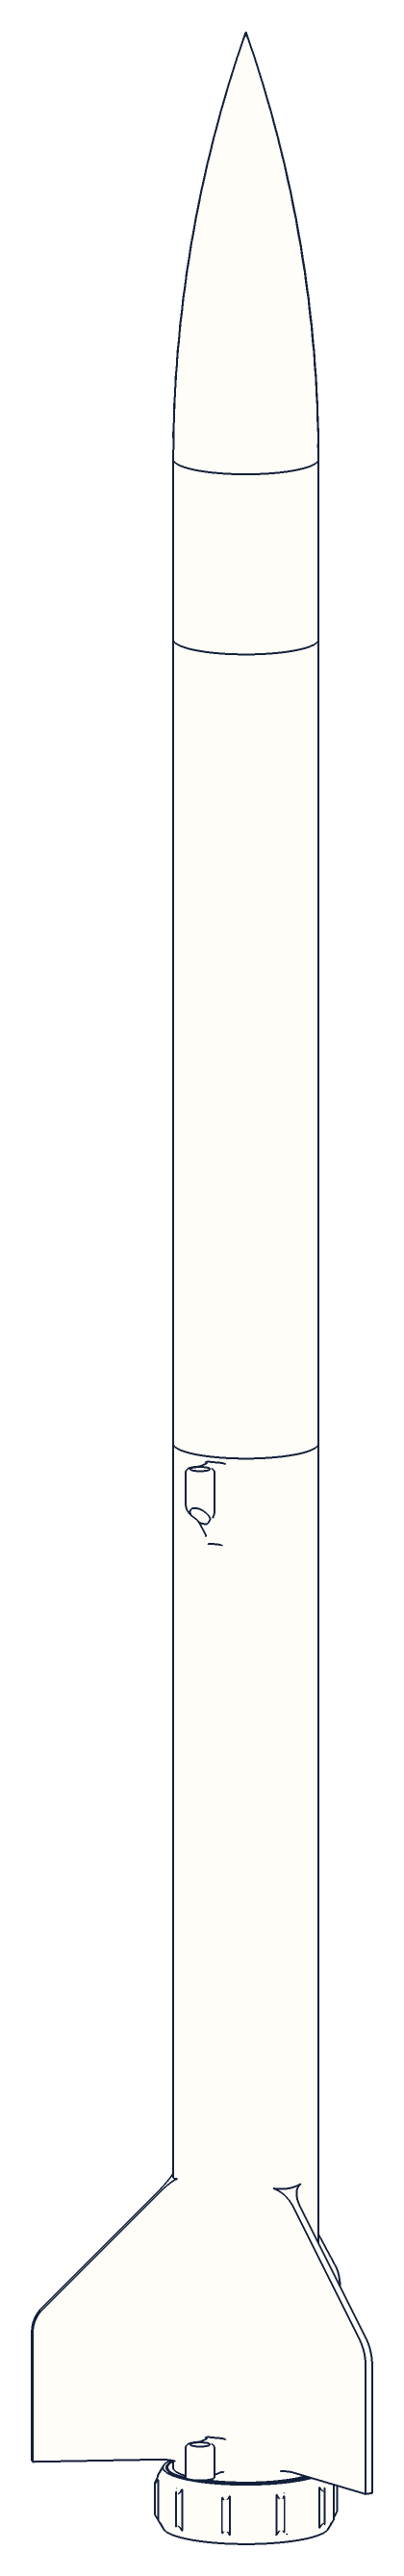
docs/assembly/images/hero.png
