the-feve/rocket-builder-web/docs/assembly/images/igniter.png

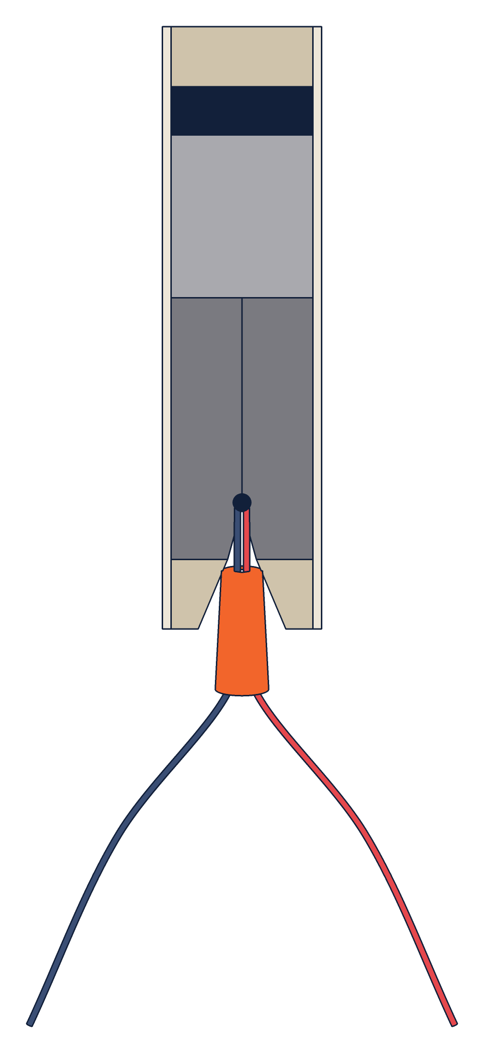
docs/assembly/images/igniter.png
