the-feve/rocket-builder-web/docs/assembly/images/join.png

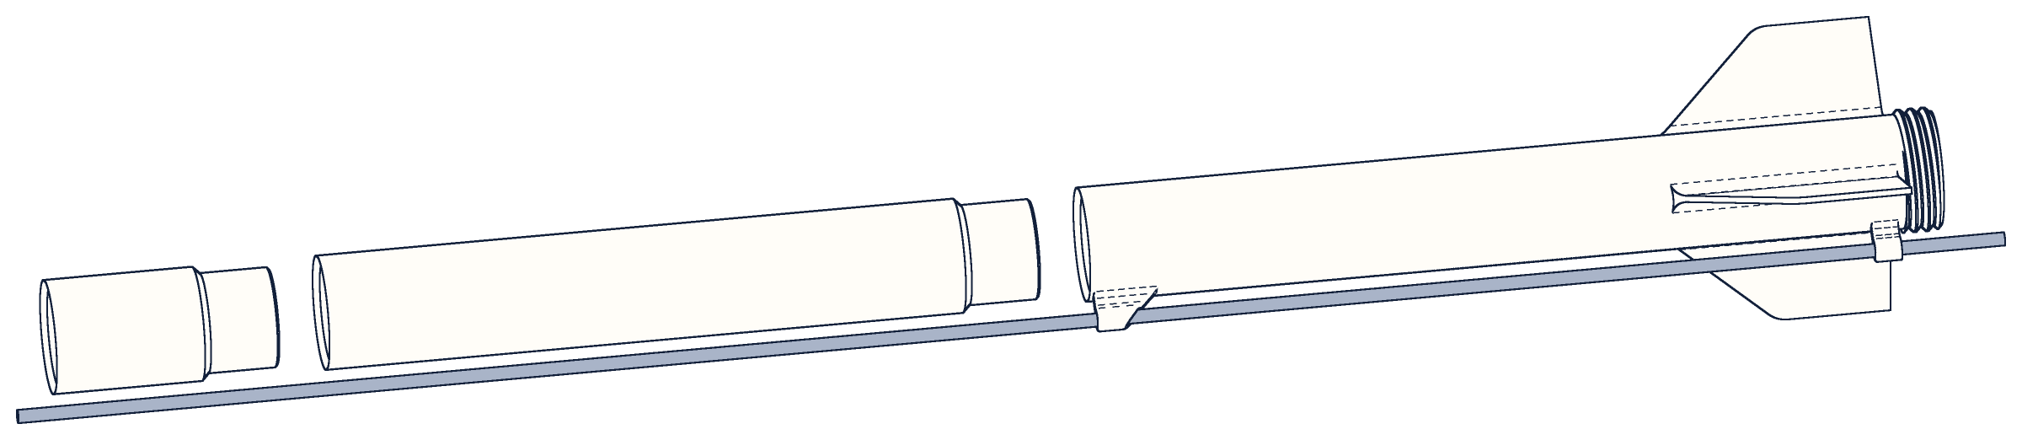
docs/assembly/images/join.png
