the-feve/rocket-builder-web/docs/assembly/images/joint.png

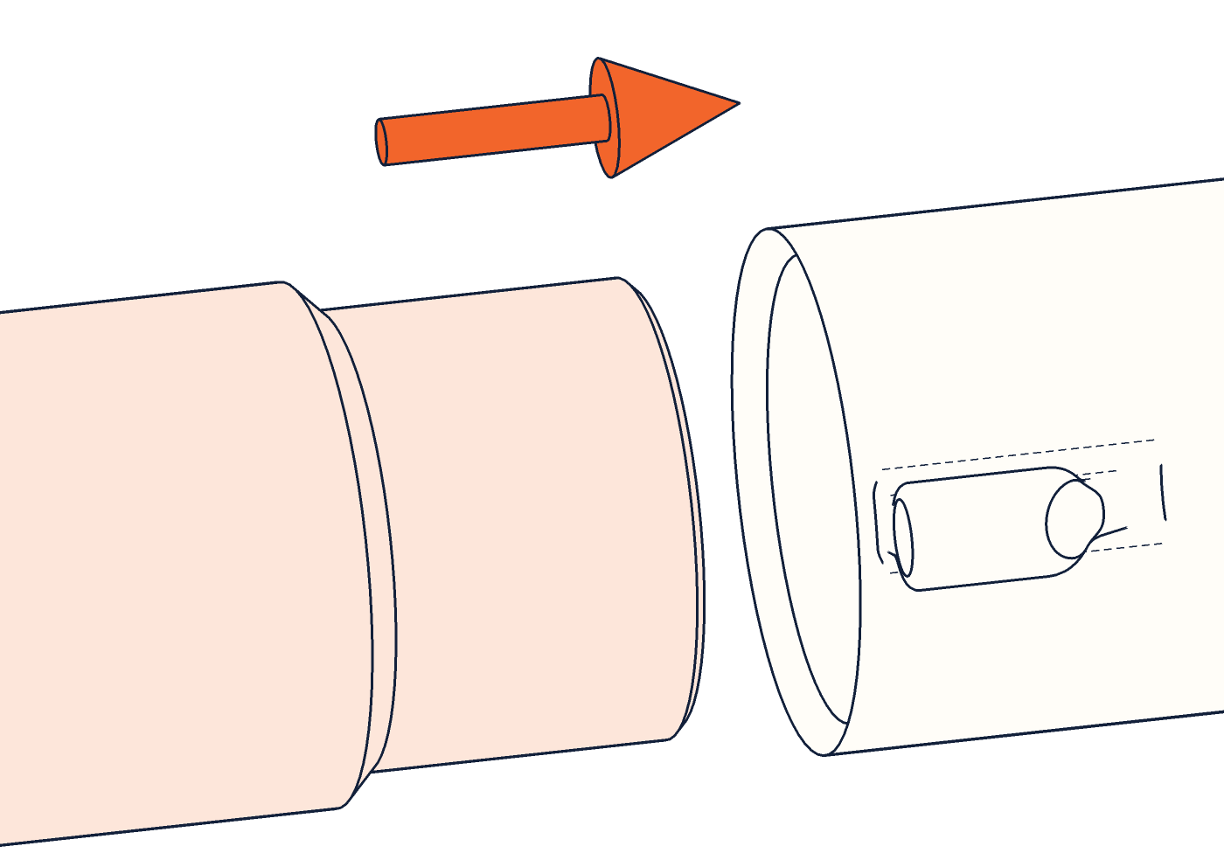
docs/assembly/images/joint.png
