the-feve/rocket-builder-web/docs/assembly/images/nose_cord.png

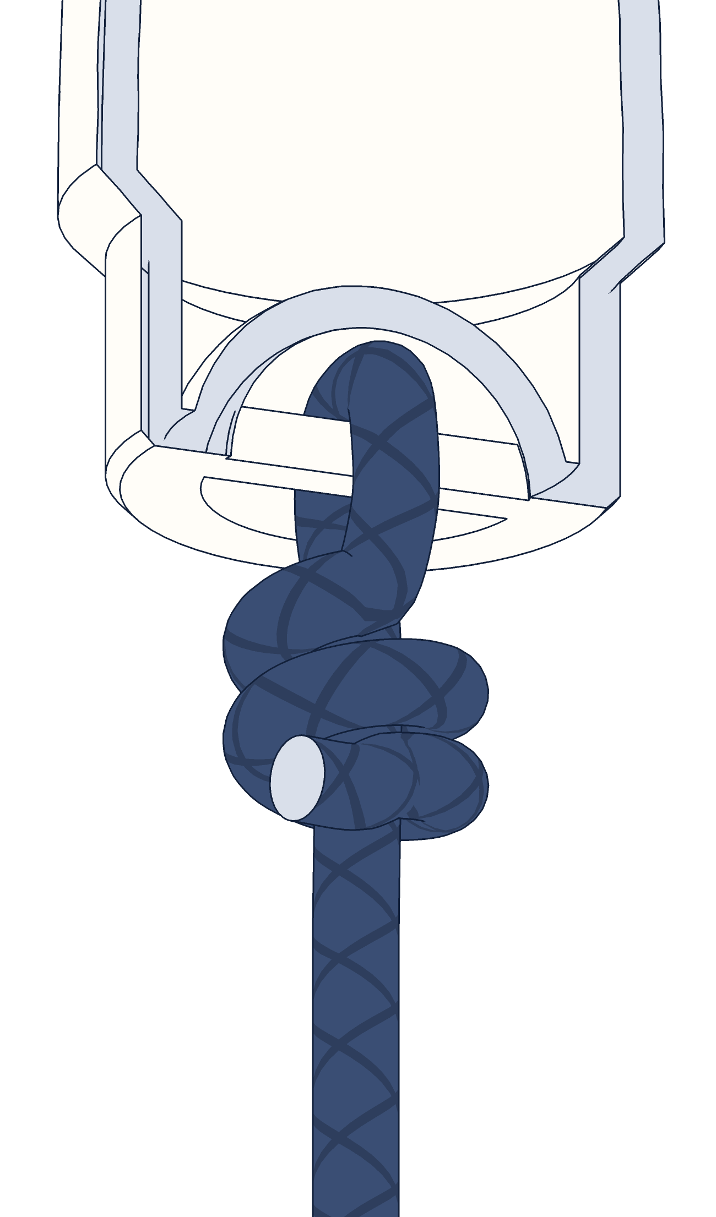
docs/assembly/images/nose_cord.png
