the-feve/rocket-builder-web/docs/assembly/images/pack.png

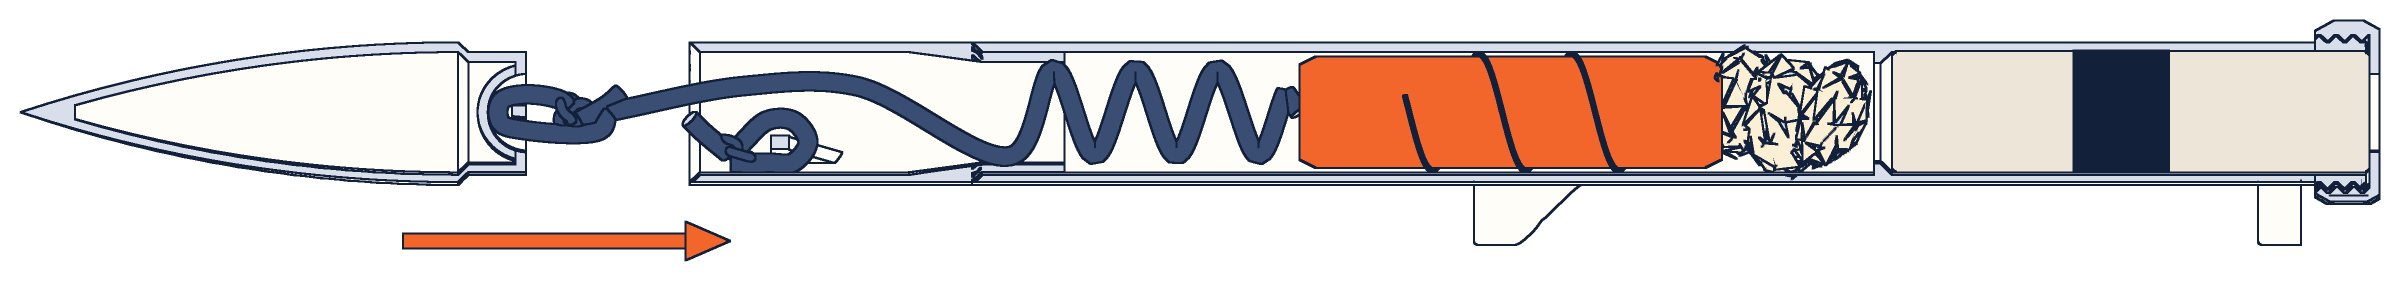
docs/assembly/images/pack.png
