the-feve/rocket-builder-web/docs/assembly/images/pad.png

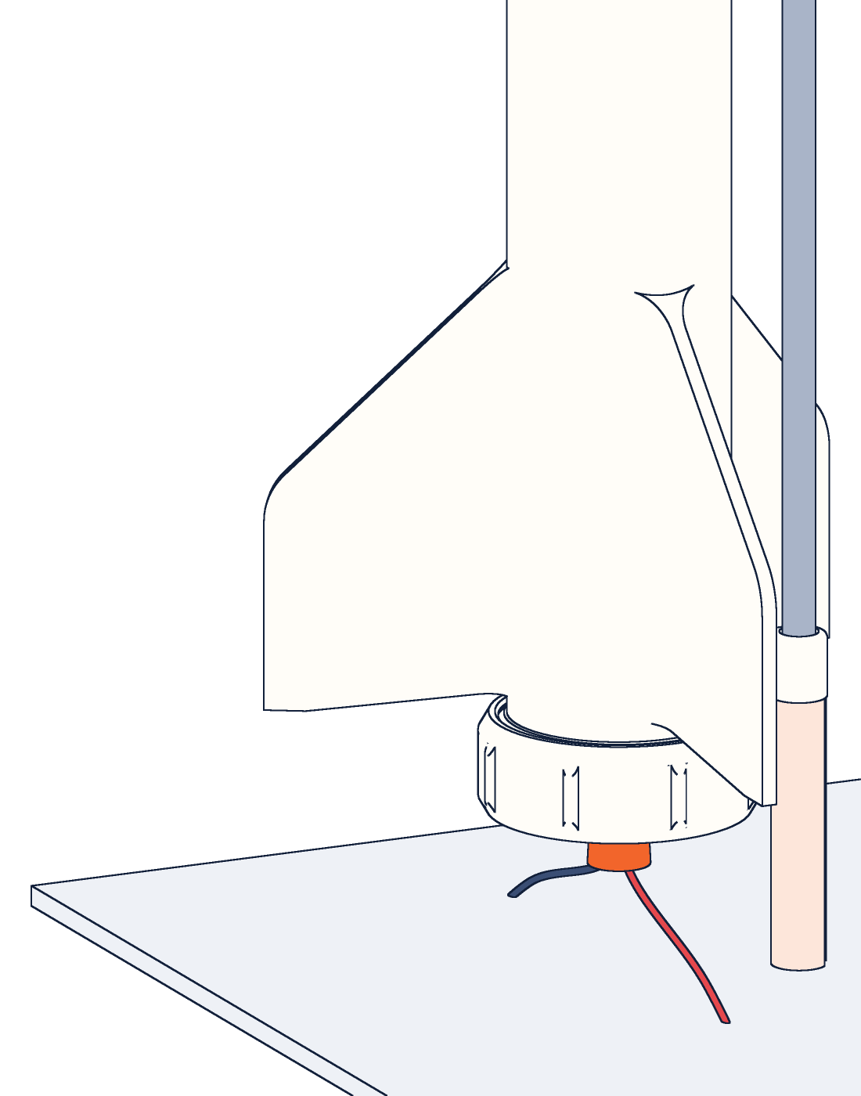
docs/assembly/images/pad.png
