the-feve/rocket-builder-web/docs/assembly/images/recovery.png

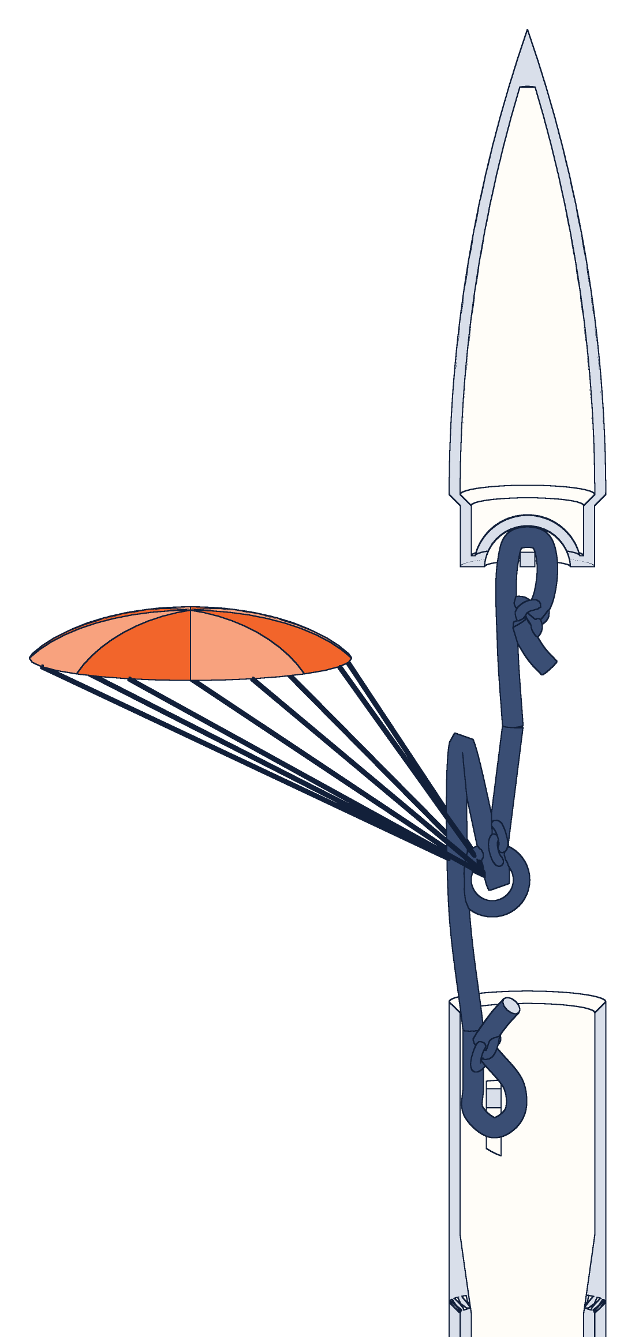
docs/assembly/images/recovery.png
