the-feve/rocket-builder-web/docs/kits/packaging/tube-wrap-big-print.png

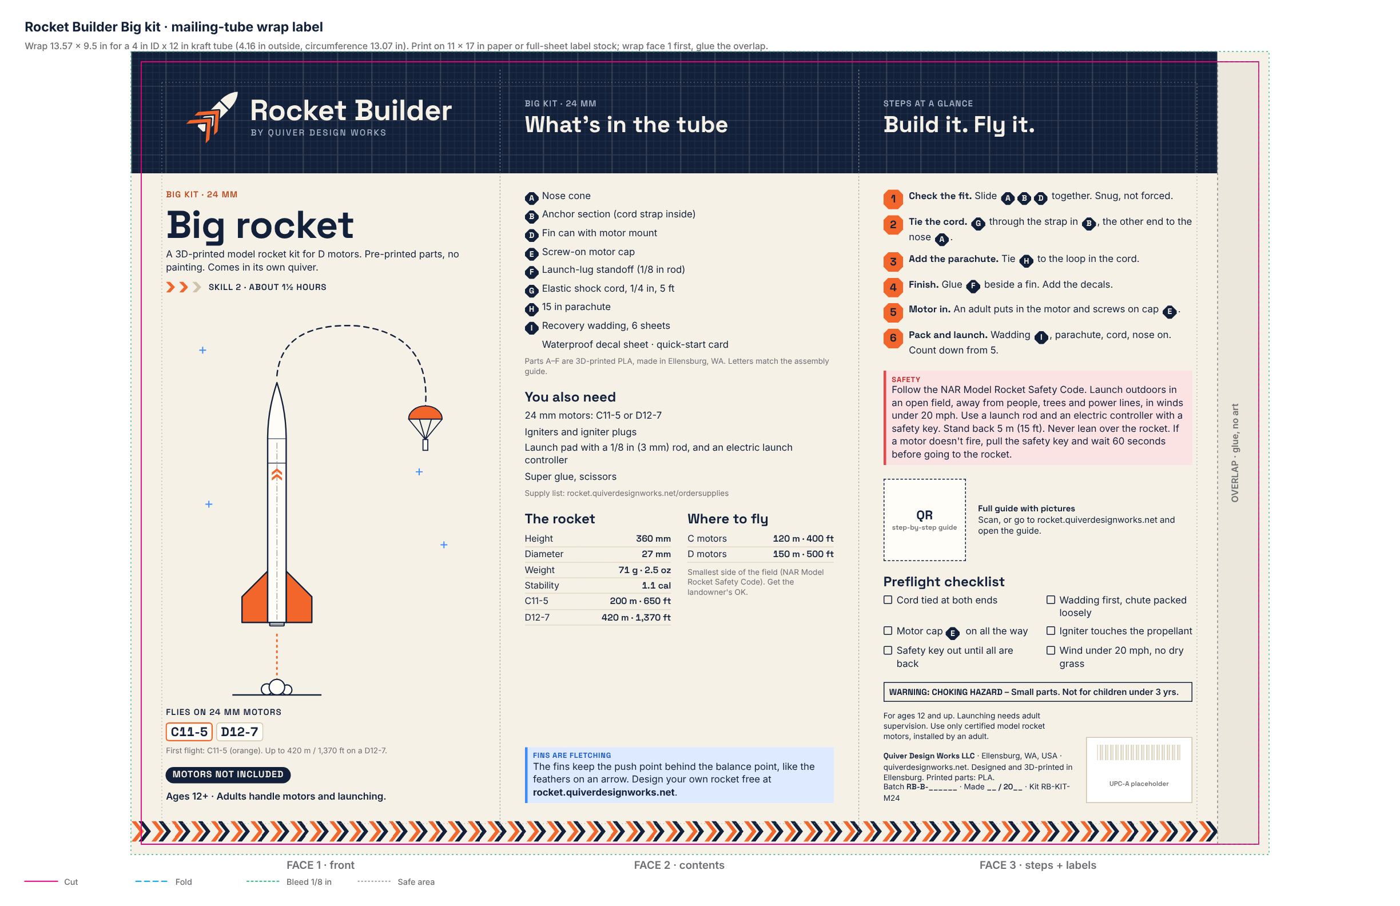
docs/kits/packaging/tube-wrap-big-print.png
