the-feve/rocket-builder-web/docs/kits/test-prints/big-m24/preview.png

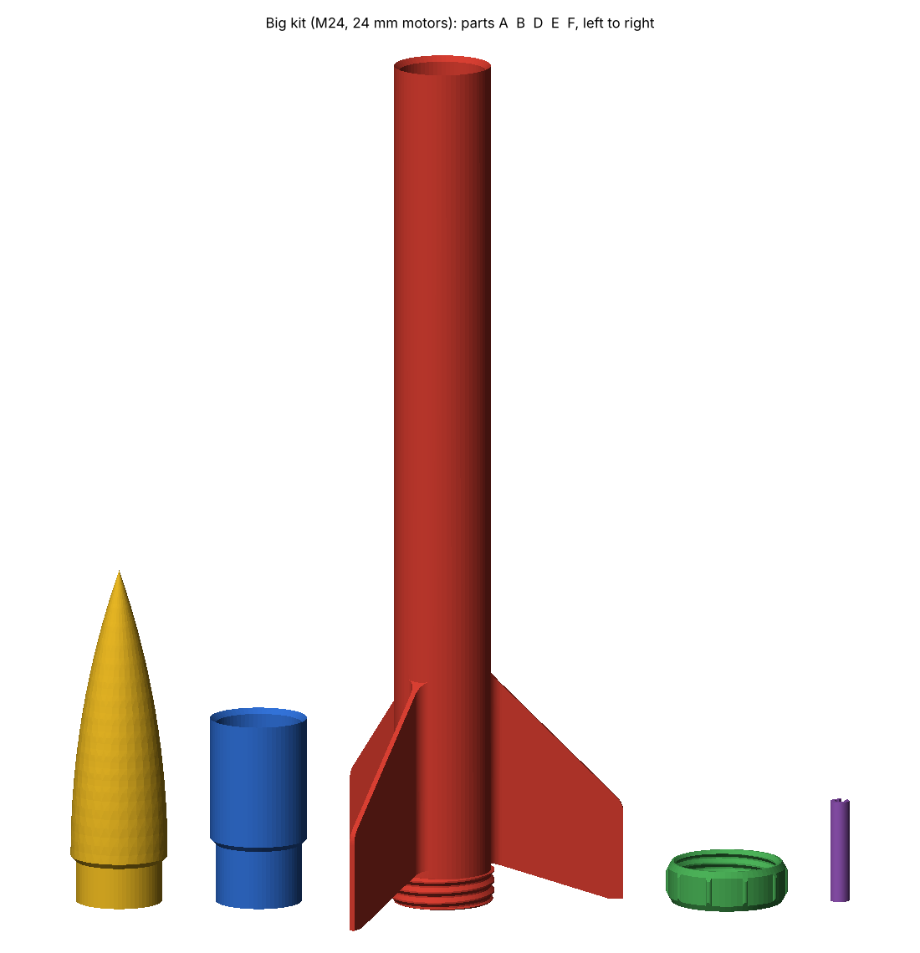
docs/kits/test-prints/big-m24/preview.png
