the-feve/rocket-builder-web/docs/kits/test-prints/mini-m13/preview.png

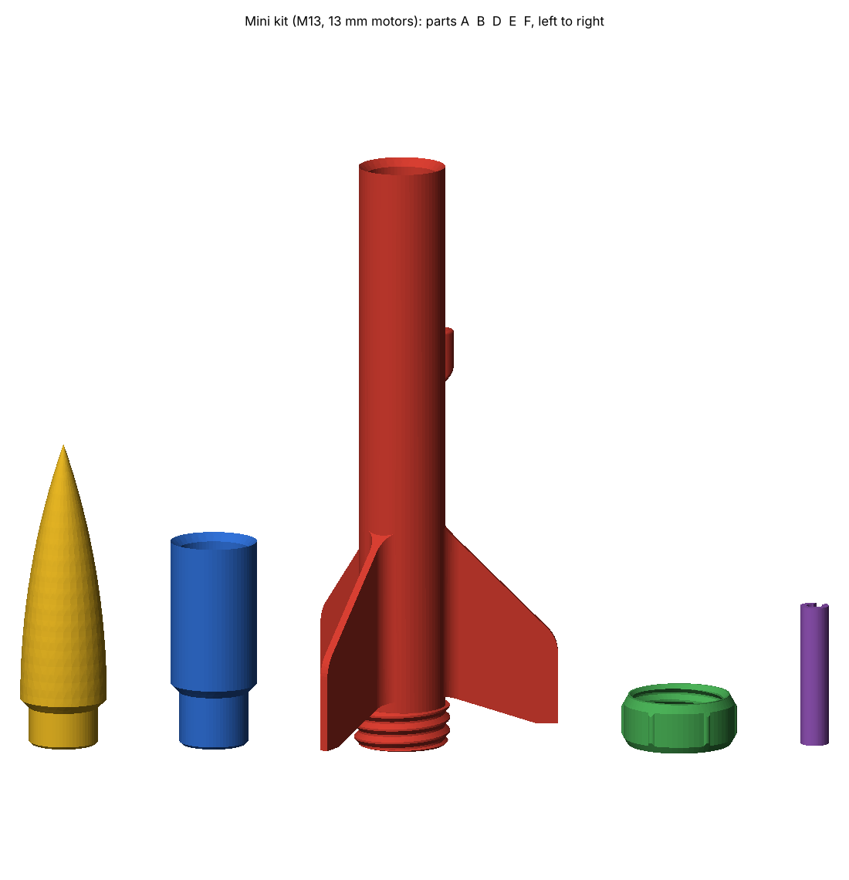
docs/kits/test-prints/mini-m13/preview.png
