the-feve/rocket-builder-web/docs/kits/test-prints/starter-m18/preview.png

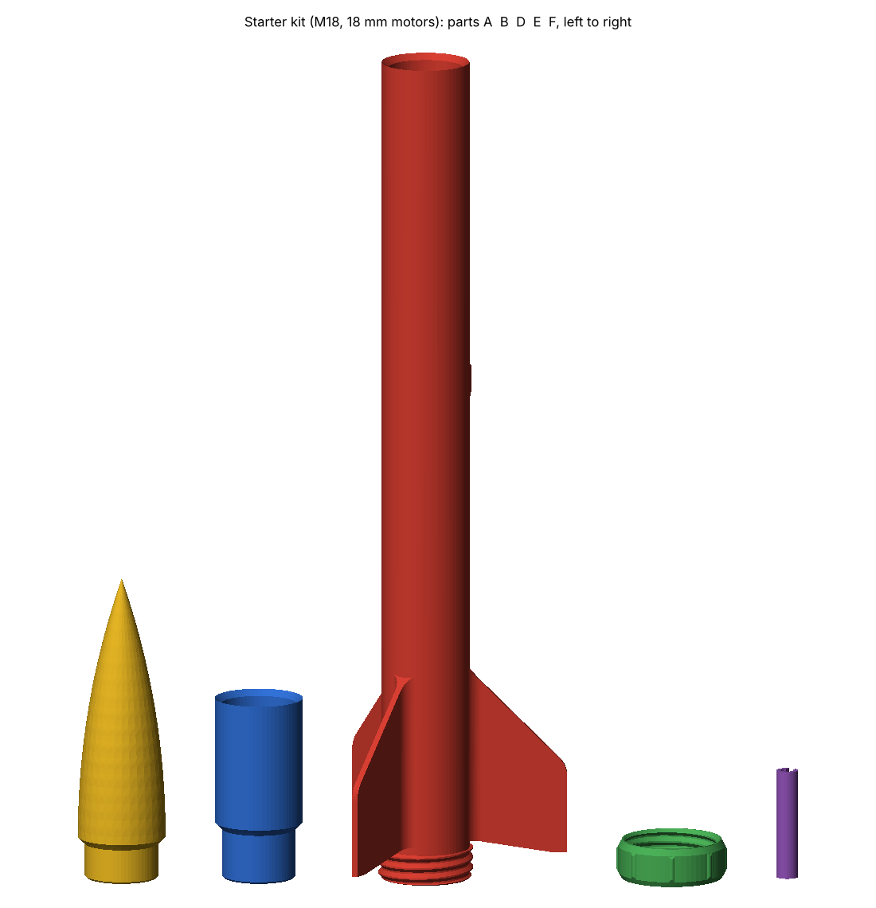
docs/kits/test-prints/starter-m18/preview.png
