the-feve/rocket-builder-web/docs/curriculum/preview-w3-swing-test.png

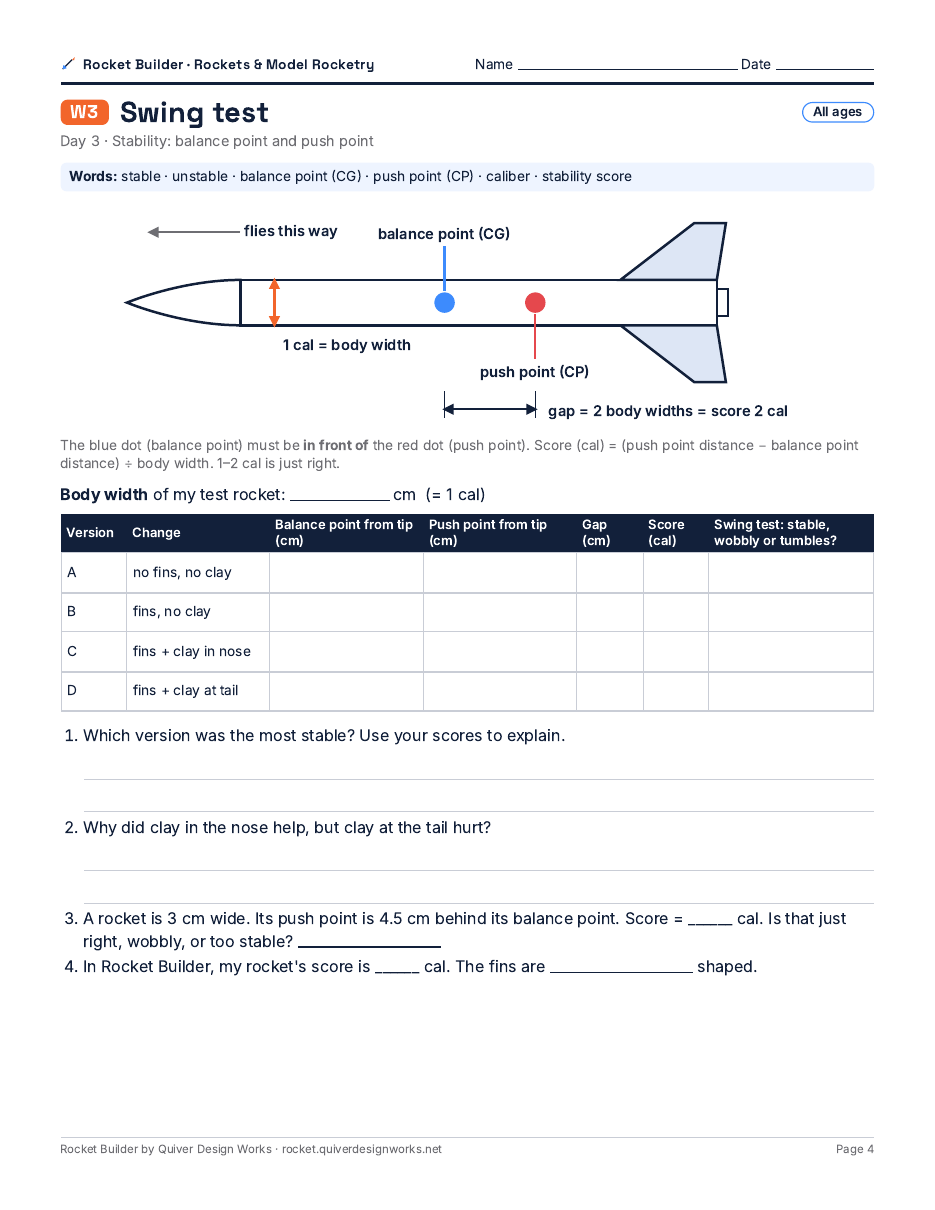
docs/curriculum/preview-w3-swing-test.png
