the-feve/rocket-builder-web/server/app.py

"""The designer website: one page, one FastAPI server, synchronous builds.

    cd server && uvicorn app:app --reload        # then open http://127.0.0.1:8000

POST /api/build builds a rocket with rocketgen and caches the geometry under
a hash of the geometry parameters; the stability check (motor and recovery
masses) is cheap and is redone per request. The page then loads the GLB
preview and offers the ZIP of print-oriented STLs, unless the rocket is
unstable. Designs are saved in SQLite (designs.py) and shared by link.
"""

from __future__ import annotations

import hashlib
import io
import json
import logging
import os
import tempfile
import threading
import time
import zipfile
from functools import lru_cache
from collections import OrderedDict, defaultdict, deque
from pathlib import Path

import numpy as np
import trimesh
from fastapi import Cookie, FastAPI, Header, HTTPException, Request
from fastapi.responses import FileResponse, HTMLResponse, JSONResponse, RedirectResponse, Response
from fastapi.staticfiles import StaticFiles
from pydantic import BaseModel, Field

from build123d import export_step, export_stl
from rocketgen.export import PART_COLORS
from rocketgen.fins import FinShape, fin_dimensions
from rocketgen.geom import GeometryError
from rocketgen.params import (LUG_OPTIONS, MATERIALS, NOSE_SHAPES, SHORT_NOSE_SHOULDER, WEB_FIT_JOINT, WEB_FIT_JOINT_SHORT,
                             WEB_FIT_NOSE, WEB_FIT_NOSE_SHORT, DesignParams, compute_derived, load_motors)
from rocketgen.flight import (CHUTE_SIZES_IN, FIELD_M, MAX_WIND_MPH, MPH, field_size, heaviest, launch_profile,
                              motors_for, parachute, pick, simulate)
from rocketgen.build import body_length_for, height_ranges, min_printer_height, overall_length
from rocketgen.stability import MAX_FIN_SCALE, Balance, advice, build_stable, recovery_allowance_g

import accounts
import designs
import notify
import orders
import shop
import supplies
import terms
import fit_mount
import trebuchet_mount

STATIC = Path(__file__).resolve().parent / "static"
GENERATOR_VERSION = "0.2.0"
SCHEMA_VERSION = 1
MAX_CACHED = 40  # geometry builds kept in memory


class BuildRequest(BaseModel):
    """The design form. Bounds are the FeatureScript dialog's."""

    motor: str = "M18"
    fin_shape: FinShape = FinShape.CLIPPED_DELTA
    fin_count: int = Field(3, ge=3, le=5)
    fin_thickness: float = Field(1.5, ge=0.4, le=12)
    fin_fillet: float = Field(3.5, ge=0, le=20)
    fin_fillet_upper: float = Field(1.0, ge=0, le=10)
    fin_tip_radius: float = Field(6.5, ge=0, le=50)
    custom_fin_size: bool = False
    fin_root_chord: float = Field(40.0, ge=5, le=500)
    fin_span: float = Field(20.0, ge=3, le=300)
    fin_tip_chord: float = Field(20.0, ge=1, le=500)
    fin_sweep: float = Field(20.0, ge=0, le=500)
    nose_shape: str = "tangent_ogive"
    nose_fineness: float = Field(3.0, ge=2, le=5)
    body_length: float = Field(250.0, ge=50, le=2000)
    # Beginner mode: the overall height (nose tip to fin tips / motor cap);
    # when set, body_length is worked out from it and the typed one ignored.
    overall_length: float | None = Field(None, ge=80, le=2500)
    body_od_override: float | None = Field(None, ge=5, le=200)
    # The form's "Body OD offset": radial mm added to the motor's stock tube
    # (5 = 10 mm more diameter). When > 0 it sets body_od_override.
    body_od_offset: float = Field(0.0, ge=0, le=80)
    # Wall thickness of the body tubes, nose cone and motor mount. A thicker
    # wall around the same motor bay makes the stock tube bigger.
    wall: float = Field(1.5, ge=0.8, le=3.0)
    print_max_height: float = Field(200.0, ge=50, le=500)
    launch_lugs: str = "two"
    rod_diameter: float = Field(3.175, ge=2, le=13)
    rod_standoff: bool = True
    pad_clearance: float = Field(15.0, ge=0, le=100)
    forward_lug_frac: float = Field(0.5, ge=0.2, le=0.95)
    material: str = "PLA"
    # Flight: not geometry. flight_motor None = the heaviest motor of the size;
    # recovery_mass_g None = the default allowance.
    flight_motor: str | None = None
    recovery_mass_g: float | None = Field(None, ge=0, le=500)
    target_altitude_m: float = Field(150.0, ge=10, le=3000)
    drag_cd: float = Field(0.65, ge=0.2, le=1.5)
    launch_rod_m: float = Field(0.91, ge=0.3, le=3)
    # Critical fit dimensions (Advanced; blank = Rocket Builder's computed
    # value). For typing in a result from a fit-test print.
    joint_clearance: float | None = Field(None, ge=0, le=0.5)
    nose_clearance: float | None = Field(None, ge=0, le=0.5)
    shoulder_len: float | None = Field(None, ge=5, le=100)
    nose_shoulder_len: float | None = Field(None, ge=4, le=100)
    thread_clearance: float | None = Field(None, ge=0.05, le=1.0)
    thread_pitch: float | None = Field(None, ge=1.5, le=5)
    thread_turns: int | None = Field(None, ge=2, le=6)


BEGINNER_FINS = ["swept", "delta", "trapezoid"]

# Form fields the geometry engine doesn't take (turned into ones it does).
NOT_GEOMETRY = ("overall_length", "body_od_offset")


def stock_od(motor: str, wall: float | None = None) -> float:
    """The minimum-diameter body for a motor size and wall (no OD override)."""
    return compute_derived(DesignParams(motor=motor, wall=wall)).body_od


def resolved_od(motor: str, offset: float, override: float | None, wall: float | None = None) -> float | None:
    """body_od_override from the form: the offset wins; an older saved design
    may carry only an override."""
    return stock_od(motor, wall) + 2 * offset if offset else override


FLIGHT_FIELDS = ("flight_motor", "recovery_mass_g", "target_altitude_m", "drag_cd", "launch_rod_m")


log = logging.getLogger("rocketbuilder")
logging.basicConfig(level=logging.INFO, format="%(asctime)s %(levelname)s %(name)s: %(message)s")

# Public-internet guards. A build holds the one OpenCascade lock for 5-10 s,
# so a visitor waits at most BUILD_WAIT_S for their turn, and each address
# gets a budget of new (uncached) builds and saves.
BUILD_WAIT_S = float(os.environ.get("ROCKETGEN_BUILD_WAIT_S", 60))
BUILDS_PER_10_MIN = int(os.environ.get("ROCKETGEN_BUILDS_PER_10_MIN", 30))
SAVES_PER_HOUR = int(os.environ.get("ROCKETGEN_SAVES_PER_HOUR", 60))
AUTH_PER_10_MIN = int(os.environ.get("ROCKETGEN_AUTH_PER_10_MIN", 20))  # sign-up / sign-in attempts per address
ORDERS_PER_DAY = int(os.environ.get("ROCKETGEN_ORDERS_PER_DAY", 10))
# "Order Rocket Supplies": the Amazon affiliate gear list, served here at /ordersupplies (supplies.py).
SUPPLIES_URL = os.environ.get("ROCKETGEN_SUPPLIES_URL", "/ordersupplies")
# Who can see every order: signed-in accounts with these emails, or the PC sync with this token.
ADMIN_EMAILS = {e.strip().lower() for e in os.environ.get("ROCKETGEN_ADMIN_EMAILS", "").split(",") if e.strip()}
# Printed-rocket ordering is closed to the public until the owner opens it:
# `fly secrets set ROCKETGEN_ORDERING=open`. While closed, only admin accounts
# (ROCKETGEN_ADMIN_EMAILS) can order, coupon or paid, so the whole flow can be
# tested end to end; everyone else sees "coming soon".
ORDERING_OPEN = os.environ.get("ROCKETGEN_ORDERING", "closed").strip().lower() == "open"


def can_order(user: dict | None) -> bool:
    return ORDERING_OPEN or bool(user and user["email"] in ADMIN_EMAILS)


def user_json(user: dict) -> dict:
    # is_admin: the page shows this owner links to the order desk (quiverdesignworks.net) and /admin.
    return {"email": user["email"], "prefs": user["prefs"], "can_order": can_order(user),
            "is_admin": user["email"] in ADMIN_EMAILS}
SYNC_TOKEN = os.environ.get("ROCKETGEN_SYNC_TOKEN", "")

app = FastAPI(title="Rocket Builder")
_hits: dict[tuple[str, str], deque] = defaultdict(deque)


def _client(request: Request) -> str:
    # Behind Cloudflare and Fly's proxy the socket address is the proxy's.
    h = request.headers
    return h.get("cf-connecting-ip") or h.get("fly-client-ip") or (request.client.host if request.client else "?")


def _rate_limit(request: Request, kind: str, limit: int, window_s: float):
    now = time.monotonic()
    q = _hits[(kind, _client(request))]
    while q and now - q[0] > window_s:
        q.popleft()
    if len(q) >= limit:
        raise HTTPException(429, "Too many requests from your address; wait a few minutes and try again.")
    q.append(now)
_geo: OrderedDict[str, dict] = OrderedDict()  # geometry key -> {"rocket", "glb", "report", "stls", "steps"}
_builds: dict[str, dict] = {}  # build id -> {"geo", "params", "stability"}
_lock = threading.Lock()  # one OpenCascade build at a time


def _report(rocket) -> dict:
    d, t = rocket.derived, rocket.derived.thread
    masses = rocket.mass_g()
    parts = [{"name": p.name, "color": PART_COLORS[i % len(PART_COLORS)], "volume_mm3": round(p.volume, 1),
              "mass_g": round(masses[p.name], 1),
              "height_mm": round(p.local.bounding_box().size.Z, 1),
              "width_mm": round(max(p.local.bounding_box().size.X, p.local.bounding_box().size.Y), 1)}
             for i, p in enumerate(rocket.parts)]
    return {
        "body_length_mm": round(rocket.params.body_length, 1),
        "parts": parts,
        "total_mass_g": round(sum(masses.values()), 1),
        "summary": rocket.summary(),
        "notes": list(rocket.notes),
        "dimensions": {
            "Body OD": d.body_od, "Body ID": d.body_id, "Motor bay ID": d.bay_id,
            "Inner motor mount": "yes" if d.has_mount else "no (minimum diameter)",
            "Shoulder OD": d.shoulder_od, "Shoulder length": d.shoulder_len,
            "Motor hang-out": t["hang"], "Thread pitch": t["p"], "Thread turns": t["turns"],
            "Body length": round(rocket.params.body_length, 1),
            "Body segments": len(rocket.seg_lens),
            "Fin span/sweep scale": rocket.params.fin_scale,
        },
    }


def _glb(rocket) -> bytes:
    scene = trimesh.Scene()
    for p in rocket.parts:  # the page colours parts by name
        verts, tris = p.assembled.tessellate(0.05, 0.2)
        mesh = trimesh.Trimesh(np.array([(v.X, v.Y, v.Z) for v in verts]), np.array(tris), process=False)
        scene.add_geometry(mesh, node_name=p.name, geom_name=p.name)
    return scene.export(file_type="glb")


def _stls(rocket) -> dict[str, bytes]:
    out = {}
    with tempfile.TemporaryDirectory() as tmp:
        for p in rocket.parts:
            path = Path(tmp) / f"{p.name}.stl"
            export_stl(p.local, path, tolerance=0.01, angular_tolerance=0.1)
            out[p.name] = terms.stl_with_header(path.read_bytes())  # licence notice in the STL header
    return out


def _steps(rocket) -> dict[str, bytes]:
    """One STEP per part, in the same print orientation as the STLs (Advanced:
    for editing in CAD; the STLs are what slicers want)."""
    out = {}
    with tempfile.TemporaryDirectory() as tmp:
        for p in rocket.parts:
            path = Path(tmp) / f"{p.name}.step"
            export_step(p.local, path)
            out[p.name] = terms.step_with_header(path.read_bytes())
    return out


def _stability(st) -> dict:
    return {"cg_mm": round(st.cg, 1), "cp_mm": round(st.cp, 1), "margin_cal": round(st.margin_cal, 2),
            "length_mm": round(st.length, 1), "liftoff_mass_g": round(st.total_mass_g, 1),
            "motor_mass_g": st.motor_mass_g, "motor": st.motor,
            "recovery_mass_g": st.recovery_mass_g, "status": st.status, "ok": st.ok, "message": st.message}


def _chute_text(c: dict) -> str:
    if c["size_in"]:
        return (f"Parachute: {c['size_in']} in (at least {c['min_diameter_in']:g} in): about {c['descent_ms']} m/s down "
                f"with {c['descent_mass_g']:g} g after the motor burns.")
    return f"Parachute: at least {c['min_diameter_in']:.0f} in for {c['descent_mass_g']:g} g (bigger than the usual hobby sizes)."


def _zip(stls: dict[str, bytes], report: dict, stab: dict, params: dict, flights: dict | None = None,
         chute: dict | None = None, field: dict | None = None, ext: str = "stl") -> bytes:
    buf = io.BytesIO()
    with zipfile.ZipFile(buf, "w", zipfile.ZIP_DEFLATED) as z:
        for name, data in stls.items():
            z.writestr(f"{name}.{ext}", data)
        lines = ["Rocket Builder build notes", "", terms.SHORT, "(See LICENSE.txt in this ZIP.)", "", report["summary"], ""]
        lines += [f"Note: {n}" for n in report["notes"]]
        lines += ["", "Stability (from the nose tip, mm):", f"  {stab['message']}",
                  f"  CG {stab['cg_mm']}, CP {stab['cp_mm']}, liftoff mass {stab['liftoff_mass_g']} g "
                  f"(motor {stab['motor_mass_g']} g, recovery {stab['recovery_mass_g']} g).",
                  "  Check it in OpenRocket with your actual motor, recovery and paint before flying.",
                  "  Follow the NAR Model Rocket Safety Code."]
        if chute:
            lines += ["", _chute_text(chute)]
        if field:
            lines += [f"Launch field: at least {field['recommended_m']} m ({round(field['recommended_m'] * 3.281)} ft) on a side "
                      f"with a {field['motor']} (NAR minimum {field['nar_min_m']} m; drifts about {field['drift_m']} m "
                      f"downwind under the parachute from {field['apogee_m']} m in a 10 mph breeze)."]
        if flights:
            lines += ["", f"Motors (target {flights['target_m']:g} m; recommended: {flights['recommended'] or 'none'}):"]
            lines += [f"  {r['motor']}: {r['apogee_m']} m, {r['margin_cal']} cal, "
                      + ("OK" if not r["problems"] else ", ".join(r["problems"])) for r in flights["rows"]]
        lines += ["", f"Parts ({ext.upper()}s are in print orientation, resting on z = 0):"]
        lines += [f"  {p['name']}: {p['mass_g']} g, {p['height_mm']} mm tall" for p in report["parts"]]
        lines += ["", "Key dimensions (mm):"]
        lines += [f"  {k}: {round(v, 2) if isinstance(v, float) else v}" for k, v in report["dimensions"].items()]
        z.writestr("build_notes.txt", "\n".join(lines) + "\n")
        z.writestr("LICENSE.txt", terms.LICENSE_TEXT)
        z.writestr("design.json", json.dumps({"generatorVersion": GENERATOR_VERSION, "schemaVersion": SCHEMA_VERSION,
                                              "license": terms.SHORT, "params": params}, indent=2))
    return buf.getvalue()


@app.get("/api/options")
def options():
    return {
        "supplies_url": SUPPLIES_URL,
        "ordering_open": ORDERING_OPEN,  # false: printed rockets show as "coming soon" (admins can still order)
        "motor_links": supplies.motor_links(),  # motor (e.g. "B4-4") -> Amazon packs, for "Get these motors"
        "motors": sorted(load_motors()),
        "fin_shapes": [s.value for s in FinShape],
        "nose_shapes": list(NOSE_SHAPES),
        "launch_lugs": list(LUG_OPTIONS),
        "materials": list(MATERIALS),
        "defaults": BuildRequest().model_dump(mode="json"),
        "stock_od": {m: round(stock_od(m), 2) for m in load_motors()},  # at the default wall
        "bay_id": {m: round(compute_derived(DesignParams(motor=m)).bay_id, 3) for m in load_motors()},  # stock OD = bay + 2 x wall
        # What a blank critical-dimension field means (the Advanced placeholders).
        # Clearances from the fit-test prints; short nose shoulders (M13) get the short pair.
        "fit_defaults": {"joint_clearance": WEB_FIT_JOINT, "nose_clearance": WEB_FIT_NOSE,
                         "joint_clearance_short": WEB_FIT_JOINT_SHORT, "nose_clearance_short": WEB_FIT_NOSE_SHORT,
                         "short_nose_shoulder": SHORT_NOSE_SHOULDER, "thread_clearance": 0.25, "thread_turns": 3},
        # Beginner mode: motor, printer height, overall height, nose shape and
        # one of three standard fin shapes; everything else stays at defaults.
        "beginner": {"fin_shapes": BEGINNER_FINS, "fin_shape": BEGINNER_FINS[2],
                     "overall_length": round(overall_length(DesignParams(fin_shape=FinShape(BEGINNER_FINS[2]))))},
        "flight_motors": {size: [{"code": m.code, "cls": m.cls, "mass_g": m.mass_g, "out_of_production": m.out_of_production}
                                 for m in motors_for(size)] for size in load_motors()},
    }


@lru_cache(maxsize=256)
def _heights(motor: str, print_max_height: int, fin_shape: str, nose_shape: str) -> dict:
    p = DesignParams(motor=motor, print_max_height=print_max_height, fin_shape=FinShape(fin_shape), nose_shape=nose_shape)
    k = (1.0, MAX_FIN_SCALE)  # Beginner fins auto-size anywhere in this range
    return {"ranges": height_ranges(p, fin_scales=k), "printer_min": min_printer_height(p, fin_scales=k)}


@app.get("/api/heights")
def heights(motor: str = "M18", print_max_height: int = 200, fin_shape: str = BEGINNER_FINS[2],
            nose_shape: str = "tangent_ogive"):
    """Beginner mode: the overall heights (whole mm) that build with this
    motor, printer and fin/nose shape, as [first, last] ranges, and the
    lowest printer height that builds anything. The page snaps the height
    (and printer) to the nearest one that works, so Build never fails on
    segment sizes, and the rocket comes out the height asked for whatever
    size the fins grow to. Plan checks only: no solids, under a second, cached."""
    if motor not in load_motors():
        raise HTTPException(422, f"Unknown motor {motor!r}.")
    if fin_shape not in {s.value for s in FinShape} or nose_shape not in NOSE_SHAPES:
        raise HTTPException(422, "Unknown fin or nose shape.")
    if not 50 <= print_max_height <= 500:
        raise HTTPException(422, "Printer max height must be 50 to 500 mm.")
    return _heights(motor, print_max_height, fin_shape, nose_shape)


@app.get("/api/recovery_allowance")
def recovery_allowance(motor: str = "M18", body_od_override: float | None = None, body_od_offset: float = 0.0,
                       wall: float | None = None):
    """The default recovery mass for the form's placeholder."""
    if motor not in load_motors():
        raise HTTPException(422, f"Unknown motor {motor!r}.")
    d = compute_derived(DesignParams(motor=motor, wall=wall,
                                     body_od_override=resolved_od(motor, body_od_offset, body_od_override, wall)))
    return {"recovery_mass_g": recovery_allowance_g(d.body_od)}


def _key(*parts) -> str:
    return hashlib.sha256(json.dumps([GENERATOR_VERSION, *parts], sort_keys=True).encode()).hexdigest()[:16]


def _build_to_length(params: DesignParams, overall: float | None):
    """build_stable, sized to an overall height when one is given. Auto-sized
    fins can change how far the fin tips trail below the tail, so when they
    do, rebuild at the corrected body length, starting from the fin scale
    already found. The shorter body can need bigger fins again, so repeat
    until the height settles (fins only grow, up to MAX_FIN_SCALE; usually
    one or two rounds)."""
    if overall is None:
        return build_stable(params)
    rocket = build_stable(params.with_(body_length=body_length_for(params, overall)))
    for _ in range(4):
        if abs(Balance(rocket).length - overall) <= 0.5:
            break
        p = rocket.params
        try:
            rocket = build_stable(p.with_(body_length=body_length_for(p, overall)))
        except GeometryError:
            # The corrected (shorter) body leaves the aft segment too short
            # for the motor bay. /api/heights keeps Beginner heights clear of
            # this; for a height typed past it, keep the last build (taller
            # than asked, as the report shows) rather than fail.
            break
    return rocket


def _geometry(geo_params: dict, req: BuildRequest, request: Request) -> str:
    key = _key(geo_params)
    try:
        _geo.move_to_end(key)  # cached: no lock, no rate limit
        return key
    except KeyError:
        pass
    _rate_limit(request, "build", BUILDS_PER_10_MIN, 600)
    if not _lock.acquire(timeout=BUILD_WAIT_S):
        raise HTTPException(503, "The builder is busy with other rockets; try again in a minute.")
    try:
        if key in _geo:  # built by another request while this one waited
            return key
        t0 = time.monotonic()
        try:
            rocket = _build_to_length(DesignParams(**{**{k: v for k, v in geo_params.items() if k not in NOT_GEOMETRY},
                                                     "fin_shape": req.fin_shape}), req.overall_length)
        except (GeometryError, ValueError) as ex:
            raise HTTPException(422, str(ex))
        except Exception as ex:  # an OpenCascade failure: never a bare 500
            log.exception("build failed: %s", json.dumps(geo_params, sort_keys=True))
            raise HTTPException(422, f"The geometry engine could not build this design ({type(ex).__name__}). "
                                     "Try slightly different settings.")
        _geo[key] = {"rocket": rocket, "balance": Balance(rocket), "glb": _glb(rocket), "report": _report(rocket), "stls": None, "steps": None}
        while len(_geo) > MAX_CACHED:
            _geo.popitem(last=False)
        log.info("built %s in %.1f s (fin scale %s)", key, time.monotonic() - t0, rocket.params.fin_scale)
    finally:
        _lock.release()
    return key


@app.post("/api/build")
def build(req: BuildRequest, request: Request):
    params = req.model_dump(mode="json")
    if req.motor not in load_motors():
        raise HTTPException(422, f"Unknown motor {req.motor!r}.")
    if req.material not in MATERIALS:
        raise HTTPException(422, f"Unknown material {req.material!r}.")
    motors = {m.code: m for m in motors_for(req.motor)}
    if req.flight_motor is not None and req.flight_motor not in motors:
        raise HTTPException(422, f"{req.flight_motor} doesn't fit the {req.motor} motor bay.")
    od = resolved_od(req.motor, req.body_od_offset, req.body_od_override, req.wall)
    if od is not None and od > 200:
        raise HTTPException(422, f"That offset makes the body {od:.0f} mm across; the most is 200 mm.")
    geo_params = {k: v for k, v in params.items() if k not in FLIGHT_FIELDS}
    geo_params["body_od_override"] = od
    geo = _geometry(geo_params, req, request)
    bal: Balance = _geo[geo]["balance"]
    chk = bal.check(motors.get(req.flight_motor), req.recovery_mass_g)
    st = _stability(chk)
    # Outside the 1-2 cal sweet spot: what to change, with predicted scores.
    st["advice"] = advice(bal, chk, list(motors.values()), beginner=req.overall_length is not None,
                          motor=motors.get(req.flight_motor), stock_od=stock_od(req.motor, req.wall))
    flights = _flights(bal, list(motors.values()), req)
    # Parachute for the rocket after the motor has burned: the recommended
    # motor's empty casing (else the chosen or heaviest motor's).
    m = motors.get(flights["recommended"]) or motors.get(req.flight_motor) or heaviest(req.motor)
    chute = parachute(bal.printed_mass_g + st["recovery_mass_g"] + m.mass_g - m.prop_g)
    chute["links"] = supplies.parachute_links().get(chute["size_in"], [])
    best = next((r for r in flights["rows"] if r["code"] == flights["recommended"]), None)
    field = field_size(best["cls"], best["apogee_m"], chute["descent_ms"]) if best else None
    if field:
        field["motor"] = best["motor"]
    build_id = _key(params)
    _builds[build_id] = {"geo": geo, "params": params, "stability": st, "flights": flights, "parachute": chute, "field": field}
    return {"id": build_id, **_geo[geo]["report"], "stability": st, "flights": flights, "parachute": chute, "field": field}


def _flights(bal: Balance, motors: list, req: BuildRequest) -> dict:
    """The motor picker: every motor of the bay size flown, each with its own
    stability margin; the safe, stable one closest to the target altitude."""
    rec = recovery_allowance_g(bal.body_od) if req.recovery_mass_g is None else req.recovery_mass_g
    rows, safe = [], []
    for m in motors:
        f = simulate(m, bal.printed_mass_g + rec, bal.body_od, req.drag_cd, req.launch_rod_m)
        st = bal.check(m, req.recovery_mass_g)
        problems = list(f.problems) + ([] if st.ok else ["Unstable"])
        if not problems:
            safe.append(f)
        rows.append({"motor": f"{m.code}-{f.delay}", "code": m.code, "cls": m.cls, "apogee_m": round(f.apogee),
                     "rod_speed_ms": round(f.rod_speed, 1), "thrust_to_weight": round(f.thrust_to_weight, 1),
                     "coast_s": round(f.coast, 1), "delay_s": f.delay, "margin_cal": round(st.margin_cal, 2),
                     "liftoff_g": round(st.total_mass_g), "field_m": FIELD_M[m.cls], "problems": problems,
                     "out_of_production": m.out_of_production, "mass_estimated": m.mass_estimated})
    best = pick(safe, req.target_altitude_m)
    return {"target_m": req.target_altitude_m, "rows": rows, "recommended": best and best.motor.code}


def _get(build_id: str) -> tuple[dict, dict]:
    b = _builds.get(build_id)
    if not b or b["geo"] not in _geo:
        raise HTTPException(404, "Build not found; press Build again.")
    return b, _geo[b["geo"]]


@app.get("/api/builds/{build_id}/launch")
def launch(build_id: str, request: Request, wind_mph: float = 10.0, motor: str | None = None, delay: int | None = None):
    """A simulated flight for the launch page: liftoff, ejection, the
    parachute ride down in this much wind, and the field it needs."""
    _rate_limit(request, "launch", 120, 600)
    if not 0 <= wind_mph <= 30:
        raise HTTPException(422, "Wind speed must be between 0 and 30 mph.")
    b, g = _get(build_id)
    p, bal = b["params"], g["balance"]
    motors = {m.code: m for m in motors_for(p["motor"])}
    rows = b["flights"]["rows"]
    # With no safe motor, fly the closest one anyway: the page shows why it's unsafe.
    closest = min(rows, key=lambda r: (len(r["problems"]), -r["thrust_to_weight"]))["code"] if rows else None
    code = motor or b["flights"]["recommended"] or p.get("flight_motor") or closest
    m = motors.get(code) if code else None
    if m is None:
        raise HTTPException(422, "Pick a motor from the motor list.")
    if delay is not None and delay not in m.delays:
        raise HTTPException(422, f"The {m.code} comes with delays of {', '.join(map(str, m.delays))} s.")
    rec = b["stability"]["recovery_mass_g"]
    chute = parachute(bal.printed_mass_g + rec + m.mass_g - m.prop_g)
    row = next((r for r in rows if r["code"] == m.code), None)
    margin = row["margin_cal"] if row else None
    out = launch_profile(m, bal.printed_mass_g + rec, bal.body_od, chute["size_in"] or max(CHUTE_SIZES_IN),
                         wind_mph * MPH, delay, p["drag_cd"], p["launch_rod_m"], margin_cal=margin, length_mm=bal.length)
    unsafe = bool(not row or row["problems"] or any(d["level"] == "danger" for d in out["dangers"]))
    out.update(wind_mph=wind_mph, max_wind_mph=MAX_WIND_MPH, motors=[
        {"code": r["code"], "delays": list(motors[r["code"]].delays), "ok": not r["problems"], "problems": r["problems"]}
        for r in rows], recommended=b["flights"]["recommended"], safe=not unsafe, margin_cal=margin,
        problems=row["problems"] if row else [], parachute=chute, shape=_shape(bal))
    return out


def _shape(bal: Balance) -> dict:
    """Side-view proportions for the launch page's drawing (mm): overall length,
    body diameter, nose length, fin planform and count."""
    q, fin = bal.params, fin_dimensions(bal.params, bal.cal)
    return {"length_mm": round(bal.length, 1), "od_mm": round(bal.body_od, 1),
            "nose_mm": round(q.nose_fineness * bal.cal, 1), "nose_shape": q.nose_shape, "fin_count": q.fin_count,
            "fin": {k: round(getattr(fin, k), 1) for k in ("root", "span", "tip", "sweep")}}


@app.get("/api/builds/{build_id}/preview.glb")
def preview(build_id: str):
    return Response(_get(build_id)[1]["glb"], media_type="model/gltf-binary")


@app.get("/api/builds/{build_id}/rocket.zip")
def download(build_id: str):
    b, g = _get(build_id)
    if not b["stability"]["ok"]:
        raise HTTPException(409, b["stability"]["message"])
    if g["stls"] is None:
        with _lock:
            g["stls"] = _stls(g["rocket"])
    return Response(_zip(g["stls"], g["report"], b["stability"], b["params"], b["flights"], b.get("parachute"), b.get("field")), media_type="application/zip",
                    headers={"Content-Disposition": f'attachment; filename="rocket_{build_id}.zip"'})


@app.get("/api/builds/{build_id}/rocket_step.zip")
def download_step(build_id: str):
    """The same ZIP with one STEP per part instead of STLs."""
    b, g = _get(build_id)
    if not b["stability"]["ok"]:
        raise HTTPException(409, b["stability"]["message"])
    if g.get("steps") is None:
        with _lock:
            g["steps"] = _steps(g["rocket"])
    return Response(_zip(g["steps"], g["report"], b["stability"], b["params"], b["flights"], b.get("parachute"), b.get("field"),
                         ext="step"), media_type="application/zip",
                    headers={"Content-Disposition": f'attachment; filename="rocket_{build_id}_step.zip"'})


# ---------- saved designs and share links ----------

class DesignIn(BaseModel):
    name: str = Field("My rocket", min_length=1, max_length=80)
    params: BuildRequest


class DesignRename(BaseModel):
    name: str = Field(..., min_length=1, max_length=80)


# ---------- accounts ----------
SESSION_COOKIE = "rb_session"


class SignUp(BaseModel):
    email: str = Field(..., max_length=254)
    password: str = Field(..., max_length=200)
    # The site is used by children: accounts are for people 13+ or a parent /
    # guardian setting one up for their child (COPPA). The form asks for this.
    age_ok: bool = False


class SignIn(BaseModel):
    email: str = Field(..., max_length=254)
    password: str = Field(..., max_length=200)


class ClaimItem(BaseModel):
    id: str = Field(..., max_length=40)
    key: str = Field(..., max_length=80)


class Claim(BaseModel):
    items: list[ClaimItem] = Field(default_factory=list, max_length=500)


def current_user(request: Request) -> dict | None:
    return accounts.user_for_session(request.cookies.get(SESSION_COOKIE))


def _signed_in(user: dict, request: Request) -> JSONResponse:
    res = JSONResponse({"user": user_json(user)})
    https = request.headers.get("x-forwarded-proto", request.url.scheme) == "https"
    res.set_cookie(SESSION_COOKIE, accounts.new_session(user["id"]), max_age=accounts.SESSION_DAYS * 86400,
                   httponly=True, samesite="lax", secure=https, path="/")
    return res


@app.post("/api/auth/signup")
def signup(body: SignUp, request: Request):
    _rate_limit(request, "auth", AUTH_PER_10_MIN, 600)
    if not body.age_ok:
        raise HTTPException(400, "Accounts are for people 13 or older, or a parent or guardian setting one up for their child.")
    try:
        user = accounts.create_user(body.email, body.password)
    except accounts.AccountError as e:
        raise HTTPException(400, str(e)) from None
    return _signed_in(user, request)


@app.post("/api/auth/login")
def login(body: SignIn, request: Request):
    _rate_limit(request, "auth", AUTH_PER_10_MIN, 600)
    user = accounts.authenticate(body.email, body.password)
    if not user:
        raise HTTPException(401, "That email and password don't match an account.")
    return _signed_in(user, request)


@app.post("/api/auth/logout")
def logout(rb_session: str | None = Cookie(None)):
    accounts.end_session(rb_session)
    res = JSONResponse({"user": None})
    res.delete_cookie(SESSION_COOKIE, path="/")
    return res


@app.get("/api/auth/me")
def me(request: Request):
    user = current_user(request)
    return {"user": user_json(user) if user else None}


class Prefs(BaseModel):
    skip_tutorial: bool | None = None


@app.post("/api/my/prefs")
def my_prefs(body: Prefs, request: Request):
    """Account settings, e.g. skip the tutorial when signed in."""
    user = current_user(request)
    if not user:
        raise HTTPException(401, "Sign in first.")
    return {"prefs": accounts.set_prefs(user["id"], body.model_dump(exclude_none=True))}


@app.get("/api/my/designs")
def my_designs(request: Request):
    user = current_user(request)
    if not user:
        raise HTTPException(401, "Sign in to see your rockets.")
    return {"designs": [{"id": d["id"], "name": d["name"], "updated_at": d["updated_at"]} for d in designs.list_owned(user["id"])]}


@app.post("/api/my/claim")
def claim_designs(body: Claim, request: Request):
    """Moves designs saved in this browser (proved by their edit keys) into the account."""
    user = current_user(request)
    if not user:
        raise HTTPException(401, "Sign in first.")
    return {"claimed": sum(designs.claim(i.id, i.key, user["id"]) for i in body.items)}


# ---------- print orders ----------
class Shipping(BaseModel):
    name: str = Field(..., min_length=1, max_length=100)
    line1: str = Field(..., min_length=1, max_length=120)
    line2: str = Field("", max_length=120)
    city: str = Field(..., min_length=1, max_length=80)
    state: str = Field(..., min_length=1, max_length=40)
    zip: str = Field(..., min_length=3, max_length=12)
    country: str = Field("USA", max_length=60)
    phone: str = Field("", max_length=30)


class OrderIn(BaseModel):
    design_name: str = Field("My rocket", min_length=1, max_length=80)
    design_id: str | None = Field(None, max_length=40)
    params: BuildRequest
    quantity: int = Field(1, ge=1, le=5)
    color: str = Field("Any", max_length=40)
    shipping: Shipping | None = None  # coupon orders; paid orders give it to Stripe
    notes: str = Field("", max_length=1000)
    coupon: str = Field("", max_length=40)


def _print_quote(build_id: str, quantity: int) -> dict:
    b, g = _get(build_id)
    return shop.quote(g["report"]["parts"], g["report"]["total_mass_g"], quantity)


@app.get("/api/orders/quote")
def order_quote(build_id: str, quantity: int = 1):
    """Price, box and shipping estimate for printing a built rocket (from
    shop.json; tax is added by Stripe at checkout)."""
    if not 1 <= quantity <= 5:
        raise HTTPException(422, "Quantity must be 1 to 5.")
    return _print_quote(build_id, quantity)


PUBLIC_URL = os.environ.get("ROCKETGEN_PUBLIC_URL", "").rstrip("/")


@app.post("/api/orders")
def place_order(o: OrderIn, request: Request):
    """Order a printed copy of the rocket. Builds it (or reuses the cached
    build) and saves the order folder. With a valid coupon the order is free
    and placed now (address from the form). Otherwise it waits for payment:
    the reply carries a Stripe Checkout URL, and the webhook marks it paid."""
    user = current_user(request)
    if not user:
        raise HTTPException(401, "Sign in (or create an account) to order a printed rocket.")
    if not can_order(user):
        raise HTTPException(403, "Printed rockets are coming soon. You can download the files and print it yourself now.")
    free = bool(o.coupon.strip())
    if free and not orders.coupon_ok(o.coupon):
        raise HTTPException(402, "That coupon code isn't valid.")
    if free and not o.shipping:
        raise HTTPException(422, "Fill in the shipping address.")
    if not free and not shop.enabled():
        raise HTTPException(402, "Paid printing isn't switched on yet. For now, orders need a coupon code.")
    _rate_limit(request, "order", ORDERS_PER_DAY, 86400)
    res = build(o.params, request)
    b, g = _get(res["id"])
    if not b["stability"]["ok"]:
        raise HTTPException(409, "This rocket isn't stable yet, so it can't be printed. " + b["stability"]["message"])
    q = _print_quote(res["id"], o.quantity)
    if g["stls"] is None:
        with _lock:
            g["stls"] = _stls(g["rocket"])
    rocket_zip = _zip(g["stls"], g["report"], b["stability"], b["params"], b["flights"], b.get("parachute"), b.get("field"))
    pending = {"name": "(given at checkout)", "line1": "", "line2": "", "city": "", "state": "", "zip": "", "phone": ""}
    order = orders.create(user=user, design_name=o.design_name, design_id=o.design_id, params=b["params"],
                          quantity=o.quantity, material=o.params.material, color=o.color,
                          shipping=o.shipping.model_dump() if free else pending, notes=o.notes,
                          coupon=o.coupon if free else None, price=0.0 if free else q["subtotal_cents"] / 100,
                          rocket_zip=rocket_zip, parts=g["report"]["parts"], stability=b["stability"],
                          recommended_motor=b["flights"]["recommended"],
                          status="new" if free else "awaiting_payment", package=q["package"])
    if free:
        _order_alert(order, request)
        return {"id": order["id"], "name": order["name"], "status": order["status"], "price": order["price"]}
    origin = PUBLIC_URL or str(request.base_url).rstrip("/")
    try:
        session = shop.create_session(order, q, origin)
    except shop.StripeError as ex:
        log.error("checkout for %s failed: %s", order["name"], ex)
        orders.mark_expired(order["id"])
        raise HTTPException(502, "Checkout is unavailable right now. Please try again later.")
    log.info("order %s awaiting payment (%s)", order["name"], session.get("id"))
    return {"id": order["id"], "name": order["name"], "status": order["status"], "checkout_url": session["url"]}


def _order_alert(order: dict, request: Request) -> None:
    log.info("order %s from %s", order["name"], order["email"])
    paid = f" (paid ${order['paid']['total_cents'] / 100:.2f})" if order.get("paid") else " (coupon)"
    notify.owner(f"New rocket order {order['name']}: {order['design_name']} x{order['quantity']}{paid}",
                 orders._sheet(order) + f"\nFiles: {orders.folder(order)}\nOrders page: {PUBLIC_URL or request.base_url}/admin\n")


@app.post("/api/stripe-webhook")
async def stripe_webhook(request: Request):
    """Stripe tells us a checkout finished (paid) or expired. Only sessions
    tagged metadata.store = rocket-builder are ours; anything else on the
    shared account gets a 200 and is ignored."""
    secret = os.environ.get("STRIPE_WEBHOOK_SECRET", "")
    if not secret:
        raise HTTPException(503, "Webhook not configured.")
    payload = await request.body()
    try:
        event = shop.verify_webhook(payload, request.headers.get("stripe-signature", ""), secret)
    except ValueError as ex:
        raise HTTPException(400, str(ex))
    obj = (event.get("data") or {}).get("object") or {}
    meta = obj.get("metadata") or {}
    if meta.get(shop.STORE_KEY) != shop.STORE_ID or not meta.get("order_id"):
        return {"ignored": True}
    kind = event.get("type")
    if kind in ("checkout.session.completed", "checkout.session.async_payment_succeeded") and obj.get("payment_status") == "paid":
        order = orders.mark_paid(meta["order_id"], obj)
        if order:
            _order_alert(order, request)
    elif kind in ("checkout.session.expired", "checkout.session.async_payment_failed"):
        orders.mark_expired(meta["order_id"])
    return {"ok": True}


@app.get("/api/my/orders")
def my_orders(request: Request):
    user = current_user(request)
    if not user:
        raise HTTPException(401, "Sign in to see your orders.")
    return {"orders": [{k: o.get(k) for k in ("id", "name", "status", "created_at", "design_name", "quantity", "color", "material", "price")}
                       for o in orders.list_for_user(user["id"])]}


def _admin(request: Request) -> None:
    auth = request.headers.get("authorization", "")
    if SYNC_TOKEN and auth == f"Bearer {SYNC_TOKEN}":
        return
    user = current_user(request)
    if not (user and user["email"] in ADMIN_EMAILS):
        raise HTTPException(403, "Only the shop owner can see orders.")


class StatusIn(BaseModel):
    status: str


@app.get("/api/admin/orders")
def admin_orders(request: Request, since: float = 0, unpaid: bool = False):
    _admin(request)
    return {"orders": orders.list_all(since, unpaid), "now": time.time()}


@app.get("/api/admin/orders/{order_id}/files.zip")
def admin_order_files(order_id: str, request: Request):
    _admin(request)
    order = orders.get(order_id)
    if not order or not orders.folder(order).is_dir():
        raise HTTPException(404, "No such order (or its files are missing).")
    return Response(orders.folder_zip(order), media_type="application/zip",
                    headers={"Content-Disposition": f'attachment; filename="{order.get("name", order_id)}.zip"'})


@app.post("/api/admin/orders/{order_id}/status")
def admin_order_status(order_id: str, body: StatusIn, request: Request):
    _admin(request)
    try:
        order = orders.set_status(order_id, body.status)
    except ValueError as e:
        raise HTTPException(400, str(e)) from None
    if not order:
        raise HTTPException(404, "No such order.")
    return order


@app.get("/terms", response_class=HTMLResponse)
def terms_page():
    """The licence for generated files, as a page (linked from the download and order buttons)."""
    return HTMLResponse(terms.page(), headers=PAGE_HEADERS)


@app.get("/ordersupplies")
def order_supplies():
    """Launch pads, motors, recovery, filament and paint: Amazon affiliate links (server/gear.json)."""
    return HTMLResponse(supplies.page(), headers=PAGE_HEADERS)


@app.get("/sources")
def sources_page():
    """Sources and References: where each calculation and number comes from."""
    return FileResponse(STATIC / "sources.html", headers=PAGE_HEADERS)


@app.get("/launch")
def launch_page():
    """The launch simulation: liftoff, parachute, landing, field size (`/launch?build=<id>`)."""
    return FileResponse(STATIC / "launch.html", headers=PAGE_HEADERS)


# The rocketry lessons (docs/curriculum), as static pages generated by
# docs/curriculum/tools/build_site.py into static/learn/: a chooser, a teachers page and two
# tracks. Only these names are served, so a path can never leave that folder. Keep the lesson
# counts in step with TRACKS in build_site.py.
LEARN_TRACKS = {"elementary": 8, "middle": 9}
LEARN_PAGES = {track: {name: f"{track}/{name}.html" for name in
                       ["safety", "worksheets", *(f"lesson-{n:02d}" for n in range(1, count + 1))]}
               for track, count in LEARN_TRACKS.items()}
# The first (2026-10-18) unit's addresses: its ten days became the middle-school lessons.
LEARN_OLD = {**{f"day-{n:02d}": f"/learn/middle/lesson-{m:02d}"
                for n, m in zip(range(1, 11), (1, 2, 3, 4, 5, 6, 7, 8, 8, 9))},
             "safety": "/learn/middle/safety", "worksheets": "/learn/middle/worksheets",
             "worksheets.pdf": "/learn/middle/worksheets.pdf"}


@app.get("/learn", include_in_schema=False)
def learn_redirect():
    return RedirectResponse("/learn/", status_code=308)


@app.get("/learn/")
def learn_index():
    """Rockets and Model Rocketry: pick a track (grades 3–5 or 6–8) or the teachers page."""
    return FileResponse(STATIC / "learn" / "index.html", headers=PAGE_HEADERS)


@app.get("/learn/{page}")
def learn_page(page: str):
    """`teachers`, a track without its slash, or an old 10-day-unit address (redirected)."""
    name = page.removesuffix(".html")
    if name == "teachers":
        return FileResponse(STATIC / "learn" / "teachers.html", headers=PAGE_HEADERS)
    if name in LEARN_TRACKS:
        return RedirectResponse(f"/learn/{name}/", status_code=308)
    key = page if page.endswith(".pdf") else name
    target = LEARN_OLD.get(key) if key != "worksheets.pdf" or page == key else None
    if target:
        return RedirectResponse(target, status_code=301)
    raise HTTPException(404, "There's no lesson page with that name.")


@app.get("/learn/{track}/")
def learn_track_index(track: str):
    """One track's overview: lessons, standards map, materials."""
    if track not in LEARN_TRACKS:
        raise HTTPException(404, "There's no lesson page with that name.")
    return FileResponse(STATIC / "learn" / track / "index.html", headers=PAGE_HEADERS)


@app.get("/learn/{track}/{page}")
def learn_track_page(track: str, page: str):
    """A lesson (`lesson-01` …), `safety`, `worksheets` or `worksheets.pdf` of one track."""
    pages = LEARN_PAGES.get(track)
    if pages is None:
        raise HTTPException(404, "There's no lesson page with that name.")
    if page == "worksheets.pdf":
        return FileResponse(STATIC / "learn" / track / "worksheets.pdf", media_type="application/pdf",
                            filename=f"rocketry-worksheets-{track}.pdf", content_disposition_type="inline",
                            headers=PAGE_HEADERS)
    name = pages.get(page.removesuffix(".html"))
    if not name:
        raise HTTPException(404, "There's no lesson page with that name.")
    return FileResponse(STATIC / "learn" / name, headers=PAGE_HEADERS)


@app.get("/admin")
def admin_page():
    return FileResponse(STATIC / "admin.html", headers=PAGE_HEADERS)


# ---------- saved designs ----------
@app.post("/api/designs")
def save_design(d: DesignIn, request: Request):
    """A new saved design. The edit key comes back once; the page keeps it
    in this browser and sends it to rename or overwrite. Signed in, the
    design also belongs to the account, which can edit it from anywhere."""
    _rate_limit(request, "save", SAVES_PER_HOUR, 3600)
    user = current_user(request)
    return designs.create(d.name, d.params.model_dump(mode="json"), GENERATOR_VERSION, SCHEMA_VERSION,
                          owner=user["id"] if user else None)


@app.get("/api/designs/{design_id}")
def load_design(design_id: str):
    row = designs.get(design_id)
    if not row:
        raise HTTPException(404, "That design link doesn't exist.")
    return row


@app.put("/api/designs/{design_id}")
def update_design(design_id: str, d: DesignIn, request: Request, x_edit_key: str = Header("")):
    _owned(design_id, x_edit_key, request)
    return designs.update(design_id, d.name, d.params.model_dump(mode="json"), GENERATOR_VERSION, SCHEMA_VERSION)


@app.patch("/api/designs/{design_id}")
def rename_design(design_id: str, d: DesignRename, request: Request, x_edit_key: str = Header("")):
    _owned(design_id, x_edit_key, request)
    return designs.rename(design_id, d.name)


@app.delete("/api/designs/{design_id}")
def delete_design(design_id: str, request: Request, x_edit_key: str = Header("")):
    _owned(design_id, x_edit_key, request)
    designs.delete(design_id)
    return {"deleted": design_id}


def _owned(design_id: str, key: str, request: Request):
    """The edit key from the saving browser, or being signed in as the owner."""
    if not designs.get(design_id):
        raise HTTPException(404, "That design doesn't exist.")
    user = current_user(request)
    if user and designs.owner_of(design_id) == user["id"]:
        return
    if not designs.check_key(design_id, key):
        raise HTTPException(403, "This design was saved from another browser; use Save as new to keep a copy.")


@app.get("/healthz")
def healthz():
    """Fly's health check: the process is up and the designs database opens."""
    designs.get("healthz")
    return {"ok": True, "generatorVersion": GENERATOR_VERSION}


# The page changes with every deploy: make browsers (Safari especially) check
# for a new copy each time instead of showing a cached old one. "no-cache"
# still lets them reuse it when the ETag hasn't changed.
PAGE_HEADERS = {"Cache-Control": "no-cache"}


@app.get("/")
def index():
    return FileResponse(STATIC / "index.html", headers=PAGE_HEADERS)


@app.get("/d/{design_id}")
def shared(design_id: str):
    """A share link: the page loads the design and builds it."""
    return FileResponse(STATIC / "index.html", headers=PAGE_HEADERS)


app.mount("/static", StaticFiles(directory=STATIC), name="static")


# Trebuchet Builder shares this Fly app: /trebuchet/ and trebuchet.* hosts.
TREBUCHET = trebuchet_mount.load_app()
if TREBUCHET is not None:
    @app.get(trebuchet_mount.PREFIX, include_in_schema=False)
    def trebuchet_slash():
        return RedirectResponse(trebuchet_mount.PREFIX + "/")

    app.mount(trebuchet_mount.PREFIX, TREBUCHET, name="trebuchet")

# Fit Test Builder too: /fit/ and fit.* hosts. Public since 2026-10-18 (owner):
# linked from Rocket Builder (both modes) and quiverdesignworks.net's Apps.
# `fly secrets set ROCKETGEN_FIT=admin` limits it to admin accounts again.
FIT_ADMIN_ONLY = os.environ.get("ROCKETGEN_FIT", "").lower() == "admin"
FIT = fit_mount.load_module()
if FIT is not None:
    FIT._lock = _lock  # never a rocket and a coupon set building at once

    @FIT.app.middleware("http")
    async def fit_gate(request: Request, call_next):
        if FIT_ADMIN_ONLY:
            user = current_user(request)
            if not (user and user["email"] in ADMIN_EMAILS):
                return JSONResponse({"detail": "Not Found"}, status_code=404)
        return await call_next(request)

    @app.get(fit_mount.PREFIX, include_in_schema=False)
    def fit_slash():
        return RedirectResponse(fit_mount.PREFIX + "/")

    app.mount(fit_mount.PREFIX, FIT.app, name="fit")

app.add_middleware(trebuchet_mount.HostRouter, routes={"trebuchet.": trebuchet_mount.PREFIX, "fit.": fit_mount.PREFIX})
