the-feve/rocket-builder-web/server/terms.py

"""Licence for the files Rocket Builder generates (personal use only).

One place for the wording: LICENSE.txt in every ZIP and order folder, the
notice at the top of build_notes.txt, each STL's 80-byte header, the /terms
page and the short notes by the download and order buttons.
"""

from __future__ import annotations

from datetime import date

OWNER = "Quiver Design Works LLC"
TERMS_URL = "rocket.quiverdesignworks.net/terms"
YEAR = date.today().year

SHORT = (f"Personal use only. These files are licensed to you to print for yourself; don't share, sell or upload "
         f"them (or remixes) to MakerWorld, Printables, Thingiverse or any other site. Full terms: {TERMS_URL}")

# Binary STL header: 80 bytes, must not start with "solid" (that marks an ASCII STL).
STL_HEADER = f"(c){YEAR} QDW. Personal use only. No sharing. {TERMS_URL}".encode()[:80].ljust(80, b" ")

LICENSE_TEXT = f"""ROCKET BUILDER FILE LICENSE: PERSONAL USE ONLY

Copyright (c) {YEAR} {OWNER}. All rights reserved.

These files (the STL models, design.json, build notes and anything else
generated by Rocket Builder at rocket.quiverdesignworks.net) are licensed,
not sold, to the person who made them, for personal, non-commercial use.

You MAY:
  - Print the parts on your own 3D printer, or have them printed for you,
    to build and fly your own rockets.
  - Change the files for your own use.
  - Share photos and videos of your printed rocket. A link to
    rocket.quiverdesignworks.net is appreciated.

You may NOT:
  - Share, publish, upload or otherwise distribute these files, or any
    modified version, remix or derivative of them, whether free or paid.
    This includes 3D model sites and file-sharing services such as
    MakerWorld, Printables, Thingiverse, Thangs, Cults3D and MyMiniFactory,
    public Google Drive or Dropbox links, Discord, forums and social media.
  - Sell the files, or sell or rent printed parts or kits made from them,
    without written permission from {OWNER}.
  - Claim the designs as your own, or remove this notice.

These files are provided "as is", without warranty of any kind. Model
rocketry has risks: build and fly only under adult supervision, follow the
NAR Model Rocket Safety Code and local laws, and check your rocket's
stability yourself before flying. To the extent the law allows,
{OWNER} is not liable for any damage or injury arising from the
use of these files or the rockets built from them.

Questions or permission requests: https://quiverdesignworks.net/#contact
Full terms: https://{TERMS_URL}
"""


def step_with_header(data: bytes) -> bytes:
    """A STEP file with the licence notice as a comment after its first line
    (ISO 10303-21 allows /* comments */ between entities)."""
    head, sep, rest = data.partition(b"\n")
    note = SHORT.replace("*/", "* /").encode()
    return head + sep + b"/* " + note + b" */\n" + rest if sep else data


def stl_with_header(data: bytes) -> bytes:
    """A binary STL with the licence notice in its 80-byte header."""
    if len(data) >= 84 and not data[:5].lower() == b"solid":
        return STL_HEADER + data[80:]
    return data


def page() -> str:
    """The /terms page: the licence for generated files (linked from the download and order buttons)."""
    from html import escape

    import brand
    return f"""<!doctype html>
<html lang="en">
<head>
{brand.HEAD}
<title>File license · Rocket Builder</title>
<meta name="description" content="The licence for the files Rocket Builder makes: personal use only, don't share or sell them.">
<style>
  /* Page styles; the brand (tokens, fonts, header) is in /static/brand.css. */
  .rb-main {{ max-width:780px; }}
  .box {{ border:1px solid var(--line); border-radius:10px; background:var(--panel); padding:16px 18px; margin:18px 0; }}
  .box .rb-label {{ display:block; margin:0 0 8px; }}
  pre {{ white-space:pre-wrap; overflow-wrap:anywhere; font:13.5px/1.55 var(--font-mono); margin:0; color:var(--ink); }}
  @media (max-width:520px) {{ .box {{ padding:12px; }} pre {{ font-size:11.5px; }} }}
</style>
</head>
<body>
{brand.header("File license")}
<main class="rb-main">
<h1>Rocket Builder file license</h1>
<p class="lede">The rockets you design here are yours to print and fly. The files aren't free to share: please don't upload them, or remixes of them, to MakerWorld, Printables, Thingiverse or any other site. Send friends a link to Rocket Builder instead, so they can design their own.</p>
<div class="box"><span class="rb-label">LICENSE.txt</span><pre>{escape(LICENSE_TEXT)}</pre></div>
<p class="lede">The same text is in LICENSE.txt in every download.</p>
</main>
<footer class="rb-footer"><a href="/">Rocket Builder</a> by <a href="https://quiverdesignworks.net/">Quiver Design Works</a></footer>
</body>
</html>"""
