the-feve/rocket-builder-web/(commit log)

2026-10-08 Rocket Builder Web: geometry engine through Phase 1
    Split out of OS_Rocket_Builder (web/geometry on claude/affectionate-mayer-vy7qhe)
    with the spec and data. Phase 1 adds launch lugs (two / aft only / none),
    the rod standoff part and the anchor strap. Lug rounds are built on the
    lug block before the union, because OpenCascade can't round them on the
    merged part. try_fillet now meshes before trusting is_valid, and
    build_rocket refuses unsound parts. 37 tests pass.
    Claude-Session: https://claude.ai/code/session_01UUL8xK8wcqrD8cBuWf19u9
    [Aft.stl, Anchor_Seg.stl, Motor_Cap.stl, Nose.stl, Rod_Standoff.stl, assembled.stl, derived_printed_dimensions.csv, rocket_global_settings.csv]
2026-10-08 Phase 2 web prototype moved in from OS_Rocket_Builder; dark theme
    server/ is the FastAPI + three.js designer built on OS_Rocket_Builder's
    claude/phase2-web-prototype branch, now pointing at this repo's geometry/.
    The page is dark by default, with a light-mode toggle remembered in
    localStorage.
    Claude-Session: https://claude.ai/code/session_01GpA6jbyhcrgf7Qqic9bid9
2026-10-08 Phase 3 (part): stability check, saved designs and share links, Dockerfile
    - rocketgen/stability.py: Barrowman CP (nose + fins), CG from part
    centroids + loaded motor + recovery allowance. Under 1.0 cal the
    preview shows CG/CP markers but the ZIP is withheld (409). Motor
    masses in data/web_motor_masses.csv (heaviest common motor per size).
    - Server: geometry cached by geometry params only (LRU of 40), so the
    Flight inputs (motor and recovery mass) just redo the stability check.
    - Saved designs in SQLite with share links /d/<id>; an edit key kept in
    the browser stands in for sign-in. My rockets list, Save, Save as new,
    Copy link on the page.
    - Dockerfile (not yet built: Docker Hub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
    [web_motor_masses.csv]
2026-10-08 WIP: motor picker flight sim and fin auto-size (untested, server not yet wired)
    geometry/rocketgen/flight.py ports the Rocket Motor Picker (motor table in
    data/web_motors.csv, replacing web_motor_masses.csv). stability.py gains
    Balance (per-motor margins) and build_stable (scale standard fins until
    stable with the heaviest motor of the size). server/app.py still imports
    the old names; the last working commit is 390287b.
    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
    [web_motor_masses.csv, web_motors.csv]
2026-10-08 Motor picker and auto-sized fins, wired into the designer
    - rocketgen/flight.py: the Rocket Motor Picker's flight sim, motor table
    in data/web_motors.csv. Every motor of the bay size is flown and
    checked for thrust-to-weight, rod speed, apogee and its own stability
    margin; the closest safe one to the target altitude is recommended.
    - stability.build_stable: standard fins grow in span and sweep (not
    root: that moves the CP forward) until the heaviest motor is stable.
    - Page: Flight group (target altitude, motor to check, recovery,
    advanced Cd and rod length) and a motor-picker table; clicking a row
    re-checks stability with that motor. Server builds work again.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
    [app.py, fins.py, stability.py, test_app.py, test_rocket.py]
2026-10-09 Ready to host: health check, rate limits, vendored three.js, CI, Fly.io deploy
    - /healthz; per-address limits on new builds (30 per 10 min) and saves
    (60 per hour); a visitor waits at most 60 s for the build lock, then
    gets a 503; failed builds are logged with their parameters.
    - three.js r160 served from server/static/vendor, no CDN.
    - CI runs both test suites and builds and smoke-tests the Docker image.
    - fly.toml (Seattle, 1 GB, sleeps when idle, volume for SQLite) and a
    deploy workflow on pushes to main that skips until FLY_API_TOKEN is set.
    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
    [app.py, test_app.py]
2026-10-09 Designer: clearer save flow (New rocket, name dialog, status label)
    The owner clicked Save on a design opened from a share link and saw
    no response: it kept the shared design's name, and success showed as a
    small grey line.
    - "New rocket" button: resets to defaults, asks for a name, saves.
    - Save on an unsaved or shared design, and Save as new, ask for a name
    in a dialog first (copies suggest "<name> (copy)"); saving your own
    design still overwrites in one click. Enter saves, Esc/Cancel aborts.
    - Status label next to the name: Not saved yet / Saved · yours to edit /
    Shared design · Save makes your own copy.
    - Save messages are larger and coloured; network and non-JSON errors
    are r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
2026-10-09 Designer: Beginner/Advanced modes, overall height, build prompts, design files
    Beginner mode (default): motor size, printer max height, overall height,
    nose shape, and swept/delta/trapezoid fins; everything else is sent as
    the defaults. Advanced is the full form as before. Switching carries the
    design over (body length <-> overall height from the last build).
    - geometry: overall_length(params) gives nose tip to lowest point without
    building (matches Balance.length to 0.05 mm in tests, incl. swept fins
    below the tail and multi-segment bodies); body_length_for(params, H)
    inverts it, with a friendly error when H is too short.
    - server: BuildRequest.overall_length; _build_to_length rebuil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
    [app.py, test_app.py, test_rocket.py]
2026-10-09 Shorter nose insert; shock-cord strap rotated 90 degrees
    Owner's requests after the first live preview:
    - Nose insert 30% shorter: Derived.nose_shoulder_len = max(0.7 x
    shoulder_len, 7 mm), nose only; body joints keep the full shoulder.
    Nose placement and the anchor section length use it; overall length
    is unchanged.
    - Anchor strap is now a horizontal bridge across a vertical cord
    channel, so the cord drops in from the open top behind the bar. Its
    underside is a 45-degree cone rising from the bore wall plus a
    45-degree pointed arch under the bar: prints upright without supports.
    Channel 0.4 x bore ID (4-8 mm), bar 2 mm, 2.5 mm off the wall; the back
    is trimmed to the bore +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
    [anchor.py, params.py, test_app.py, test_rocket.py]
2026-10-09 Anchor strap: one bar from wall to wall with an arched underside
    Owner's review of the first rotated strap: simplify to a bridge that
    spans wall to wall. The strap is now a straight bar across the bore (a
    chord), 2.5 mm off the wall at its middle, with the cord gap behind it.
    Its underside is a 45-degree pointed arch springing from the wall at both
    ends (the bar thins to nothing against the curved wall there), with 2 mm
    of bar above the apex, so it still prints upright without supports. No
    pads or cone; the anchor section is a few mm shorter again.
    Cord gap 10.4-16.4 mm across (M13-M29). geometry 51 passed, server 9
    passed; every motor size at two body lengths builds a valid, meshable
    ancho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
    [anchor.py, test_rocket.py]
2026-10-09 Anchor strap: round the arch's peak (1.5 mm)
    Owner: the sharp notch at the top of the arch, where the bar is thinnest,
    is a stress riser under cord load. It now has a 1.5 mm round
    (APEX_FILLET; skipped if it won't build, like the other cosmetic rounds).
    The rounded top is a ~2 mm bridge; the overhang test allows exactly that
    face and checks it stays under 3 mm across.
    geometry 51 passed, server 9 passed; every motor size at two body
    lengths still builds a valid, meshable anchor section.
    Claude-Session: https://claude.ai/code/session_012UmPDCssZtYGNfAm4E9Mdx
    [anchor.py, test_rocket.py]
2026-10-09 Advanced: Body OD offset (radial) with a driven Body OD readout
    Owner's request: instead of typing an absolute Body OD, type a radial
    offset from the motor's stock tube (5 mm = 10 mm more diameter); the
    form shows the resulting OD under the field and updates live.
    - BuildRequest.body_od_offset (0-80 mm); the server turns it into
    body_od_override = stock OD + 2 x offset (stock_od(motor)). Older saved
    designs with only body_od_override still build, and the page converts
    them to the matching offset when opened.
    - /api/options gains stock_od per motor; /api/recovery_allowance takes
    the offset.
    - server test: offset 5 -> stock + 10 mm and an inner mount; old
    override still works; overs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
2026-10-09 Advanced: wall thickness for the body tubes, nose cone and motor mount
    Owner's request: a tube thickness adjustment. DesignParams.wall overrides
    the settings CSV's 1.5 mm wall; the form's Advanced > Body section gets
    "Wall thickness, mm" (0.8-3.0, with a nozzle-width hint). Same motor bay,
    so the stock tube is bay + 2 x wall, and the Body OD readout and the
    offset follow it (/api/options gains bay_id per motor).
    Checked: every motor at 0.8/1.2/2.0/3.0 mm walls with clipped-delta and
    swept fins builds valid, meshable parts; geometry test at the extremes
    (M13/M29 x 0.8/3.0). server test: OD grows 2 x the wall change, the
    offset is measured from that wall's stock tube, 0.5 mm is refused.
    geome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
2026-10-10 Show a user guide on the opening screen
    Before the first build the 3D view shows a guide: how to use the app,
    Beginner vs Advanced, what each part of the report means, and what
    OpenRocket is and what to check there. A Guide button reopens it, and
    the report's OpenRocket link jumps to that section.
    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
2026-10-10 Add a key-terms glossary to the user guide
    Explains the ideas behind the report for newcomers: CG, CP, calibers and
    the stability margin (with a diagram), Barrowman, motor codes, thrust and
    impulse, thrust-to-weight, rod speed, apogee, ejection delay, drag,
    field size, recovery and rocket parts. Adds a contents line to the guide.
    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
2026-10-14 Match fevergeon.com / Quiver styling; fix the preview on iPhone and iPad
    - Palette, buttons and header from the shared fevergeon.com / quiverdesignworks.net
    stylesheet; follows the system light/dark setting, header toggle pins one;
    links back to both sites.
    - Preview canvas is sized from its container (absolute, setSize without style),
    so it follows rotation and resizes on iOS; dvh heights and safe-area insets.
    - Phones: preview on top, form, then report; pinned Build bar; guide as a
    full-screen sheet with a Close button. iPad portrait: 320 px form column.
    - Touch: 16 px fields (no iOS focus zoom), decimal keypad, larger targets,
    pinch-to-zoom hint. Render on demand, pause when hid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
2026-10-14 Beginner mode for young builders (grades 3-7)
    - Six numbered steps, each with a plain-language explanation and a link
    into the matching part of the full guide.
    - Motor size lists the real motors that fit; height slider with cm,
    inches and ruler comparisons; fins and nose chosen from pictures.
    - Quick-start welcome: how it works in 4 steps, the cal stability score
    explained with a diagram, a safety-code note, and a link to the full guide.
    - Beginner report: stability meter and what it means, best motor with
    expected height, delay and field size, next steps; full numbers under
    "Grown-up details". On phones the report sits under the 3D view.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
2026-10-14 Docs: rocket.quiverdesignworks.net, live on Fly, current state
    Folds in the unmerged notes from claude/elegant-goodall-elgk3f and PR #7
    (planned address rocket.quiverdesignworks.net, repo rename to
    the-feve/quiverdesignworks-site, glossary merged) and updates the top of
    HANDOFF to today's state.
    Claude-Session: https://claude.ai/code/session_01PFg9rEReHgShsLyu1t276z
2026-10-14 Beginner: guided step-by-step tutorial; always start in Beginner
    - Start designing walks through the six steps one at a time, with the
    other steps, the save bar and the mode switch greyed out and inert.
    Building on the last step (or Finish) unlocks the whole form.
    - Skip tutorial and Go to Advanced on the quick start and the tutorial bar;
    Replay it once done.
    - Every launch starts in Beginner.
    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
2026-10-14 Accounts: email + password sign-up and sign-in; saved rockets belong to the account
    - server/accounts.py: users and sessions in the designs SQLite file; scrypt
    hashes; session token in an HttpOnly cookie (only its hash stored).
    - /api/auth/signup|login|logout|me, /api/my/designs, /api/my/claim.
    Sign-up asks for 13+ or a parent/guardian (the site is used by children).
    - Designs saved signed in are owned by the account and editable from any
    browser; signing in moves this browser's saved rockets into the account.
    - Page: Sign in button, sign-in / create-account dialog, account-aware
    My rockets list.
    Claude-Session: https://claude.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
2026-10-14 Print-order portal with coupon codes; owner Orders page and PC sync; supplies link
    - Order a printed rocket (signed in, stable designs): quantity, colour,
    shipping, notes, coupon. Saves the order and a folder per order
    (<batch>/<order id>/: STLs, ORDER.txt batch sheet, order.json, design.json).
    - Payment isn't built yet: a valid coupon code is required and orders are free.
    - Owner: emailed via Resend when configured; /admin lists orders, sets status,
    downloads files; tools/sync_orders.py copies new orders to a PC folder.
    - My orders for customers.
    - Supplies (Amazon affiliate) link from ROCKETGEN_SUPPLIES_URL, with the
    Associates disclosure; hidden until set.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
2026-10-14 Gear link to the fevergeon.com rocket gear page (header and under the score)
    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
2026-10-14 Order Rocket Supplies page at /ordersupplies; support note on the welcome
    - The Amazon affiliate gear list moves here from fevergeon.com
    (server/gear.json, server/supplies.py): 43 items in 12 categories, each
    with a drawing of its kind (Amazon images need its live API), the
    Associates disclosure, no prices. Items can carry the owner's own photo.
    - Header link renamed "Order Rocket Supplies"; button under the score;
    "Need to get your own supplies...? Order through my link here to support
    me!" at the top of the welcome and the full guide.
    - Narrow phones hide the Quiver link so the header fits.
    Claude-Session: https://claude.ai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
2026-10-14 Supplies: first launch starter kit; "Get these motors" links in the report
    - /ordersupplies opens with a five-item starter kit (gear.json starterKit).
    - Motor items list their motors; the report links the recommended motor's
    Amazon packs (exact delay first; another delay is flagged), with the
    Associates disclosure.
    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
2026-10-14 Supplies: motors for 13, 24 and 29 mm (and C6-7)
    Adds in-stock Amazon listings (checked 2026-10-14) tagged with their motors,
    so builds of every size get a "Get these motors" link: 1/2A3-4T, A3-4T,
    A3-6T, A10-3T (13 mm), C6-7 (18 mm), C11-3, D12-3 (24 mm), F15-4 2-pack and
    bulk (29 mm). Motor names now say their size.
    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
2026-10-14 Printer height before rocket height; tutorial buttons; specs in saved names
    - Beginner step 3 is the printer height, step 4 the rocket height; the
    report's "try" hints point at the right step numbers.
    - Tutorial last step: Back / Finish sit above the pinned Build bar.
    - Saved names and design files carry _<motor>_<fin>_<height>.
    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
2026-10-14 Beginner: printer before height, snap to heights that build, step-7 buttons
    - Tutorial step 3 is now the printer max height and step 4 the rocket
    height: the printer decides which heights work.
    - GET /api/heights returns the overall heights that build for a motor,
    printer and fin/nose shape, plus the lowest printer that builds any
    rocket of that size. rocketgen.build.plan_rocket runs all of
    build_rocket's checks without solids; height_ranges checks plain and
    fully auto-sized fins. The page snaps the height (and a too-short
    printer) to the closest value that builds, with a note and the range.
    - _build_to_length repeats the corrective rebuild until the height
    settles (one round c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
2026-10-14 Big coloured order buttons; retry a build cut off by a restart
    - "Order it printed for you" (blue) and "Order rocket supplies" (amber)
    are large cards with an icon and a subtitle, side by side (stacked on
    phones).
    - A build running while a deploy replaced the machine got an empty reply
    and showed "JSON.parse: unexpected end of data". postBuild retries once
    after 4 s, then says the server didn't answer and to press Build again,
    instead of telling the user to change their settings.
    Claude-Session: https://claude.ai/code/session_01WhBFsEk5G36wekskJ669Qe
2026-10-14 Score advice: what to change outside the 1-2 cal sweet spot
    Outside the sweet spot the build says how to get there, best first, with
    a predicted score for each where it can be worked out without a rebuild:
    rocket height (Balance.predict_length, within about 0.1 cal of real
    rebuilds), fin shape / count / custom size, a lighter or heavier motor,
    nose weight in grams, and a skinnier body. Beginner advice uses the step
    numbers and only Beginner levers.
    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
2026-10-15 Order names with motor and customer code; parachute size; report divider
    - Orders are named RB-<date>-<n>_<motor>_<customer code> (the code is
    the same on every order from one account, no email in file names). The
    name is used for the order folder, admin heading, files ZIP and PC sync.
    - Every build suggests the smallest standard parachute that lands the
    rocket at 4.5 m/s or less after burnout, linked to that size in the
    supplies list, in both reports and build_notes.txt.
    - A drag handle between the 3D view and the report sets the report's
    height (remembered; hidden on phones).
    Claude-Session: https://claude.ai/code/session_0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
2026-10-15 Compare two rockets; launch field size with parachute drift
    - "Compare with another rocket": the rocket on screen against one built
    earlier this visit or one from My rockets, side by side, with the better
    value ticked per row, how they differ in words and each one's summary.
    - Launch field: the NAR minimum for the recommended motor, or longer when
    the rocket drifts further under its parachute in a 10 mph breeze. A card
    in the Beginner report, a line in the full report and the build notes.
    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
2026-10-15 Paid print orders through Stripe Checkout, with a shipping estimate
    - Price per rocket from server/shop.json: base + per gram of plastic.
    - Shipping estimate: the parts packed into the smallest box that fits,
    weighed, priced from a USPS Ground Advantage table (US only).
    - The order dialog shows the price, box and shipping. Without a coupon the
    order waits for payment and the customer pays on Stripe's hosted page
    (shared account, metadata.store = rocket-builder, WA tax, Stripe collects
    the address). /api/stripe-webhook marks it paid and emails the owner.
    Coupons still make free orders. Paid orders ship through the store's
    Pirate Ship CSV.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
2026-10-15 Personal-use file license: downloads, STL headers, /terms, UI notes
    The generated files are licensed for personal use only: print, fly and
    change them for yourself, but don't share, upload or remix them on
    MakerWorld, Printables, Thingiverse or any other site, and don't sell them
    or prints made from them. The wording lives in server/terms.py and goes
    into LICENSE.txt in every ZIP and order folder, the top of the build notes,
    design.json, each STL's header and a /terms page, with short notes by the
    download button, in the Beginner next steps, the order dialog and the guide.
    Claude-Session: https://claude.ai/code/session_01WhBFsEk5G36wek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
2026-10-15 Host Trebuchet Builder in this Fly app at /trebuchet/
    server/trebuchet_mount.py loads the-feve/trebuchet_builder from trebuchet/
    (checked out by the deploy) and mounts it at /trebuchet/; trebuchet.* hosts
    are routed there too. Without the checkout the rocket app runs alone.
    deploy.yml checks out its main branch with TREBUCHET_REPO_TOKEN (skips with
    a warning otherwise), redeploys on a trebuchet-updated dispatch and checks
    the page answers. Owner setup in HANDOFF Next steps 8.
    Claude-Session: https://claude.ai/code/session_01SxK1pXkazRXUVwuJiQp8EX
2026-10-15 Launch simulator page: flight, parachute drift in a set wind, field size
    GET /api/builds/{id}/launch flies a build's motor in 2-D with wind
    (weathercocking off the rod, ejection at burnout + delay, chute drift)
    and sizes the field from the landing spot and the NAR minimum.
    /launch animates it with a wind slider, motor and delay pickers, and a
    top-down field plan; linked from both reports.
    Claude-Session: https://claude.ai/code/session_01UTjkbAdScQd1WPmWr8ZsEW
2026-10-15 Beginner flight card: power and launch-speed bars, and why motors fail
    The 'How high will it go?' card now shows thrust/weight (5x passes) and
    speed off the rod (15 m/s passes) as meters like the stability score.
    When no motor passes, it shows the closest motor's bars, the weight that
    would give 5x, each failing reason in plain words, and what to try.
    Claude-Session: https://claude.ai/code/session_017fgmbBaTHP9MC73xwCm7gZ
2026-10-15 Header: Rocket Builder | Trebuchet Builder switcher; hosting done in HANDOFF
    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
2026-10-15 Keep printed-rocket ordering closed to customers until the owner opens it
    ROCKETGEN_ORDERING=open opens it; unset (the default) keeps it closed.
    While closed, customers see "Printed rockets: coming soon" instead of the
    order button and POST /api/orders answers 403. Admin accounts
    (ROCKETGEN_ADMIN_EMAILS) still see the button and can place coupon or paid
    orders, so Stripe, the webhook, /admin and the PC sync can be tested end to
    end. /api/options carries ordering_open; users carry can_order, and the
    order row redraws on sign-in or sign-out.
    Claude-Session: https://claude.ai/code/session_01FriN7yoJ5RJsfG3vK9Ldn1
2026-10-15 Launch in the 3D view, printer picker, sources page, rocket + trebuchet supplies
    - Watch it launch: a button on the 3D view opens the launch simulator in a
    panel over the canvas (launch.html?embed=1); Back to 3D model returns to
    the same rocket and report without rebuilding. Report links open it too.
    - Your printer: a select of common printers fills Printer max height
    (makers' build heights); typing another height shows Other.
    - /sources: where each calculation and number comes from, with links,
    and our own assumptions marked as such. Linked from the guide, report
    and launch simulator.
    - /ordersupplies: Rocket Builder and Trebuchet Builder sections (the
    trebuchet list read from i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
2026-10-16 Host Fit Test Builder at /fit/ and fit.* hosts, admin-only until opened
    server/fit_mount.py loads the-feve/3D_print_test_fitter from fittest/, like
    the trebuchet mount. HostRouter takes a host -> prefix map. A gate answers
    404 to all but admin accounts until ROCKETGEN_FIT=open, and the fit app
    shares this app's build lock. deploy.yml checks the repo out with
    FIT_REPO_TOKEN (or TREBUCHET_REPO_TOKEN) and checks /fit redirects.
    Claude-Session: https://claude.ai/code/session_014VQhDUjzyQZr4qksxjLNqk
2026-10-17 Advanced: fits and joints inputs, STEP download, link to the fit-test tool
    - Fits and joints (Advanced): joint clearance, body and nose joint lengths,
    thread clearance, pitch and turns. Blank keeps the computed value (shown
    as the placeholder); DesignParams overrides feed compute_derived and
    thread_geometry.
    - Download STEP (ZIP): one STEP per part in print orientation, with the
    licence as a comment, beside the STL ZIP.
    - Generate test fit parts: opens fit.quiverdesignworks.net's Rocket tab
    with this rocket's motor, wall and body OD offset.
    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
2026-10-18 Guide: motor sizing summary, restart tutorial, Advanced help pop-ups, simpler tutorial
    - Quick start opens with How it works only; the stability explainer and a new
    motor letters / sizes / field table sit in a collapsed section, More on rocket
    sizing and rating systems. Altitude ranges come from rocketgen's flight sim at
    typical printed masses; fields from FIELD_M (NAR minimums).
    - Full guide: Sizing a rocket section (class, impulse, sizes, apogee, field).
    - Restart tutorial button next to Beginner / Advanced.
    - Advanced: an (i) on each section heading opens a description of every setting.
    - Tutorial: inactive steps dimmed further and show only their heading; shorter
    Beginner step te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
2026-10-18 Curriculum: 10-day home-school rocketry unit, grades 5-8
    Daily lessons (Newton's laws to launch day), printer and paper-only tracks, a
    5-day version, materials and costs, NGSS/CCSS alignment, safety page, and
    printable worksheets with answer keys (tools/gen_ws.py regenerates them).
    Day 5 altitude ranges match the app's sizing table.
    Claude-Session: https://claude.ai/code/session_014sHySUAPTwnta8LuXdAY6j
2026-10-18 Assembly guide: 7-page printable guide with renders from rocketgen
    Partially exploded and cut-away renders of two generated rockets (three.js in
    headless Chromium), with the shock cord, parachute, wadding, motor and igniter
    added as geometry; lettered part tags drawn over them in the brand style.
    tools/ rebuilds the meshes, images and PDF.
    App: Beginner step 3 says body pieces slide together (only the motor cap is
    threaded).
    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
2026-10-18 Kits: lineup, BOM, packaging dielines and artwork, compliance and tool research
    Starter (M18), Big (M24, in a mailing-tube quiver), Mini (M13) and a classroom
    6-pack, with costs from the generator's masses, dielines and print art in the
    brand, labelling and children's-product notes, and AI design tool research.
    Draft products.json entries for quiverdesignworks-site (not applied).
    gear.json: the motor pack note no longer says to start with an A (an A8 fails
    for most printed 18 mm rockets). HANDOFF and TODO: this session and the
    owner's open questions.
    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
2026-10-18 Curriculum: under-12 paper-rocket track, 12+ printed-rocket track
    Motors and kits are 12+ (owner decision). Younger kids (grades 3-6) fly paper,
    straw, stomp and balloon rockets and use Rocket Builder on screen only; the
    printed rocket on a real motor is the 12+ track. Worksheets tagged by track,
    grade 3-5 standards added, brand tokens linked.
    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
2026-10-18 Launch simulator in the kit-art style; kits use elastic shock cord, 12+
    launch.html: brand tokens and fonts, blueprint sky, the rocket drawn like the
    box art from the build's real proportions (new 'shape' in the launch API),
    orange exhaust and parachute, dashed arc, apogee and field-size markers.
    'Skip to landing' now stays landed after a resize.
    docs/kits: braided flat elastic replaces Kevlar (costs updated); Ages 12+
    recorded as the owner's decision.
    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
2026-10-18 App: Rocket Builder brand look, grouped menus, folding Advanced sections
    Brand tokens (light and dark), Space Grotesk + Inter, the mark in the header,
    favicon and touch icons, CG/CP and meter colours unified. Orange only on the
    main action. A ⋯ menu holds the less-used design-bar actions, the 3D view
    options are one segmented group, Advanced downloads sit behind a ▾ menu, and
    Advanced sections fold (Motor, Body, Fins, Nose open). Ids and form names are
    unchanged. The mode hint hides during the tutorial.
    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
2026-10-18 Shock-cord clearances for elastic cord; assembly guide: CA glue, elastic
    rocketgen: SHOCK_CORDS in params.py (flat 1/8 in elastic on M13/M18, 1/4 in on
    M24/M29, round 1/8 in on all); 3.6 mm per cord pass. The anchor strap slot
    goes from 2.5 to 3.6 mm deep and widens to fit; the M13/M18 nose tie-bar
    recess is deepened so elastic goes round the bar. Still prints without
    supports; new tests check the cord fits the strap and the nose.
    Assembly guide: medium CA (adult only) with scuffing and alcohol, glue safety,
    elastic shock cord sizes, steps 4-5 rewritten; images re-rendered from the new
    geometry. HANDOFF and TODO record the owner's decisions (12+, CA, elastic).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
2026-10-18 Launch simulator: unsafe designs fly (and show why), compare rockets; calmer quick start; self-hosted fonts
    flight.launch_profile: under 1 cal a pitch model makes the rocket wobble,
    under 0 it tumbles with side-on drag; path points carry the attitude;
    flight_dangers() explains what's unsafe in plain words. The launch API flies
    the closest motor when none passes and marks the flight unsafe.
    launch.html: red 'Launch anyway' and a Not safe to fly panel, red phase
    labels (Tumbling!, Crashed), and up to 3 other rockets flown alongside as
    see-through ghosts with a comparison table (builds from this visit and saved
    designs, shared by the designer through sessionStorage).
    index.html: every built r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
2026-10-18 App: header links instead of the builder toggle, test-fit link in both modes, richer save names; brand sheet PDF
    - Header: Free lessons and Trebuchet Builder (beta) links replace the
    Rocket/Trebuchet toggle.
    - 'Print test-fit parts first' under the build buttons in Beginner and
    Advanced (hidden during the tutorial), opening Fit Test Builder with this
    rocket's motor, wall and offset; Fit Test Builder is public now (test).
    - Saved names: Name_Motor_Heightmm_NxFins_Nose, shown with dots in lists and
    previewed in the save dialog; the older form is still stripped.
    - docs/brand/brand-sheet.pdf; round 4 in the expansion spec.
    Claude-S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
2026-10-18 Launch lug bore 4.0 mm on a 1/8 in rod; test-print sets for the three kits
    lugs.LUG_BORE_CLEARANCE = 0.4125 mm per side (was 0.3; the owner's lugs were
    a little snug); the rod standoff clip keeps its snug fit. New test checks the
    bore on the built part.
    docs/kits/test-prints/: Starter M18 300 mm, Big M24 360 mm, Mini M13 190 mm,
    each with lettered STLs (byte-identical to the app's ZIP), design.json for
    Open file, the app ZIP, a README (parts, masses, print settings, motors,
    parachute, shock cord) and a preview; tools/make_test_prints.py rebuilds them.
    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
2026-10-18 Brand look for /sources, /ordersupplies, /terms and /admin; no builder toggle on supplies
    Shared static/brand.css and server/brand.py (head links and the branded
    header); /terms HTML moved to terms.py; admin restyled without changing its
    JS or API calls. The supplies page drops the Rocket/Trebuchet header toggle
    (its section buttons jump between them). Test that the pages use the brand.
    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
2026-10-18 Motor cap: 2.5 mm retention lip over the casing (bigger nozzle hole); kit caps regenerated
    params.CAP_LIP = 2.5: the cap's floor reaches 2.5 mm in from the motor OD,
    covering the cardboard casing (owner, from printed tests); the hole is the
    motor diameter less 5 mm (was less 6.35, the FeatureScript's 1/8 in lip).
    Test added. docs/kits/test-prints regenerated: reprint the caps (E); the
    lighter cap moves the auto-sized fins about 0.02 mm.
    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
2026-10-18 Owner links in the app: Order desk and printed-rocket orders for the admin account
    /api/auth/me now says is_admin (ROCKETGEN_ADMIN_EMAILS); signed in as the
    owner, the account window, My orders and its dialog link the
    quiverdesignworks.net order desk and /admin. Hidden for everyone else. Test.
    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
2026-10-18 Docs: PDFs of the packaging art and dielines, the worksheets PDF, and a docs index
    GitHub shows HTML as code, so every visual page now has a PDF beside it
    (packaging at its real print size). docs/README.md lists them all.
    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
2026-10-18 Printed joint fits from the fit tests: joint 0.18 / nose 0.15 (M13 0.16 / 0.14), 0.5 mm shoulder chamfer
    The CAD fit_slip (0.02 mm) printed far too tight on the first M13 and M18
    kit prints. Defaults now come from the fit-test coupons (ported from
    claude/epic-einstein-4im4l4): separate nose clearance, a chamfer on each
    shoulder's bed edge, a Nose clearance box in Advanced, GENERATOR_VERSION
    0.2.0. Kit test prints regenerated.
    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
2026-10-19 Motor cap: 1.75 mm retention lip and the slimmer cap (1.2 mm wall, 0.4 mm ribs); kit prints regenerated
    Owner: the nozzle hole still looked small; an 18 mm casing wall is about
    2.5 mm, so the lip should reach 1.5-2 mm in from the motor's OD. The
    slimmer cap was asked for on 2026-10-16 but only lived on the fit-test
    branch.
    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
2026-10-19 Assembly guide: cleaner cord drawings, parachute tied on at the nose, clear fold sequence, dashed fillet edges in renders
    Owner feedback 2026-10-19, plus Apogee items (cord >= 3x the rocket and 36 in,
    no glued knots, tug test, wadding sized to the bore, slide-out check). Guide is
    now 8 pages.
    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
2026-10-19 Lessons: elementary (3-5) and middle school (6-8) tracks mapped to Washington's science standards
    /learn is now a chooser with /learn/elementary, /learn/middle and
    /learn/teachers (standards crosswalk incl. the WA Science 2026 draft codes).
    Elementary is paper and air rockets, with the printed rocket as an optional
    instructor demo and Rocket Builder as a class tool. Old /learn/day-NN URLs
    redirect to the middle-school lessons. Worksheets and PDFs per track.
    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
2026-10-21 Lessons: activity pictures and learning-pathway diagrams
    Makes the curriculum more visual (owner's request):
    - art/: a hand-drawn SVG of each lesson's activity (balloon, straw, stomp
    rockets, swing test, parachutes, inclinometer, launch site...) plus the
    design cycle, in the brand line style; inlined into the lesson pages,
    safety pages, the teachers page and the worksheet unit maps.
    - tools/visuals.py: a two-track map on /learn, a phase-by-phase learning
    path on each track page (adult plan-ahead milestones for grades 6-8),
    a "you are here" strip, at-a-glance chips and a minutes bar on each
    lesson, a standards dot grid, and a grade 3-5 to 6-8 progression for
    teachers.
    - Checklis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
